fabianupn/FabianRuizEmbebidos/DATASHEEP/diseño en diagramas de bloques del embebido.pptx

IMPLEMENTAR EL PROCESO DE COMUNICACIÓN INALÁMBRICA PARA EL DISPOSITIVO DE PRUEBAS DE DESMINADO HUMANITARIO MEDICI

## Slide 2

IMPLEMENTAR EL PROCESO DE COMUNICACIÓN INALÁMBRICA PARA EL DISPOSITIVO DE PRUEBAS DE DESMINADO HUMANITARIO MEDICI

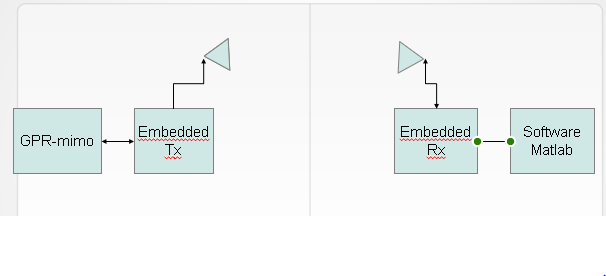
[picture p1: figure]
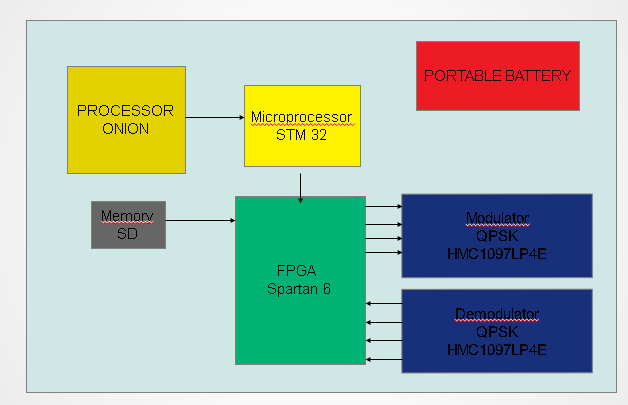
[picture p2: figure]

## Slide 3

Diseño del embebido

PORTABLE BATTERY

PROCESSOR
ONION

Memory
SD

Microprocessor
STM 32

FPGA
Spartan 6

Modulator
QPSK
HMC1097LP4E

Demodulator
QPSK
HMC1097LP4E

## Slide 4
