fabianupn/FabianRuizEmbebidos/Kicad/Partes_digikey_precio.ods

Referencia | Valor | Digikey | Qty | valor_uni_dolar |  |  |  |  | digikey
> C4, C12, C16, C19-C22, C25-C34, C36, C38-C40, C45, C46, C52, C72 | 0.1uF | 1276-1000-1-ND | 55 | 0,1 |  |  | > C4, C12, C16, C19-C22, C25-C34, C36, C38-C40, C45, C46, C52, C72 | 0.1uF | 1276-1000-1-ND | 55
> C1-C3, C6, C8, C9, C11 | 22uF | 1276-6504-1-ND | 7 | 0,34 |  |  | > C1-C3, C6, C8, C9, C11 | 22uF | 1276-6504-1-ND | 7
> C14, C18, C35, C44 | 1uF | 1276-1182-1-ND | 5 | 0,1 |  |  | > C14, C18, C35, C44 | 1uF | 1276-1182-1-ND | 5
> C13, C15, C76, C77, C81, C84, C102, C104, C106, C108, C112, C116 | 2.2uF | 1276-1085-1-ND | 14 | 0,11 | 0 |  | > C13, C15, C76, C77, C81, C84, C102, C104, C106, C108, C112, C116 | 2.2uF | 1276-1085-1-ND | 14
> C17, C47-C49, C53, C54, C57-C61, C63-C66, C82 | 4.7uF | 1276-1045-1-ND | 18 | 0,1 |  |  | > C17, C47-C49, C53, C54, C57-C61, C63-C66, C82 | 4.7uF | 1276-1045-1-ND | 18
> C23, C24 | 10pF | 1276-1027-1-ND | 3 | 0,1 |  |  | > C23, C24 | 10pF | 1276-1027-1-ND | 3
C37 | 10nF | 1276-1009-1-ND | 2 | 0,1 |  |  | C37 | 10nF | 1276-1009-1-ND | 2
> C41, C74 | 10uF | 1276-1192-1-ND | 3 | 0,29 |  |  | > C41, C74 | 10uF | 1276-1192-1-ND | 3
> C42, C43 | 6pF | 1276-2133-1-ND | 3 | 0,1 |  |  | > C42, C43 | 6pF | 1276-2133-1-ND | 3
> C50, C51, C55, C56, C62, C67-C71 | 0.47uF | 1276-2082-1-ND | 10 | 0,1 |  |  | > C50, C51, C55, C56, C62, C67-C71 | 0.47uF | 1276-2082-1-ND | 10
> C75, C78 | 1.8pF | 1276-2218-1-ND | 2 | 0,1 |  |  | > C75, C78 | 1.8pF | 1276-2218-1-ND | 2
C86 | 33pF | 1276-1070-1-ND | 2 | 0,1 |  |  | C86 | 33pF | 1276-1070-1-ND | 2
> C88, C93, C94 | 330nF | 1276-2048-1-ND | 4 | 0,13 |  |  | > C88, C93, C94 | 330nF | 1276-2048-1-ND | 4
C89 | 47pF | 1276-1037-1-ND | 2 | 0,1 |  |  | C89 | 47pF | 1276-1037-1-ND | 2
> C109, C110 | 0 | 311-0.0JRCT-ND | 3 | 0,1 |  |  | > C109, C110 | 0 | 311-0.0JRCT-ND | 3
C118 | 100pF | 1276-1909-1-ND | 2 | 0,1 |  |  | C118 | 100pF | 1276-1909-1-ND | 2
 | 2.2nF | 1276-1987-1-ND | 2 | 0,1 |  |  | 0 | 2.2nF | 1276-1987-1-ND | 2
C121 | 68pF | 1276-6538-1-ND | 2 | 0,1 |  |  | C121 | 68pF | 1276-6538-1-ND | 2
> D1, D8, D9 | LED_GREEN | 846-1176-1-ND | 3 | 0,42
> D2-D6, D12 | LED_BLUE | 160-1837-1-ND | 6 | 0,47
D7 | LED_RED | 160-1436-1-ND | 1 | 0,27
D10 | D_Zener-5.1V-1W | MMSZ5231BT1GOSCT-ND | 1 | 0,23
D11 | SP0502BAHT | F2714CT-ND | 1 | 0,73
FB1 | FILTER | BLM21PG221SN1D | 1 | 0,1
FB2 | SRF2012-900YA | SRF2012-900YACT-ND | 1 | 0,36
J1 | Conn_02x09_Odd_Even | 609-6336-ND | 1
J2 | Conn_02x08_Odd_Even | 609-6336-ND | 1
J3 | Conn_02x10_Top_Bottom | 609-3221-ND | 1
J4 | USB_B_Micro | 609-4618-1-ND | 1
J5 | USB_A | UE27AC54100-ND | 1
J6 | Conn_02x06_Odd_Even | 609-3219-ND | 1 |  |  | 846-1176-1-ND Verde
J7 | Conn_01x03_Male | 732-5316-ND | 1
> L1, L2 | bead, 600R, 350 mA | 587-1897-1-ND | 2
L3 | L | 732-1593-1-ND | 1
> P1, P2 | GSG-RF-CONN | CON-SMA-EDGE-S-ND | 2
Q1 | MOSFET_P | DMP2305UDICT-ND | 1
> R1, R49, R50, R54, R62 | 10k | 311-10KGRCT-ND | 8 | 0,1
> R2, R31, R32, R51, R52, R56, R57, R60, R61, R63 | 470 | 311-470GRCT-ND | 2 | 0,1
> R4, R5, R7, R59 | 1.8k | 311-1.8KGRTR-ND | 4 | 0,1
R6 | 1.2k | 311-1.20KHRCT-ND | 1 | 0,1
R8 | 750 | 311-750HRCT-ND | 7 | 0,1
> R9-R12 | 0 | RMCF0603ZT0R00CT-ND | 4 | 0,1
> R13-R16, R53 | 4.7k | 311-4.70KHRCT-ND | 1 | 0,1
> R3, R17-R20, R55 | 1k | 311-1.00KHRCT-ND | 9 | 0,1
> R21-R23 | 39 | 311-39.0HRCT-ND | 3 | 0,1
> R24-R30, R33-R48 | 200 | 311-200GRCT-ND | 2 | 0,1
R58 | 100 | 311-100HRCT-ND | 5 | 0,1
> R64, R65 | 1.5k | 311-1.5KGRCT-ND | 2 | 0,1
> S1, S2 | FSM1LPTR | 450-1756-1-ND | 2
> S3-S5 | TL1014BF160QG | EG5042CT-ND | 3
> T1, T2 | BALUN | 445-172632-1-ND | 2
U1 | MAX2830 | MAX2830ETM+TCT-ND | 1
U2 | SI5351C | 336-5160-1-ND | 1
U3 | MAX5864 | MAX5864ETM+-ND | 1
U4 | XC6SLX9-2TQG144C | 122-1745-ND | 1
U5 | STM32F722ZET | 497-18558-ND | 1
> U6, U7 | ZLDO1117G33TA | ZLDO1117G33DICT-ND | 2
U8 | ZLDO1117G12TA | ZLDO1117G12DICT-ND | 1
X1 | GSG-XTAL4PIN-25MHz | 535-13468-1-ND | 1
X2 | ASE-xxxMHz | 535-11114-1-ND | 1
X3 | CRYSTAL | 644-1171-1-ND | 1
X4 | GSG-XTAL4PIN-16MHz | 535-10289-1-ND | 1
Extra Capacitors 1 | 3pF | 1276-1597-1-ND | 2
Extra Capacitors 2 | 22pF | 1276-6456-1-ND | 2
Memoria FPGA | CY7C199 | 428-2013-ND | 1 | 3,5
IMU Giroscopio | LSM9DS1 | 497-14946-1-ND | 1 | 6,33
