fabianupn/FabianRuizEmbebidos/Kicad/Partes_digikey_precio_final.ods

Referencia | Valor | Digikey | Qty | valor_uni_dolar | valor_dolar
BT1 | Battery_Cell | BK-870-ND | 1 | 0,54 | 0,54
> C4, C12, C16, C19-C22, C25-C34, C36, C38-C40, C45, C46, C52, C72 | 0.1uF | 1276-1000-1-ND | 48 | 0,1 | 4,8
> C1-C3, C6, C8, C9, C11 | 22uF | 1276-6504-1-ND | 8 | 0,34 | 2,72
> C14, C18, C35, C44 | 1uF | 1276-1182-1-ND | 5 | 0,1 | 0,5
> C13, C15, C76, C77, C81, C84, C102, C104, C106, C108, C112, C116 | 2.2uF | 1276-1085-1-ND | 13 | 0,11 | 1,43
> C17, C47-C49, C53, C54, C57-C61, C63-C66, C82 | 4.7uF | 1276-1045-1-ND | 18 | 0,1 | 1,8
> C23, C24 | 10pF | 1276-1027-1-ND | 3 | 0,1 | 0,3
C37 | 10nF | 1276-1009-1-ND | 2 | 0,1 | 0,2
> C41, C74 | 10uF | 1276-1192-1-ND | 3 | 0,29 | 0,87
> C42, C43 | 6pF | 1276-2133-1-ND | 3 | 0,1 | 0,3
> C50, C51, C55, C56, C62, C67-C71 | 0.47uF | 1276-2082-1-ND | 11 | 0,1 | 1,1
> C75, C78 | 1.8pF | 1276-2218-1-ND | 3 | 0,1 | 0,3
C86 | 33pF | 1276-1070-1-ND | 2 | 0,1 | 0,2
> C88, C93, C94 | 330nF | 1276-2048-1-ND | 4 | 0,13 | 0,52
C89 | 47pF | 1276-1037-1-ND | 2 | 0,1 | 0,2
> C109, C110 | 0 hm | 311-0.0JRCT-ND | 4 | 0,1 | 0,4
C118 | 100pF | 1276-1909-1-ND | 2 | 0,1 | 0,2
C119 | 2.2nF | 1276-1987-1-ND | 2 | 0,1 | 0,2
C121 | 68pF | 1276-6538-1-ND | 2 | 0,1 | 0,2
D1 | D_Zener | MMSZ5231BT1GOSCT-ND | 2 | 0,23 | 0,46
D2 | SP0502BAHT | F2714CT-ND | 1 | 0,73 | 0,73
LED_GREEN | LED | 846-1176-1-ND | 3 | 0,42 | 1,26
LED_BLUE | LED | 160-1837-1-ND | 6 | 0,47 | 2,82
LED_RED | LED | 160-1436-1-ND | 1 | 0,27 | 0,27
FB1 | FILTER | 490-1054-1-ND | 3 | 0,1 | 0,3
J1 | USB_A | UE27AC54100-ND | 1 | 0,6 | 0,6
J2 | Barrel_Jack_Switch | CP-002A-ND | 1 | 0,6 | 0,6
J3 | Conn_02x06_Odd_Even | 609-6336-ND | 1 | 0,89 | 0,89
> J4, J6 | Conn_02x10_Odd_Even | 609-6336-ND | 2 | 0,89 | 1,78
J5 | Conn_02x06 | 609-3221-ND | 1 | 0,72 | 0,72
> J7, J8 | Conn_Coaxial | CON-SMA-EDGE-S-ND | 2 | 1,74 | 3,48
L1 | L | 732-1593-1-ND | 2 | 0,17 | 0,34
L2 | SRF2012-900YA | SRF2012-900YACT-ND | 1 | 0,36 | 0,36
L3 | bead, 600R, 350 mA | 587-1897-1-ND | 2 | 0,1 | 0,2
Q1 | MOSFET_P | DMP2305UDICT-ND | 1 | 0,51 | 0,51
> R1, R12-R15 | 100. | 311-100HRCT-ND | 6 | 0,1 | 0,6
> R2, R6, R7, R17-R19, R49 | 750. | 311-750HRCT-ND | 8 | 0,1 | 0,8
> R3, R4 | 470. | 311-470GRCT-ND | 3 | 0,1 | 0,3
> R5, R8, R16, R23-R26, R28 | 10k | 311-10KGRCT-ND | 9 | 0,1 | 0,9
> R9, R10 | 1.5k | 311-1.5KGRCT-ND | 3 | 0,1 | 0,3
> R20, R21 | 200. | 311-200GRCT-ND | 3 | 0,1 | 0,3
R22 | 4.7k | 311-4.70KHRCT-ND | 2 | 0,1 | 0,2
> R27, R29-R31 | 1.8k | 311-1.8KGRCT-ND | 5 | 0,1 | 0,5
> R32-R34 | 39. | 311-39.0HRCT-ND | 4 | 0,1 | 0,4
> R35-R43 | 1k | 311-1.00KHRCT-ND | 10 | 0,1 | 1
R46 | 1.2k | 311-1.20KHRCT-ND | 2 | 0,1 | 0,2
> R44, R45, R47, R48 | 0 ohm | RMCF0603ZT0R00CT-ND | 5 | 0,1 | 0,5
> T1, T2 | BALUN | 445-172632-1-ND | 2 | 0,35 | 0,7
> U1-U3 | ZLDO1117G33TA | ZLDO1117G33DICT-ND | 3 | 0,5 | 1,5
 | ZLDO1117G12TA | ZLDO1117G12DICT-ND | 2 | 0,5 | 1
> U4, U8, U11-U13 | FSM1LPTR | 450-1756-1-ND | 5 | 0,48 | 2,4
U5 | STM32F722ZET | 497-18558-ND | 1 | 10,74 | 10,74
U6 | LSM9DS1 | 497-14946-1-ND | 1 | 6,33 | 6,33
U9 | CY7C199 | 428-2013-ND | 1 | 3,5 | 3,5
U10 | lx9_XC6SLX9-TQ144 | 122-1745-ND | 1 | 16,52 | 16,52
U14 | SI5351C | 336-5160-1-ND | 1 | 2,42 | 2,42
U15 | MAX5864 | MAX5864ETM+-ND | 1 | 11,21 | 11,21
U16 | MAX2830 | MAX2830ETM+TCT-ND | 1 | 10,65 | 10,65
X1 | Oscillator_ASE-xxxMHz | 535-11114-1-ND | 1 | 3,3 | 3,3
Y1 | ABM8G-16.000MHZ-B4Y-T | 535-10289-1-ND | 1 | 0,73 | 0,73
Y2 | Crystal | 644-1171-1-ND | 1 | 0,68 | 0,68
Y3 | ABM8G-25.000MHZ-B4Y-T | 535-13468-1-ND | 1 | 0,74 | 0,74
 | conector furuta | 670-2760-ND | 2 | 1,4 | 2,8
 | pin conector Furura | 670-2371-1-ND | 10 | 0,135 | 1,35
 | Regleta onion 2mm x 50 pin | 1212-1317-ND | 1 | 3,32 | 3,32
 |  |  |  | total | $117,99
 |  |  |  | Dólar en pesos | $3.300.000
 |  |  |  | Pesos CO | $389.367.000
