fabianupn/FabianRuizEmbebidos/FPGA_blink_Fabian/build/par_usage_statistics.html

Par Statistics

Total Non-vccgnd Signals=35

Total Non-vccgnd Design Pins=43

Total Non-vccgnd Conns=43

Total Non-vccgnd Timing Constrained Conns=42

Phase 1 CPU=4.3 sec

Phase 2 CPU=4.4 sec

Phase 3 CPU=4.4 sec

Phase 4 CPU=4.7 sec

Phase 5 CPU=4.8 sec

Phase 6 CPU=4.8 sec

Phase 7 CPU=4.8 sec

Phase 8 CPU=4.8 sec

Phase 9 CPU=4.8 sec

Phase 10 CPU=4.8 sec

AvgWirelenPerPin Fanout 1=1.0

AvgWirelenPerPin Fanout 2=9.5

AvgWirelenPerPin Fanout 3=0.0

AvgWirelenPerPin Fanout 4=0.0

AvgWirelenPerPin Fanout 10=9.4

AvgWirelenPerPin Fanout 50=0.0

AvgWirelenPerPin Fanout 100=0.0

AvgWirelenPerPin Fanout 500=0.0

AvgWirelenPerPin Fanout 5000=0.0

AvgWirelenPerPin Fanout 20000=0.0

AvgWirelenPerPin Fanout 50000=0.0

AvgWirelenPerPin Fanout 100000=0.0

IRR Gamma=1.0000
