fabianupn/FabianRuizEmbebidos/FPGA_blink_Fabian/build/usage_statistics_webtalk.html

### Device Usage Page (usage_statistics_webtalk.html)

This HTML page displays the device usage statistics that will be sent to Xilinx.

Software Version and Target Device
Product Version: | ISE:14.7 (WebPack) - P.20131013 | Target Family: | Spartan6
OS Platform: | LIN64 | Target Device: | xc6slx9
Project ID (random number) | 10fbea5e907045f1b1f9a360dd57dfcd.abb45f5133fd478d852d747b6dedc89e.1 | Target Package: | tqg144
Registration ID | 210656542_0_0_533 | Target Speed: | -2
Date Generated | 2019-07-25T10:19:05 | Tool Flow | CommandLine

User Environment
OS Name | Ubuntu | OS Release | Ubuntu 18.04.2 LTS
CPU Name | Intel(R) Core(TM) i3-2348M CPU @ 2.30GHz | CPU Speed | 894.454 MHz
OS Name | Ubuntu | OS Release | Ubuntu 18.04.2 LTS
CPU Name | Intel(R) Core(TM) i3-2348M CPU @ 2.30GHz | CPU Speed | 1802.996 MHz

Device Usage Statistics
Macro Statistics | Miscellaneous Statistics | Net Statistics | Site Usage

MiscellaneousStatistics

AGG_BONDED_IO=3

AGG_IO=3

AGG_LOCED_IO=3

AGG_SLICE=8

NUM_BONDED_IOB=3

NUM_BSFULL=24

NUM_BSLUTONLY=1

NUM_BSREGONLY=1

NUM_BSUSED=26

NUM_BUFG=1

NUM_IOB_FF=1

NUM_LOCED_IOB=3

NUM_LOGIC_O5ANDO6=1

NUM_LOGIC_O5ONLY=23

NUM_LUT_RT_DRIVES_CARRY4=1

NUM_LUT_RT_EXO6=1

NUM_LUT_RT_O6=23

NUM_OLOGIC2=1

NUM_SLICEL=7

NUM_SLICEX=1

NUM_SLICE_CARRY4=7

NUM_SLICE_CONTROLSET=1

NUM_SLICE_CYINIT=50

NUM_SLICE_FF=25

NUM_SLICE_UNUSEDCTRL=1

NUM_UNUSABLE_FF_BELS=7

NetStatistics

NumNets_Active=39

NumNets_Vcc=1

NumNodesOfType_Active_BOUNCEIN=6

NumNodesOfType_Active_BUFGOUT=1

NumNodesOfType_Active_BUFHINP2OUT=2

NumNodesOfType_Active_CLKPIN=8

NumNodesOfType_Active_CLKPINFEED=2

NumNodesOfType_Active_DOUBLE=2

NumNodesOfType_Active_GENERIC=2

NumNodesOfType_Active_GLOBAL=11

NumNodesOfType_Active_INPUT=7

NumNodesOfType_Active_IOBIN2OUT=1

NumNodesOfType_Active_IOBOUTPUT=1

NumNodesOfType_Active_LUTINPUT=25

NumNodesOfType_Active_OUTBOUND=26

NumNodesOfType_Active_OUTPUT=34

NumNodesOfType_Active_PADINPUT=1

NumNodesOfType_Active_PADOUTPUT=1

NumNodesOfType_Active_PINBOUNCE=7

NumNodesOfType_Active_PINFEED=36

NumNodesOfType_Active_PINFEED2=1

NumNodesOfType_Active_QUAD=4

NumNodesOfType_Active_REGINPUT=1

NumNodesOfType_Active_SINGLE=4

SiteStatistics

BUFG-BUFGMUX=1

IOB-IOBS=3

SiteSummary

BUFG=1

BUFG_BUFG=1

CARRY4=7

HARD0=1

IOB=3

IOB_IMUX=2

IOB_INBUF=2

IOB_OUTBUF=1

LUT5=24

LUT6=25

OLOGIC2=1

OLOGIC2_OUTFF=1

PAD=3

PULL_OR_KEEP1=1

REG_SR=25

SLICEL=7

SLICEX=1

Configuration Data
IOB_OUTBUF DRIVEATTRBOX=[12:1] SLEW=[SLOW:1] SUSPEND=[3STATE:1] | OLOGIC2 CLK0=[CLK0_INV:0] [CLK0:1] OLOGIC2_OUTFF CK0=[CK0_INV:0] [CK0:1] OUTFFTYPE=[FF:1] SRINIT_OQ=[0:1] | PULL_OR_KEEP1 PULLTYPE=[PULLUP:1] REG_SR CK=[CK:25] [CK_INV:0] LATCH_OR_FF=[FF:25] SRINIT=[SRINIT0:25] SYNC_ATTR=[ASYNC:25] | SLICEL CLK=[CLK:6] [CLK_INV:0] SLICEX CLK=[CLK:1] [CLK_INV:0]

Pin Data
BUFG I0=1 O=1 BUFG_BUFG I0=1 O=1 CARRY4 CIN=6 CO3=6 CYINIT=1 DI0=6 DI1=6 DI2=6 DI3=6 O0=7 O1=6 O2=6 O3=6 S0=7 S1=6 S2=6 S3=6 | HARD0 0=1 IOB I=2 O=1 PAD=3 IOB_IMUX I=2 OUT=2 IOB_INBUF OUT=2 PAD=2 IOB_OUTBUF IN=1 OUT=1 LUT5 O5=24 LUT6 A4=24 A6=25 O6=25 OLOGIC2 CLK0=1 D1=1 OQ=1 | OLOGIC2_OUTFF CK0=1 D1=1 Q=1 PAD PAD=3 PULL_OR_KEEP1 PAD=1 REG_SR CK=25 D=25 Q=25 SLICEL A4=6 A6=7 AMUX=1 AQ=6 B4=6 B6=6 BQ=6 C4=6 C6=6 CIN=6 CLK=6 COUT=6 CQ=6 D4=6 D6=6 DQ=6 | SLICEX AQ=1 AX=1 CLK=1

Software Quality
Run Statistics
Program Name | Runs Started | Runs Finished | Errors | Fatal Errors | Internal Errors | Exceptions | Core Dumps
bitgen | 212 | 212 | 0 | 0 | 0 | 0 | 0
map | 225 | 214 | 0 | 0 | 0 | 0 | 0
netgen | 43 | 43 | 0 | 0 | 0 | 0 | 0
ngdbuild | 225 | 224 | 0 | 0 | 0 | 0 | 0
par | 214 | 212 | 0 | 0 | 0 | 0 | 0
trce | 128 | 128 | 0 | 0 | 0 | 0 | 0
xst | 309 | 304 | 0 | 0 | 0 | 0 | 0

Unisim Statistics
NGDBUILD_PRE_UNISIM_SUMMARY
NGDBUILD_NUM_BUFGP=1 | NGDBUILD_NUM_FD=26 | NGDBUILD_NUM_GND=1 | NGDBUILD_NUM_INV=1
NGDBUILD_NUM_LUT1=24 | NGDBUILD_NUM_MUXCY=24 | NGDBUILD_NUM_OBUF=1 | NGDBUILD_NUM_VCC=1

NGDBUILD_NUM_XORCY=25
NGDBUILD_POST_UNISIM_SUMMARY
NGDBUILD_NUM_BUFG=1 | NGDBUILD_NUM_FD=26 | NGDBUILD_NUM_GND=1 | NGDBUILD_NUM_IBUF=1
NGDBUILD_NUM_IBUFG=1 | NGDBUILD_NUM_INV=1 | NGDBUILD_NUM_LUT1=24 | NGDBUILD_NUM_MUXCY=24
NGDBUILD_NUM_OBUF=1 | NGDBUILD_NUM_PULLUP=1 | NGDBUILD_NUM_VCC=1 | NGDBUILD_NUM_XORCY=25

XST Command Line Options
XST_OPTION_SUMMARY
-top=<design_top> | -p=xc6slx9-2tqg144 | -opt_mode=Area | -opt_level=1
-ifn=<fname>.prj | -ifmt=mixed | -ofn=<design_top> | -ofmt=NGC

-rtlview=yes
