fabianupn/FabianRuizEmbebidos/onion/xc3sprog_programa_manual/xc3sprog-master/cables/ft2232_cable.pdf

### CONN1

### DLP2232M U2

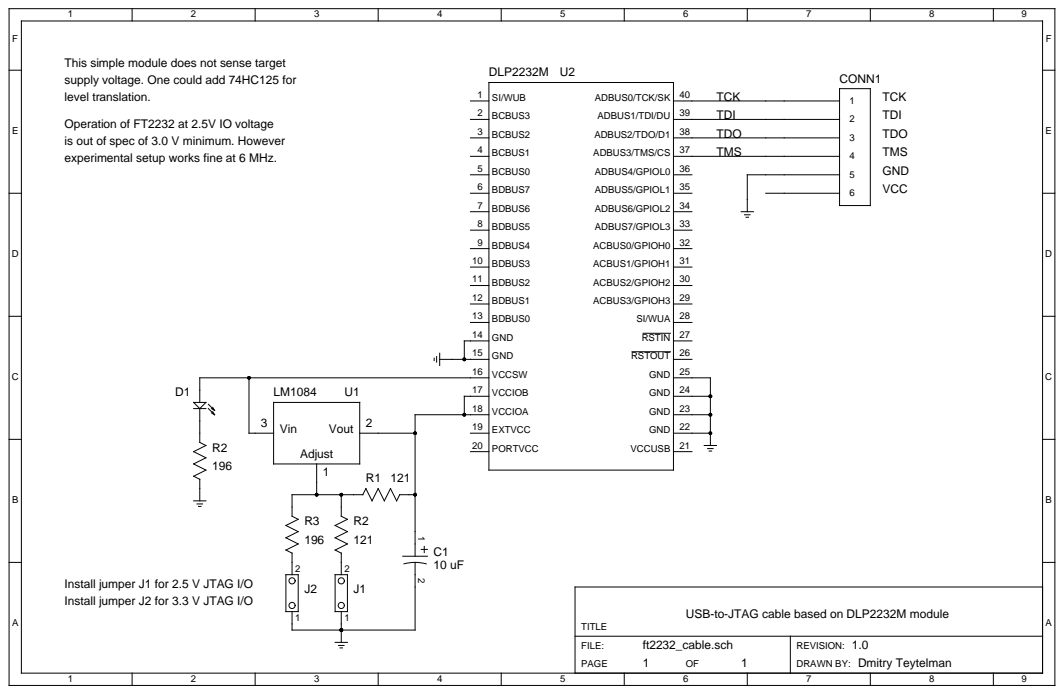
[picture p5: page 1]

This simple module does not sense target
supply voltage. One could add 74HC125 for
level translation.

Operation of FT2232 at 2.5V IO voltage
is out of spec of 3.0 V minimum. However
experimental setup works fine at 6 MHz.

Install jumper J1 for 2.5 V JTAG I/O
Install jumper J2 for 3.3 V JTAG I/O

USB-to-JTAG cable based on DLP2232M module
