fabianupn/FabianRuizEmbebidos/Kicad/power.kicad_pcb

## KiCad design Kicad/power.kicad_pcb (2019-07-23)

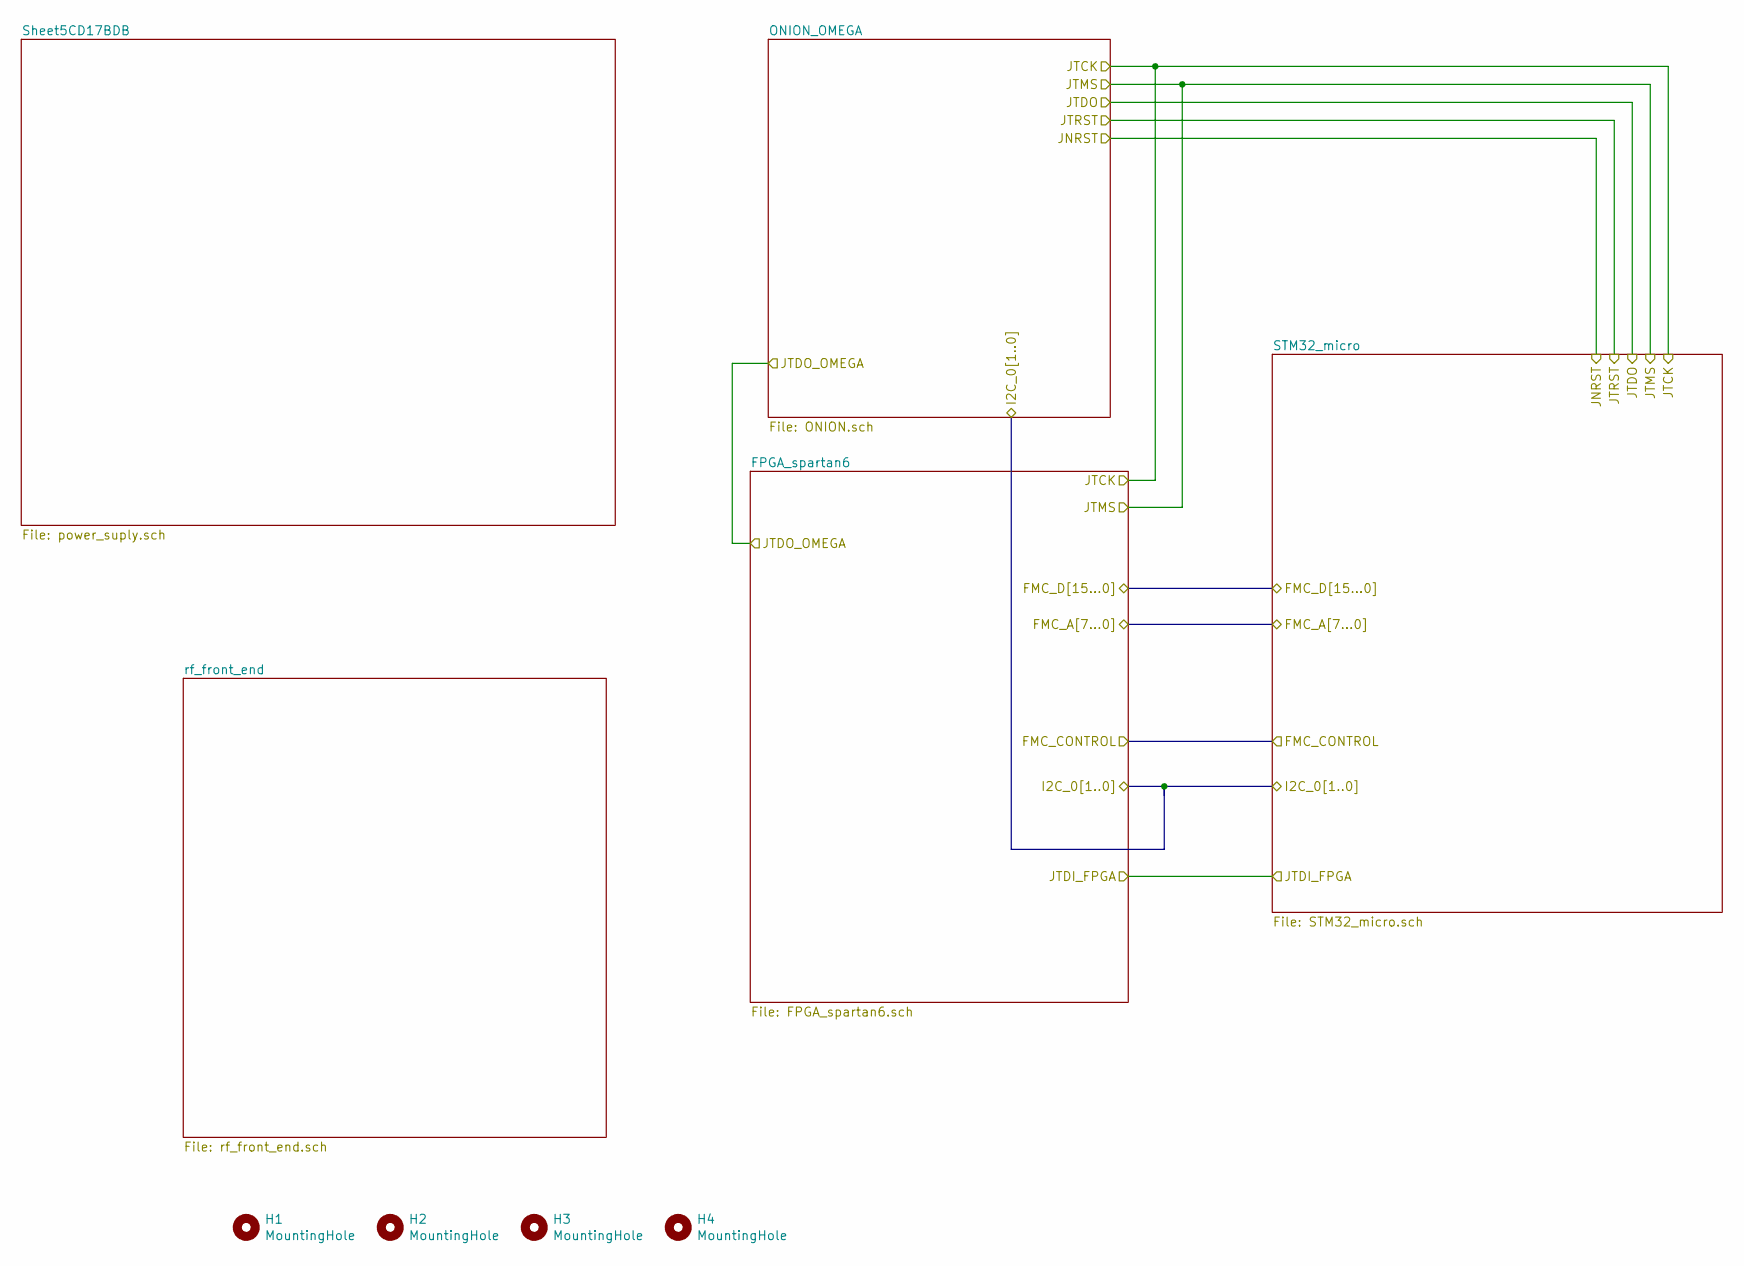
[picture p6: schematic power.sch]

Parts:
H1, H2, H3, H4: MountingHole; MountingHole_2.7mm_M2.5_ISO14580_Pad

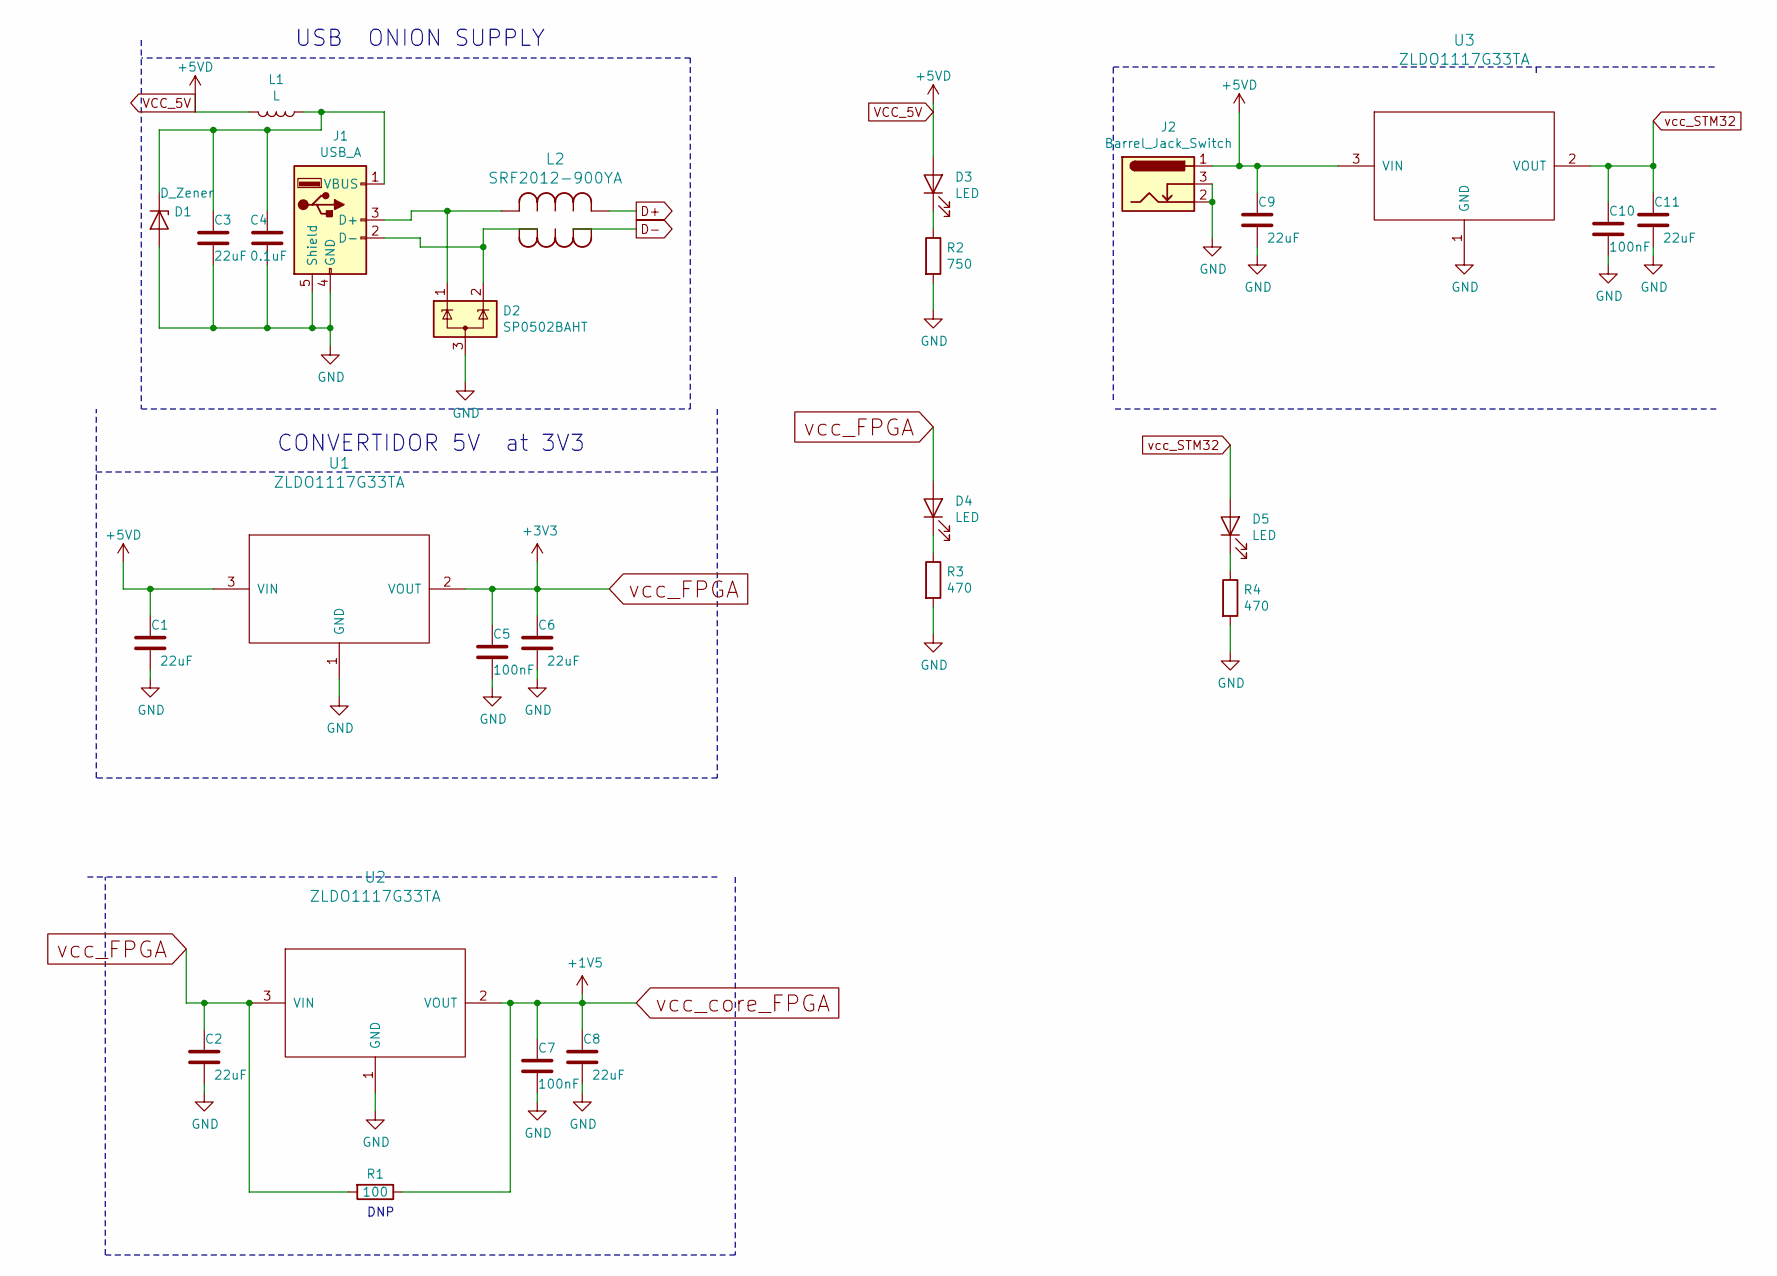
[picture p7: schematic power_suply.sch]

Parts:
C1, C2, C3, C6, C8, C9, C11: 22uF; C_0603_1608Metric_Pad1.05x0.95mm_HandSolder
C4: 0.1uF; C_0603_1608Metric_Pad1.05x0.95mm_HandSolder
C5, C7, C10: 100nF; C_0603_1608Metric_Pad1.05x0.95mm_HandSolder
D1: D_Zener; D_SOD-123; digikey MMSZ5231BT1GOSCT-ND
D2: SP0502BAHT; SOT-23
D3: LED; LED_0603_1608Metric_Pad1.05x0.95mm_HandSolder; digikey 160-1436-1-ND rojo
D4: LED; LED_0603_1608Metric_Pad1.05x0.95mm_HandSolder; digikey 846-1176-1-ND Verde
D5: LED; LED_0603_1608Metric_Pad1.05x0.95mm_HandSolder; digikey 160-1837-1-ND azul
J1: USB_A; USB_A_CNCTech_1001-011-01101_Horizontal
J2: Barrel_Jack_Switch; CUI_PJ-002A; digikey CP-002A-ND
L1: L; L_0603_1608Metric_Pad1.05x0.95mm_HandSolder; digikey 732-1593-1-ND
L2: SRF2012-900YA
R1: 100; R_0603_1608Metric_Pad1.05x0.95mm_HandSolder
R2: 750; R_0603_1608Metric_Pad1.05x0.95mm_HandSolder
R3, R4: 470; R_0603_1608Metric_Pad1.05x0.95mm_HandSolder
U1, U2, U3: ZLDO1117G33TA; SOT-223-3_TabPin2

Connections:
D+: L2.2; also elsewhere on the board
D-: L2.3; also elsewhere on the board
GND: C1.2, C2.2, C3.2, C4.2, C5.2, C6.2, C7.2, C8.2, C9.2, C10.2, C11.2, D1.2 (A), D2.3 (A), J1.4 (GND), J1.5 (Shield), J2.2, J2.3, R2.2, R3.2, R4.2, U1.1 (GND), U2.1 (GND), U3.1 (GND); also elsewhere on the board
unnamed: C3.1, C4.1, D1.1 (K), J1.1 (VBUS), L1.1
unnamed: D2.1 (K), J1.3 (D+), L2.1
unnamed: D2.2 (K), J1.2 (D-), L2.4
unnamed: D3.1 (K), R2.1
unnamed: D4.1 (K), R3.1
unnamed: D5.1 (K), R4.1
VCC_5V: C1.1, C9.1, D3.2 (A), J2.1, L1.2, U1.3 (VIN), U3.3 (VIN); also elsewhere on the board
vcc_FPGA: C2.1, C5.1, C6.1, D4.2 (A), R1.2, U1.2 (VOUT), U2.3 (VIN); also elsewhere on the board
vcc_STM32: C10.1, C11.1, D5.2 (A), U3.2 (VOUT); also elsewhere on the board
vcc_core_FPGA: C7.1, C8.1, R1.1, U2.2 (VOUT); also elsewhere on the board

Notes on the sheet:
USB ONION SUPPLY
CONVERTIDOR 5V at 3V3
DNP

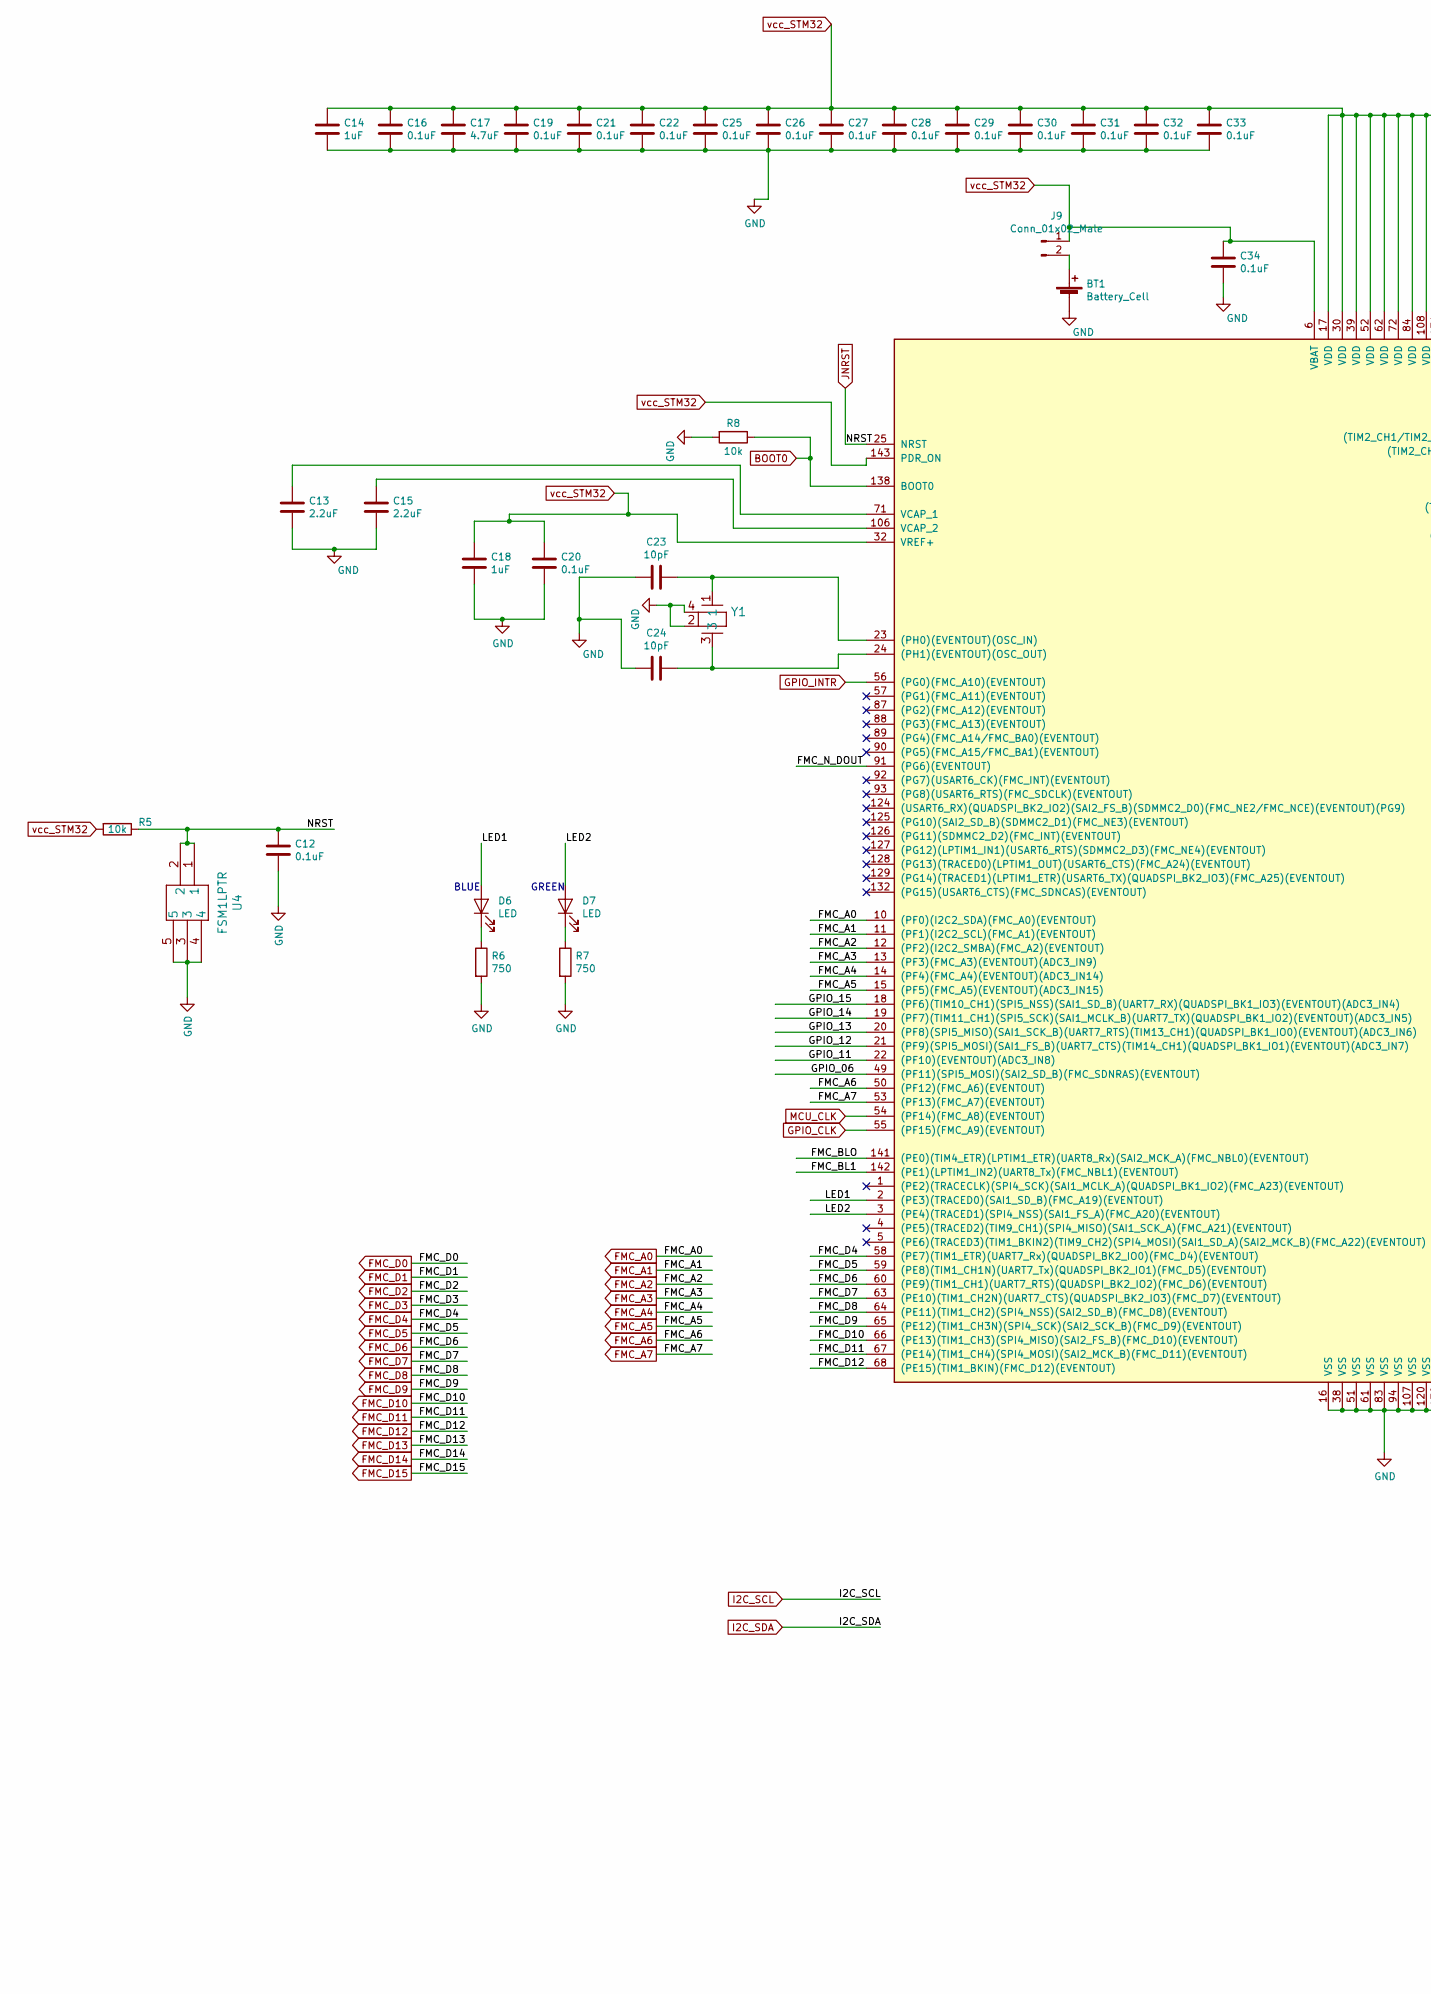
[picture p8: schematic STM32_micro.sch, part in row 1, column 1]

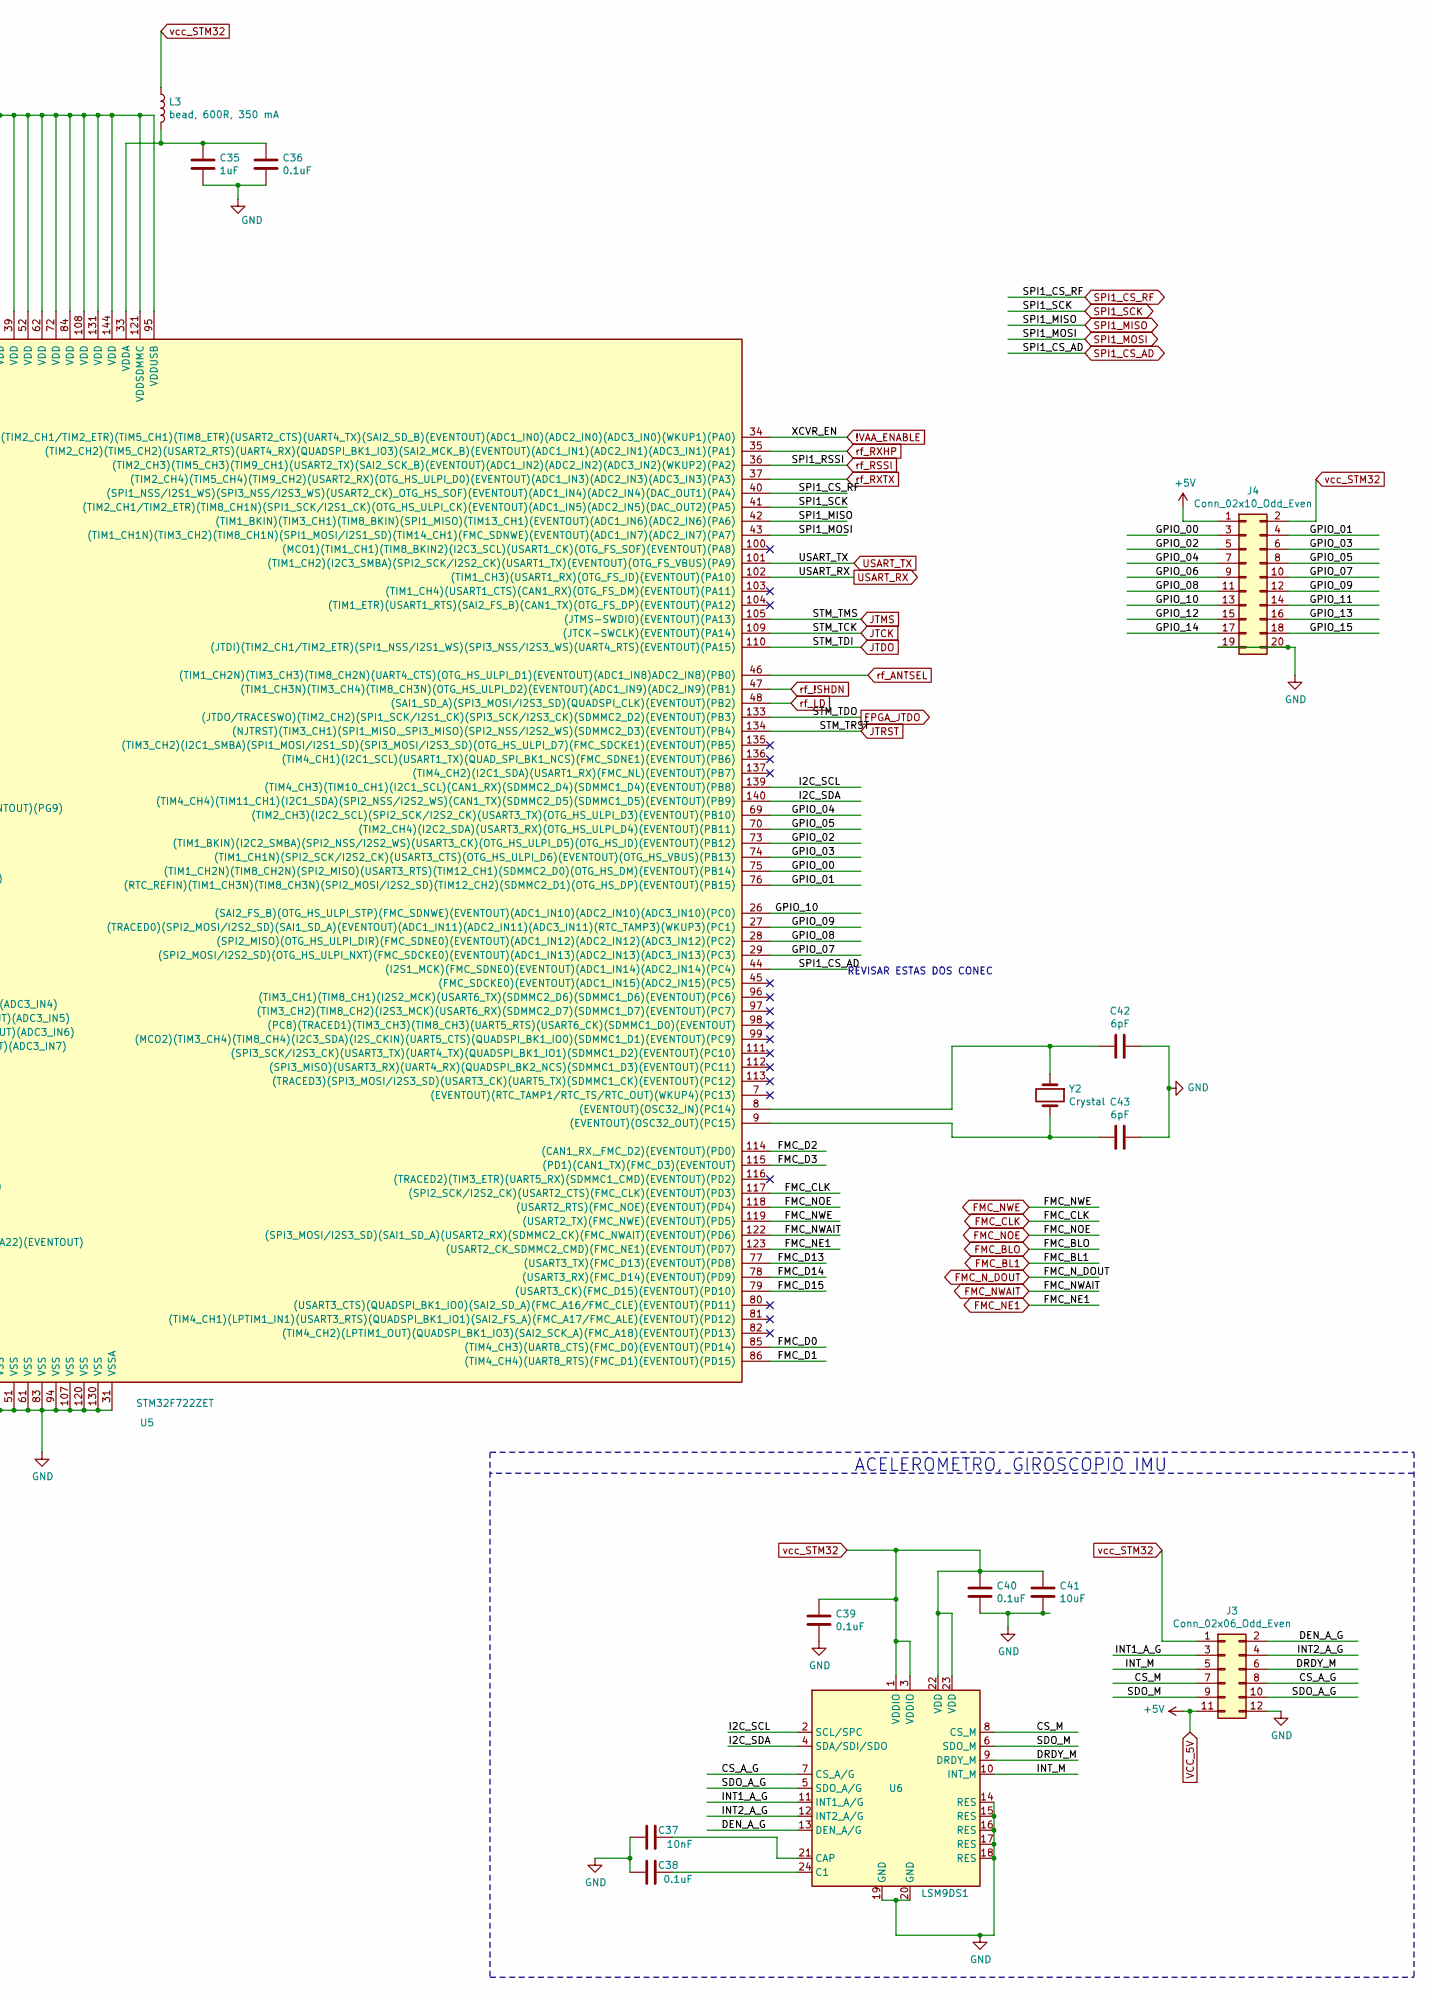
[picture p9: schematic STM32_micro.sch, part in row 1, column 2]

Parts:
BT1: Battery_Cell; MPD_BK-870
C12, C16, C19, C20, C21, C22, C25, C26, C27, C28, C29, C30, C31, C32, C33, C34, C36, C38, C39, C40: 0.1uF; C_0603_1608Metric_Pad1.05x0.95mm_HandSolder
C13, C15: 2.2uF; C_0603_1608Metric_Pad1.05x0.95mm_HandSolder
C14, C18, C35: 1uF; C_0603_1608Metric_Pad1.05x0.95mm_HandSolder
C17: 4.7uF; C_0603_1608Metric_Pad1.05x0.95mm_HandSolder
C23, C24: 10pF; C_0603_1608Metric_Pad1.05x0.95mm_HandSolder
C37: 10nF; C_0603_1608Metric_Pad1.05x0.95mm_HandSolder
C41: 10uF; C_0603_1608Metric_Pad1.05x0.95mm_HandSolder
C42, C43: 6pF; C_0603_1608Metric_Pad1.05x0.95mm_HandSolder
D6: LED; LED_0603_1608Metric_Pad1.05x0.95mm_HandSolder; digikey 160-2032-1-ND BLUE
D7: LED; LED_0603_1608Metric_Pad1.05x0.95mm_HandSolder; digikey 846-1176-1-ND Verde
J3: Conn_02x06_Odd_Even; PinHeader_2x06_P2.54mm_Vertical
J4: Conn_02x10_Odd_Even; PinHeader_2x10_P2.54mm_Vertical; digikey S6106-ND
J9: Conn_01x02_Male; PinHeader_1x02_P2.54mm_Vertical
L3: bead, 600R, 350 mA; L_0603_1608Metric_Pad1.05x0.95mm_HandSolder
R5, R8: 10k; R_0603_1608Metric_Pad1.05x0.95mm_HandSolder
R6, R7: 750; R_0603_1608Metric_Pad1.05x0.95mm_HandSolder
U4: FSM1LPTR; digikey 450-1756-1-ND
U5: STM32F722ZET; LQFP-144_20x20mm_P0.5mm; digikey 497-18558-ND
U6: LSM9DS1; LGA-24L_3x3.5mm_P0.43mm; digikey 497-14946-1-ND
Y1: ABM8G-16.000MHZ-B4Y-T; GSG-XTAL3.2x2.5mm; digikey 535-10289-1-ND
Y2: Crystal; NX3215SA

Connections:
!VAA_ENABLE: U5.34 ((TIM2_CH1/TIM2_ETR)(TIM5_CH1)(TIM8_ETR)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); also elsewhere on the board
/STM32_micro/CS_A_G: J3.8, U6.7 (CS_A/G)
/STM32_micro/CS_M: J3.7, U6.8 (CS_M)
/STM32_micro/DEN_A_G: J3.2, U6.13 (DEN_A/G)
/STM32_micro/DRDY_M: J3.6, U6.9 (DRDY_M)
/STM32_micro/GPIO_00: J4.3, U5.75 ((TIM1_CH2N)(TIM8_CH2N)(SPI2_MISO)(USART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)
/STM32_micro/GPIO_01: J4.4, U5.76 ((RTC_REFIN)(TIM1_CH3N)(TIM8_CH3N)(SPI2_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)
/STM32_micro/GPIO_02: J4.5, U5.73 ((TIM1_BKIN)(I2C2_SMBA)(SPI2_NSS/I2S2_WS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)
/STM32_micro/GPIO_03: J4.6, U5.74 ((TIM1_CH1N)(SPI2_SCK/I2S2_CK)(USART3_CT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)
/STM32_micro/GPIO_04: J4.7, U5.69 ((TIM2_CH3)(I2C2_SCL)(SPI2_SCK/I2S2_CK)(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)
/STM32_micro/GPIO_05: J4.8, U5.70 ((TIM2_CH4)(I2C2_SDA)(USART3_RX)(OTG_HS_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)
/STM32_micro/GPIO_06: J4.9, U5.49 ((PF11)(SPI5_MOSI)(SAI2_SD_B)(FMC_SDNRAS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)
/STM32_micro/GPIO_07: J4.10, U5.29 ((SPI2_MOSI/I2S2_SD)(OTG_HS_ULPI_NXT)(FM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)
/STM32_micro/GPIO_08: J4.11, U5.28 ((SPI2_MISO)(OTG_HS_ULPI_DIR)(FMC_SDNE0)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)
/STM32_micro/GPIO_09: J4.12, U5.27 ((TRACED0)(SPI2_MOSI/I2S2_SD)(SAI1_SD_A)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)
/STM32_micro/GPIO_10: J4.13, U5.26 ((SAI2_FS_B)(OTG_HS_ULPI_STP)(FMC_SDNWE)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)
/STM32_micro/GPIO_11: J4.14, U5.22 ((PF10)(EVENTOUT)(ADC3_IN8))
/STM32_micro/GPIO_12: J4.15, U5.21 ((PF9)(SPI5_MOSI)(SAI1_FS_B)(UART7_CTS)(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)
/STM32_micro/GPIO_13: J4.16, U5.20 ((PF8)(SPI5_MISO)(SAI1_SCK_B)(UART7_RTS)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)
/STM32_micro/GPIO_14: J4.17, U5.19 ((PF7)(TIM11_CH1)(SPI5_SCK)(SAI1_MCLK_B)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)
/STM32_micro/GPIO_15: J4.18, U5.18 ((PF6)(TIM10_CH1)(SPI5_NSS)(SAI1_SD_B)(U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)
/STM32_micro/INT1_A_G: J3.3, U6.11 (INT1_A/G)
/STM32_micro/INT2_A_G: J3.4, U6.12 (INT2_A/G)
/STM32_micro/INT_M: J3.5, U6.10 (INT_M)
/STM32_micro/LED1: D6.2 (A), U5.2 ((PE3)(TRACED0)(SAI1_SD_B)(FMC_A19)(EVEN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)
/STM32_micro/LED2: D7.2 (A), U5.3 ((PE4)(TRACED1)(SPI4_NSS)(SAI1_FS_A)(FMC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)
/STM32_micro/SDO_A_G: J3.10, U6.5 (SDO_A/G)
/STM32_micro/SDO_M: J3.9, U6.6 (SDO_M)
BOOT0: R8.1, U5.138 (BOOT0); also elsewhere on the board
FMC_A0: U5.10 ((PF0)(I2C2_SDA)(FMC_A0)(EVENTOUT)); also elsewhere on the board
FMC_A1: U5.11 ((PF1)(I2C2_SCL)(FMC_A1)(EVENTOUT)); also elsewhere on the board
FMC_A2: U5.12 ((PF2)(I2C2_SMBA)(FMC_A2)(EVENTOUT)); also elsewhere on the board
FMC_A3: U5.13 ((PF3)(FMC_A3)(EVENTOUT)(ADC3_IN9)); also elsewhere on the board
FMC_A4: U5.14 ((PF4)(FMC_A4)(EVENTOUT)(ADC3_IN14)); also elsewhere on the board
FMC_A5: U5.15 ((PF5)(FMC_A5)(EVENTOUT)(ADC3_IN15)); also elsewhere on the board
FMC_A6: U5.50 ((PF12)(FMC_A6)(EVENTOUT)); also elsewhere on the board
FMC_A7: U5.53 ((PF13)(FMC_A7)(EVENTOUT)); also elsewhere on the board
FMC_BL1: U5.142 ((PE1)(LPTIM1_IN2)(UART8_Tx)(FMC_NBL1)(E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); also elsewhere on the board
FMC_BLO: U5.141 ((PE0)(TIM4_ETR)(LPTIM1_ETR)(UART8_Rx)(S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); also elsewhere on the board
FMC_CLK: U5.117 ((SPI2_SCK/I2S2_CK)(USART2_CTS)(FMC_CLK)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); also elsewhere on the board
FMC_D0: U5.85 ((TIM4_CH3)(UART8_CTS)(FMC_D0)(EVENTOUT)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); also elsewhere on the board
FMC_D1: U5.86 ((TIM4_CH4)(UART8_RTS)(FMC_D1)(EVENTOUT)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); also elsewhere on the board
FMC_D2: U5.114 ((CAN1_RX,_FMC_D2)(EVENTOUT)(PD0)); also elsewhere on the board
FMC_D3: U5.115 ((PD1)(CAN1_TX)(FMC_D3)(EVENTOUT)); also elsewhere on the board
FMC_D4: U5.58 ((PE7)(TIM1_ETR)(UART7_Rx)(QUADSPI_BK2_I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); also elsewhere on the board
FMC_D5: U5.59 ((PE8)(TIM1_CH1N)(UART7_Tx)(QUADSPI_BK2_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); also elsewhere on the board
FMC_D6: U5.60 ((PE9)(TIM1_CH1)(UART7_RTS)(QUADSPI_BK2_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); also elsewhere on the board
FMC_D7: U5.63 ((PE10)(TIM1_CH2N)(UART7_CTS)(QUADSPI_BK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); also elsewhere on the board
FMC_D8: U5.64 ((PE11)(TIM1_CH2)(SPI4_NSS)(SAI2_SD_B)(F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); also elsewhere on the board
FMC_D9: U5.65 ((PE12)(TIM1_CH3N)(SPI4_SCK)(SAI2_SCK_B)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); also elsewhere on the board
FMC_D10: U5.66 ((PE13)(TIM1_CH3)(SPI4_MISO)(SAI2_FS_B)(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); also elsewhere on the board
FMC_D11: U5.67 ((PE14)(TIM1_CH4)(SPI4_MOSI)(SAI2_MCK_B)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); also elsewhere on the board
FMC_D12: U5.68 ((PE15)(TIM1_BKIN)(FMC_D12)(EVENTOUT)); also elsewhere on the board
FMC_D13: U5.77 ((USART3_TX)(FMC_D13)(EVENTOUT)(PD8)); also elsewhere on the board
FMC_D14: U5.78 ((USART3_RX)(FMC_D14)(EVENTOUT)(PD9)); also elsewhere on the board
FMC_D15: U5.79 ((USART3_CK)(FMC_D15)(EVENTOUT)(PD10)); also elsewhere on the board
FMC_NE1: U5.123 ((USART2_CK_SDMMC2_CMD)(FMC_NE1)(EVENTOU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); also elsewhere on the board
FMC_NOE: U5.118 ((USART2_RTS)(FMC_NOE)(EVENTOUT)(PD4)); also elsewhere on the board
FMC_NWAIT: U5.122 ((SPI3_MOSI/I2S3_SD)(SAI1_SD_A)(USART2_R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); also elsewhere on the board
FMC_NWE: U5.119 ((USART2_TX)(FMC_NWE)(EVENTOUT)(PD5)); also elsewhere on the board
FMC_N_DOUT: U5.91 ((PG6)(EVENTOUT)); also elsewhere on the board
FPGA_JTDO: U5.133 ((JTDO/TRACESWO)(TIM2_CH2)(SPI1_SCK/I2S1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); also elsewhere on the board
GND: BT1.2 (-), C12.2, C13.2, C14.2, C15.2, C16.2, C17.2, C18.2, C19.2, C20.2, C21.2, C22.2, C23.2, C24.1, C25.2, C26.2, C27.2, C28.2, C29.2, C30.2, C31.2, C32.2, C33.2, C34.2, C35.2, C36.2, C37.1, C38.1, C39.2, C40.2, C41.2, C42.1, C43.1, J3.12, J4.19, J4.20, R6.2, R7.2, R8.2, U4.3, U4.4, U4.5, U5.16 (VSS), U5.31 (VSSA), U5.38 (VSS), U5.51 (VSS), U5.61 (VSS), U5.83 (VSS), U5.94 (VSS), U5.107 (VSS), U5.120 (VSS), U5.130 (VSS), U6.14 (RES), U6.15 (RES), U6.16 (RES), U6.17 (RES), U6.18 (RES), U6.19 (GND), U6.20 (GND), Y1.2, Y1.4; also elsewhere on the board
GPIO_CLK: U5.55 ((PF15)(FMC_A9)(EVENTOUT)); also elsewhere on the board
GPIO_INTR: U5.56 ((PG0)(FMC_A10)(EVENTOUT)); also elsewhere on the board
I2C_SCL: U5.139 ((TIM4_CH3)(TIM10_CH1)(I2C1_SCL)(CAN1_RX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), U6.2 (SCL/SPC); also elsewhere on the board
I2C_SDA: U5.140 ((TIM4_CH4)(TIM11_CH1)(I2C1_SDA)(SPI2_NS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), U6.4 (SDA/SDI/SDO); also elsewhere on the board
JNRST: C12.1, R5.1, U4.1, U4.2, U5.25 (NRST); also elsewhere on the board
JTCK: U5.109 ((JTCK-SWCLK)(EVENTOUT)(PA14)); also elsewhere on the board
JTDO: U5.110 ((JTDI)(TIM2_CH1/TIM2_ETR)(SPI1_NSS/I2S1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); also elsewhere on the board
JTMS: U5.105 ((JTMS-SWDIO)(EVENTOUT)(PA13)); also elsewhere on the board
JTRST: U5.134 ((NJTRST)(TIM3_CH1)(SPI1_MISO,_SPI3_MISO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); also elsewhere on the board
MCU_CLK: U5.54 ((PF14)(FMC_A8)(EVENTOUT)); also elsewhere on the board
unnamed: BT1.1 (+), J9.2
unnamed: C13.1, U5.71 (VCAP_1)
unnamed: C15.1, U5.106 (VCAP_2)
unnamed: C23.1, U5.23 ((PH0)(EVENTOUT)(OSC_IN)), Y1.1
unnamed: C24.2, U5.24 ((PH1)(EVENTOUT)(OSC_OUT)), Y1.3
unnamed: C35.1, C36.1, L3.2, U5.33 (VDDA)
unnamed: C37.2, U6.21 (CAP)
unnamed: C38.2, U6.24 (C1)
unnamed: C42.2, U5.8 ((EVENTOUT)(OSC32_IN)(PC14)), Y2.1
unnamed: C43.2, U5.9 ((EVENTOUT)(OSC32_OUT)(PC15)), Y2.2
unnamed: D6.1 (K), R6.1
unnamed: D7.1 (K), R7.1
SPI1_CS_AD: U5.44 ((I2S1_MCK)(FMC_SDNE0)(EVENTOUT)(ADC1_IN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); also elsewhere on the board
SPI1_CS_RF: U5.40 ((SPI1_NSS/I2S1_WS)(SPI3_NSS/I2S3_WS)(US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); also elsewhere on the board
SPI1_MISO: U5.42 ((TIM1_BKIN)(TIM3_CH1)(TIM8_BKIN)(SPI1_M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); also elsewhere on the board
SPI1_MOSI: U5.43 ((TIM1_CH1N)(TIM3_CH2)(TIM8_CH1N)(SPI1_M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); also elsewhere on the board
SPI1_RSSI: U5.36 ((TIM2_CH3)(TIM5_CH3)(TIM9_CH1)(USART2_T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); also elsewhere on the board
SPI1_SCK: U5.41 ((TIM2_CH1/TIM2_ETR)(TIM8_CH1N)(SPI1_SCK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); also elsewhere on the board
USART_RX: U5.102 ((TIM1_CH3)(USART1_RX)(OTG_FS_ID)(EVENTO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); also elsewhere on the board
USART_TX: U5.101 ((TIM1_CH2)(I2C3_SMBA)(SPI2_SCK/I2S2_CK)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); also elsewhere on the board
VCC_5V: J3.11, J4.1; also elsewhere on the board
rf_!SHDN: U5.47 ((TIM1_CH3N)(TIM3_CH4)(TIM8_CH3N)(OTG_HS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); also elsewhere on the board
rf_ANTSEL: U5.46 ((TIM1_CH2N)(TIM3_CH3)(TIM8_CH2N)(UART4_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); also elsewhere on the board
rf_LD: U5.48 ((SAI1_SD_A)(SPI3_MOSI/I2S3_SD)(QUADSPI_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); also elsewhere on the board
rf_RXHP: U5.35 ((TIM2_CH2)(TIM5_CH2)(USART2_RTS)(UART4_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); also elsewhere on the board
rf_RXTX: U5.37 ((TIM2_CH4)(TIM5_CH4)(TIM9_CH2)(USART2_R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); also elsewhere on the board
vcc_STM32: C14.1, C16.1, C17.1, C18.1, C19.1, C20.1, C21.1, C22.1, C25.1, C26.1, C27.1, C28.1, C29.1, C30.1, C31.1, C32.1, C33.1, C34.1, C39.1, C40.1, C41.1, J3.1, J4.2, J9.1, L3.1, R5.2, U5.6 (VBAT), U5.17 (VDD), U5.30 (VDD), U5.32 (VREF+), U5.39 (VDD), U5.52 (VDD), U5.62 (VDD), U5.72 (VDD), U5.84 (VDD), U5.95 (VDDUSB), U5.108 (VDD), U5.121 (VDDSDMMC), U5.131 (VDD), U5.143 (PDR_ON), U5.144 (VDD), U6.1 (VDDIO), U6.3 (VDDIO), U6.22 (VDD), U6.23 (VDD); also elsewhere on the board

Notes on the sheet:
ACELEROMETRO, GIROSCOPIO IMU
REVISAR ESTAS DOS CONEC
BLUE
GREEN

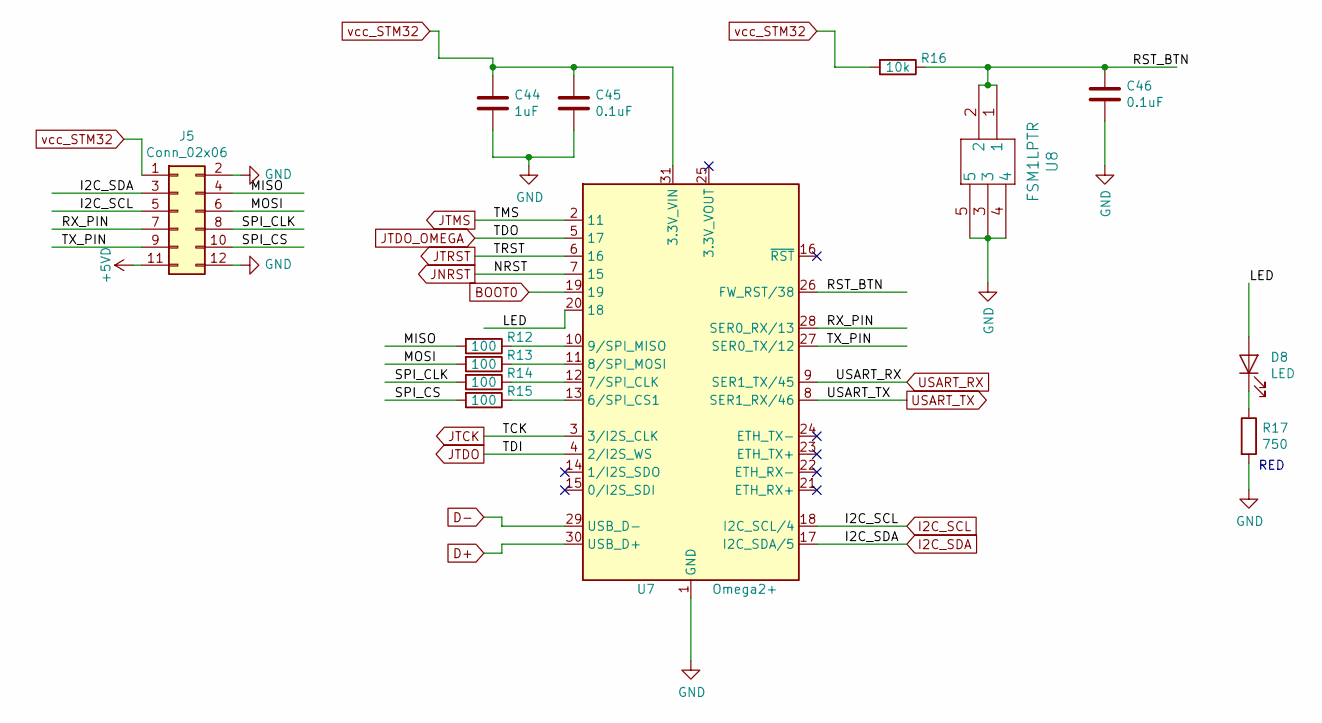
[picture p10: schematic ONION.sch]

Parts:
C44: 1uF; C_0603_1608Metric_Pad1.05x0.95mm_HandSolder
C45, C46: 0.1uF; C_0603_1608Metric_Pad1.05x0.95mm_HandSolder
D8: LED; LED_0603_1608Metric_Pad1.05x0.95mm_HandSolder; digikey 160-1436-1-ND rojo
J5: Conn_02x06; PinHeader_2x06_P2.54mm_Vertical
R12, R13, R14, R15: 100; R_0603_1608Metric_Pad1.05x0.95mm_HandSolder
R16: 10k; R_0603_1608Metric_Pad1.05x0.95mm_HandSolder
R17: 750; R_0603_1608Metric_Pad1.05x0.95mm_HandSolder
U7: Omega2+; Onion_Omega2+
U8: FSM1LPTR; digikey 450-1756-1-ND

Connections:
/ONION_OMEGA/LED: D8.2 (A), U7.20 (18)
/ONION_OMEGA/MISO: J5.4, R12.2
/ONION_OMEGA/MOSI: J5.6, R13.2
/ONION_OMEGA/RST_BTN: C46.1, R16.1, U7.26 (FW_RST/38), U8.1, U8.2
/ONION_OMEGA/RX_PIN: J5.7, U7.28 (SER0_RX/13)
/ONION_OMEGA/SPI_CLK: J5.8, R14.2
/ONION_OMEGA/SPI_CS: J5.10, R15.2
/ONION_OMEGA/TX_PIN: J5.9, U7.27 (SER0_TX/12)
BOOT0: U7.19; also elsewhere on the board
D+: U7.30 (USB_D+); also elsewhere on the board
D-: U7.29 (USB_D-); also elsewhere on the board
GND: C44.2, C45.2, C46.2, J5.2, J5.12, R17.2, U7.1 (GND), U7.32 (GND), U8.3, U8.4, U8.5; also elsewhere on the board
I2C_SCL: J5.5, U7.18 (I2C_SCL/4); also elsewhere on the board
I2C_SDA: J5.3, U7.17 (I2C_SDA/5); also elsewhere on the board
JNRST: U7.7 (15); also elsewhere on the board
JTCK: U7.3 (3/I2S_CLK); also elsewhere on the board
JTDO: U7.4 (2/I2S_WS); also elsewhere on the board
JTDO_OMEGA: U7.5 (17); also elsewhere on the board
JTMS: U7.2 (11); also elsewhere on the board
JTRST: U7.6 (16); also elsewhere on the board
unnamed: D8.1 (K), R17.1
unnamed: R12.1, U7.10 (9/SPI_MISO)
unnamed: R13.1, U7.11 (8/SPI_MOSI)
unnamed: R14.1, U7.12 (7/SPI_CLK)
unnamed: R15.1, U7.13 (6/SPI_CS1)
USART_RX: U7.9 (SER1_TX/45); also elsewhere on the board
USART_TX: U7.8 (SER1_RX/46); also elsewhere on the board
VCC_5V: J5.11; also elsewhere on the board
vcc_STM32: C44.1, C45.1, J5.1, R16.2, U7.31 (3.3V_VIN); also elsewhere on the board

Notes on the sheet:
RED
