fabianupn/FabianRuizEmbebidos/Kicad/power.kicad_pcb

## KiCad design Kicad/power.kicad_pcb (continued)

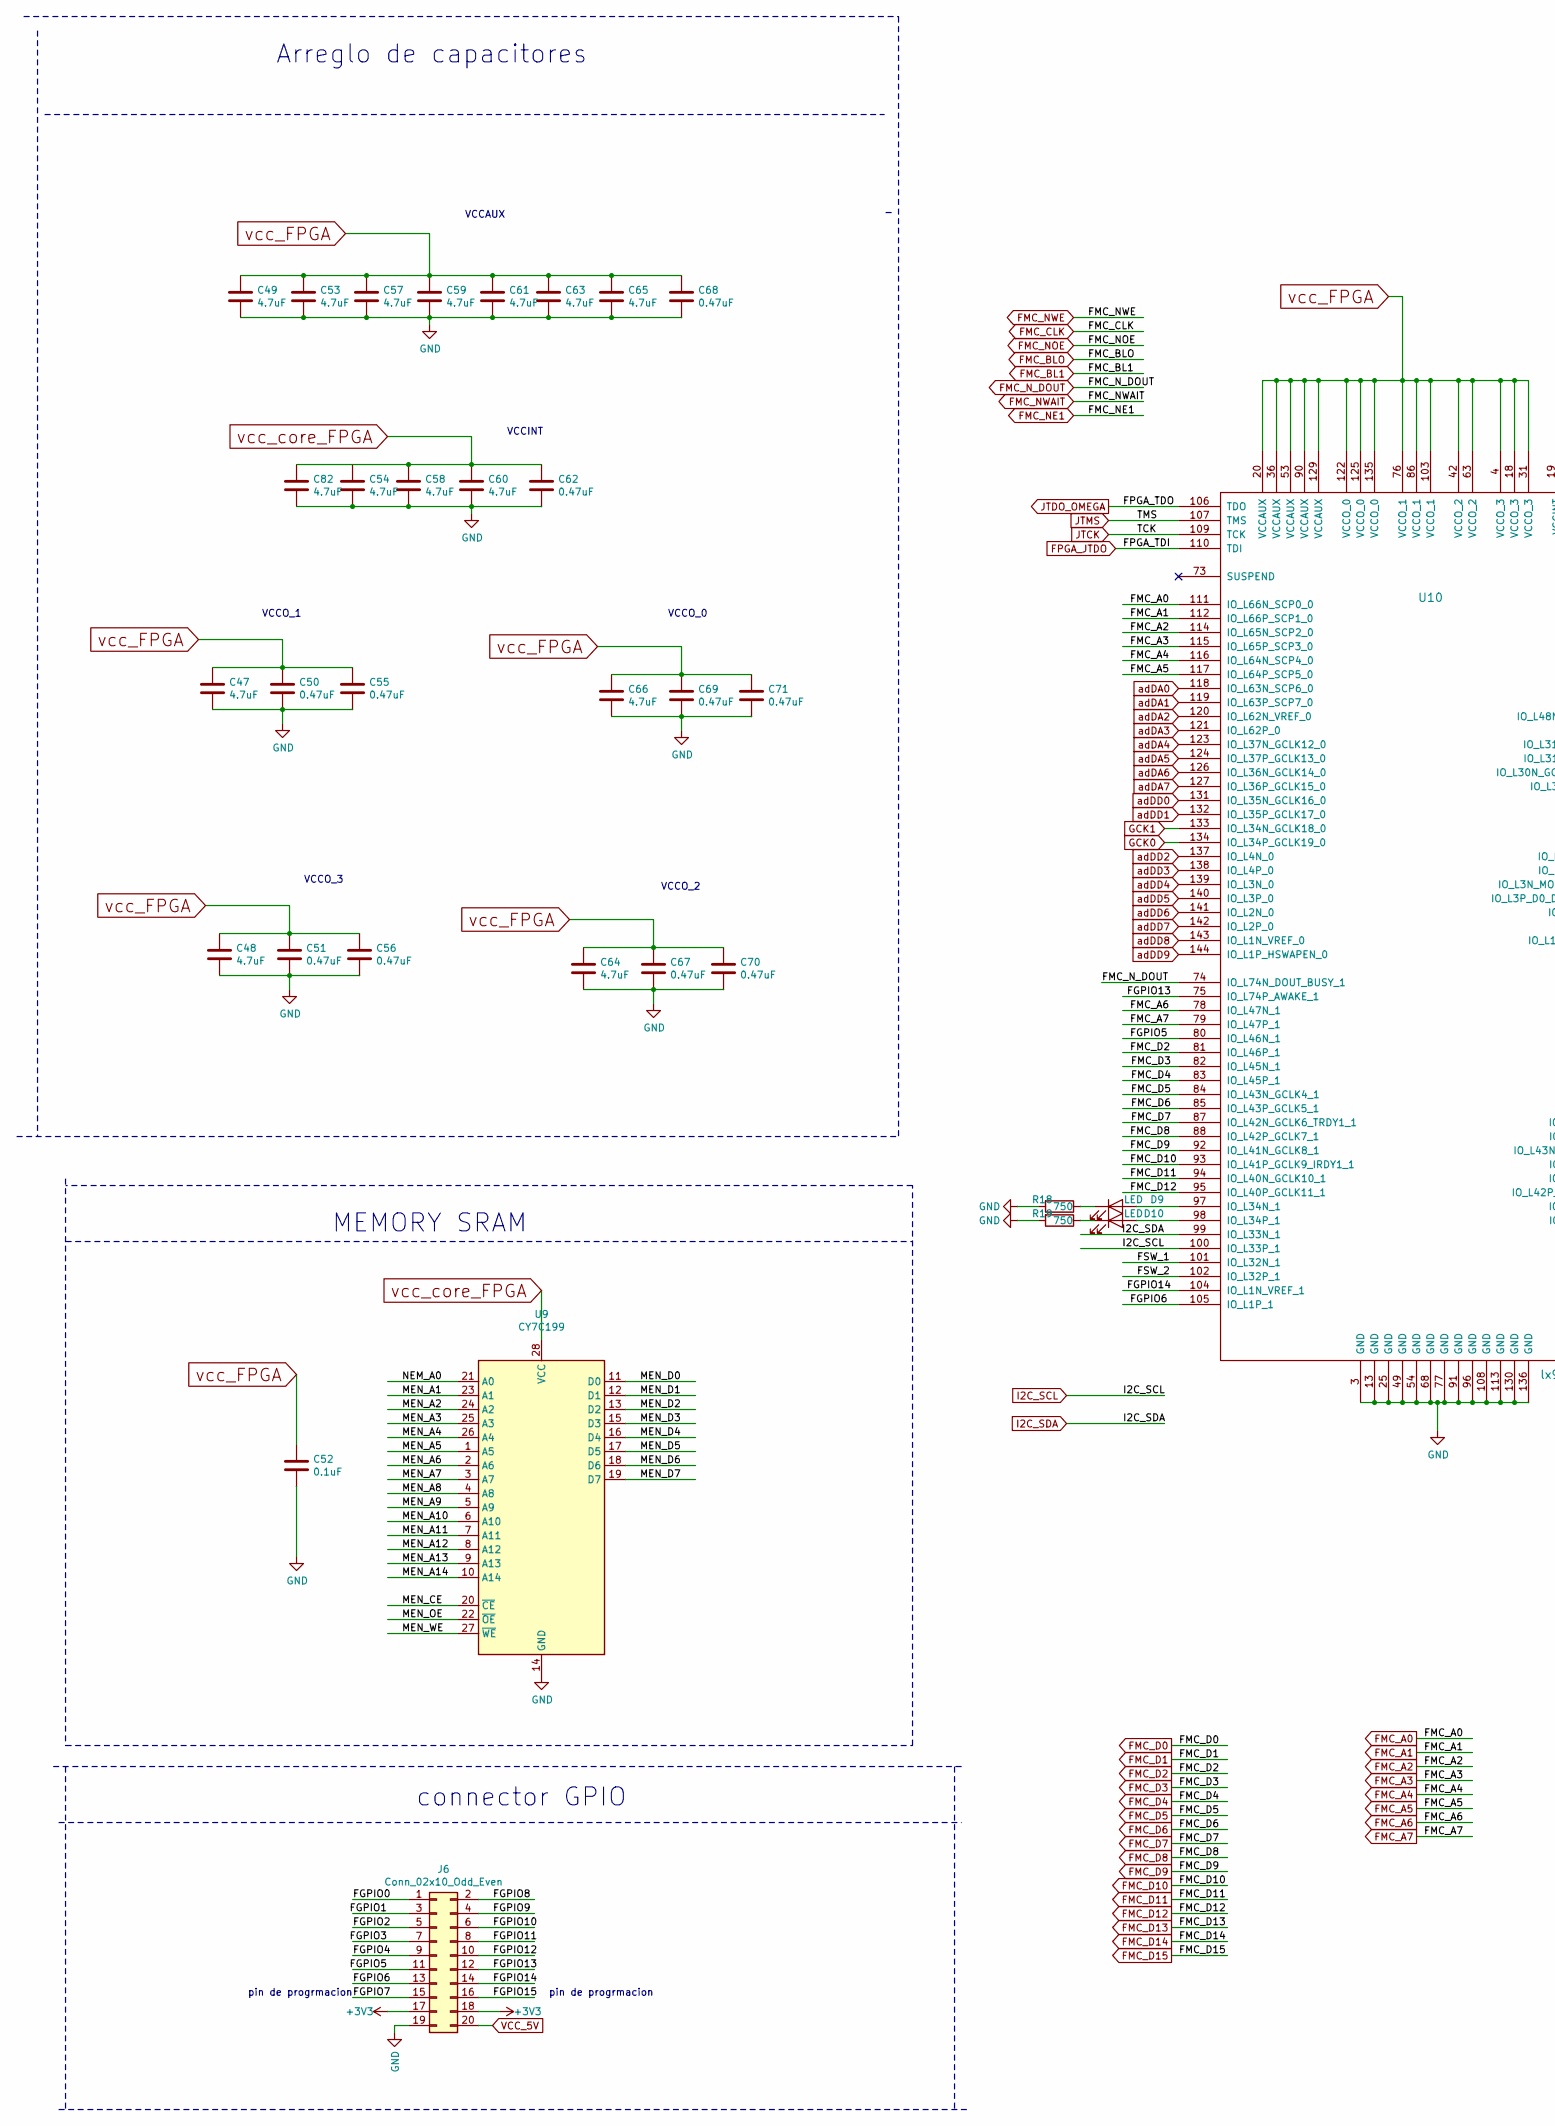
[picture p11: schematic FPGA_spartan6.sch, part in row 1, column 1]

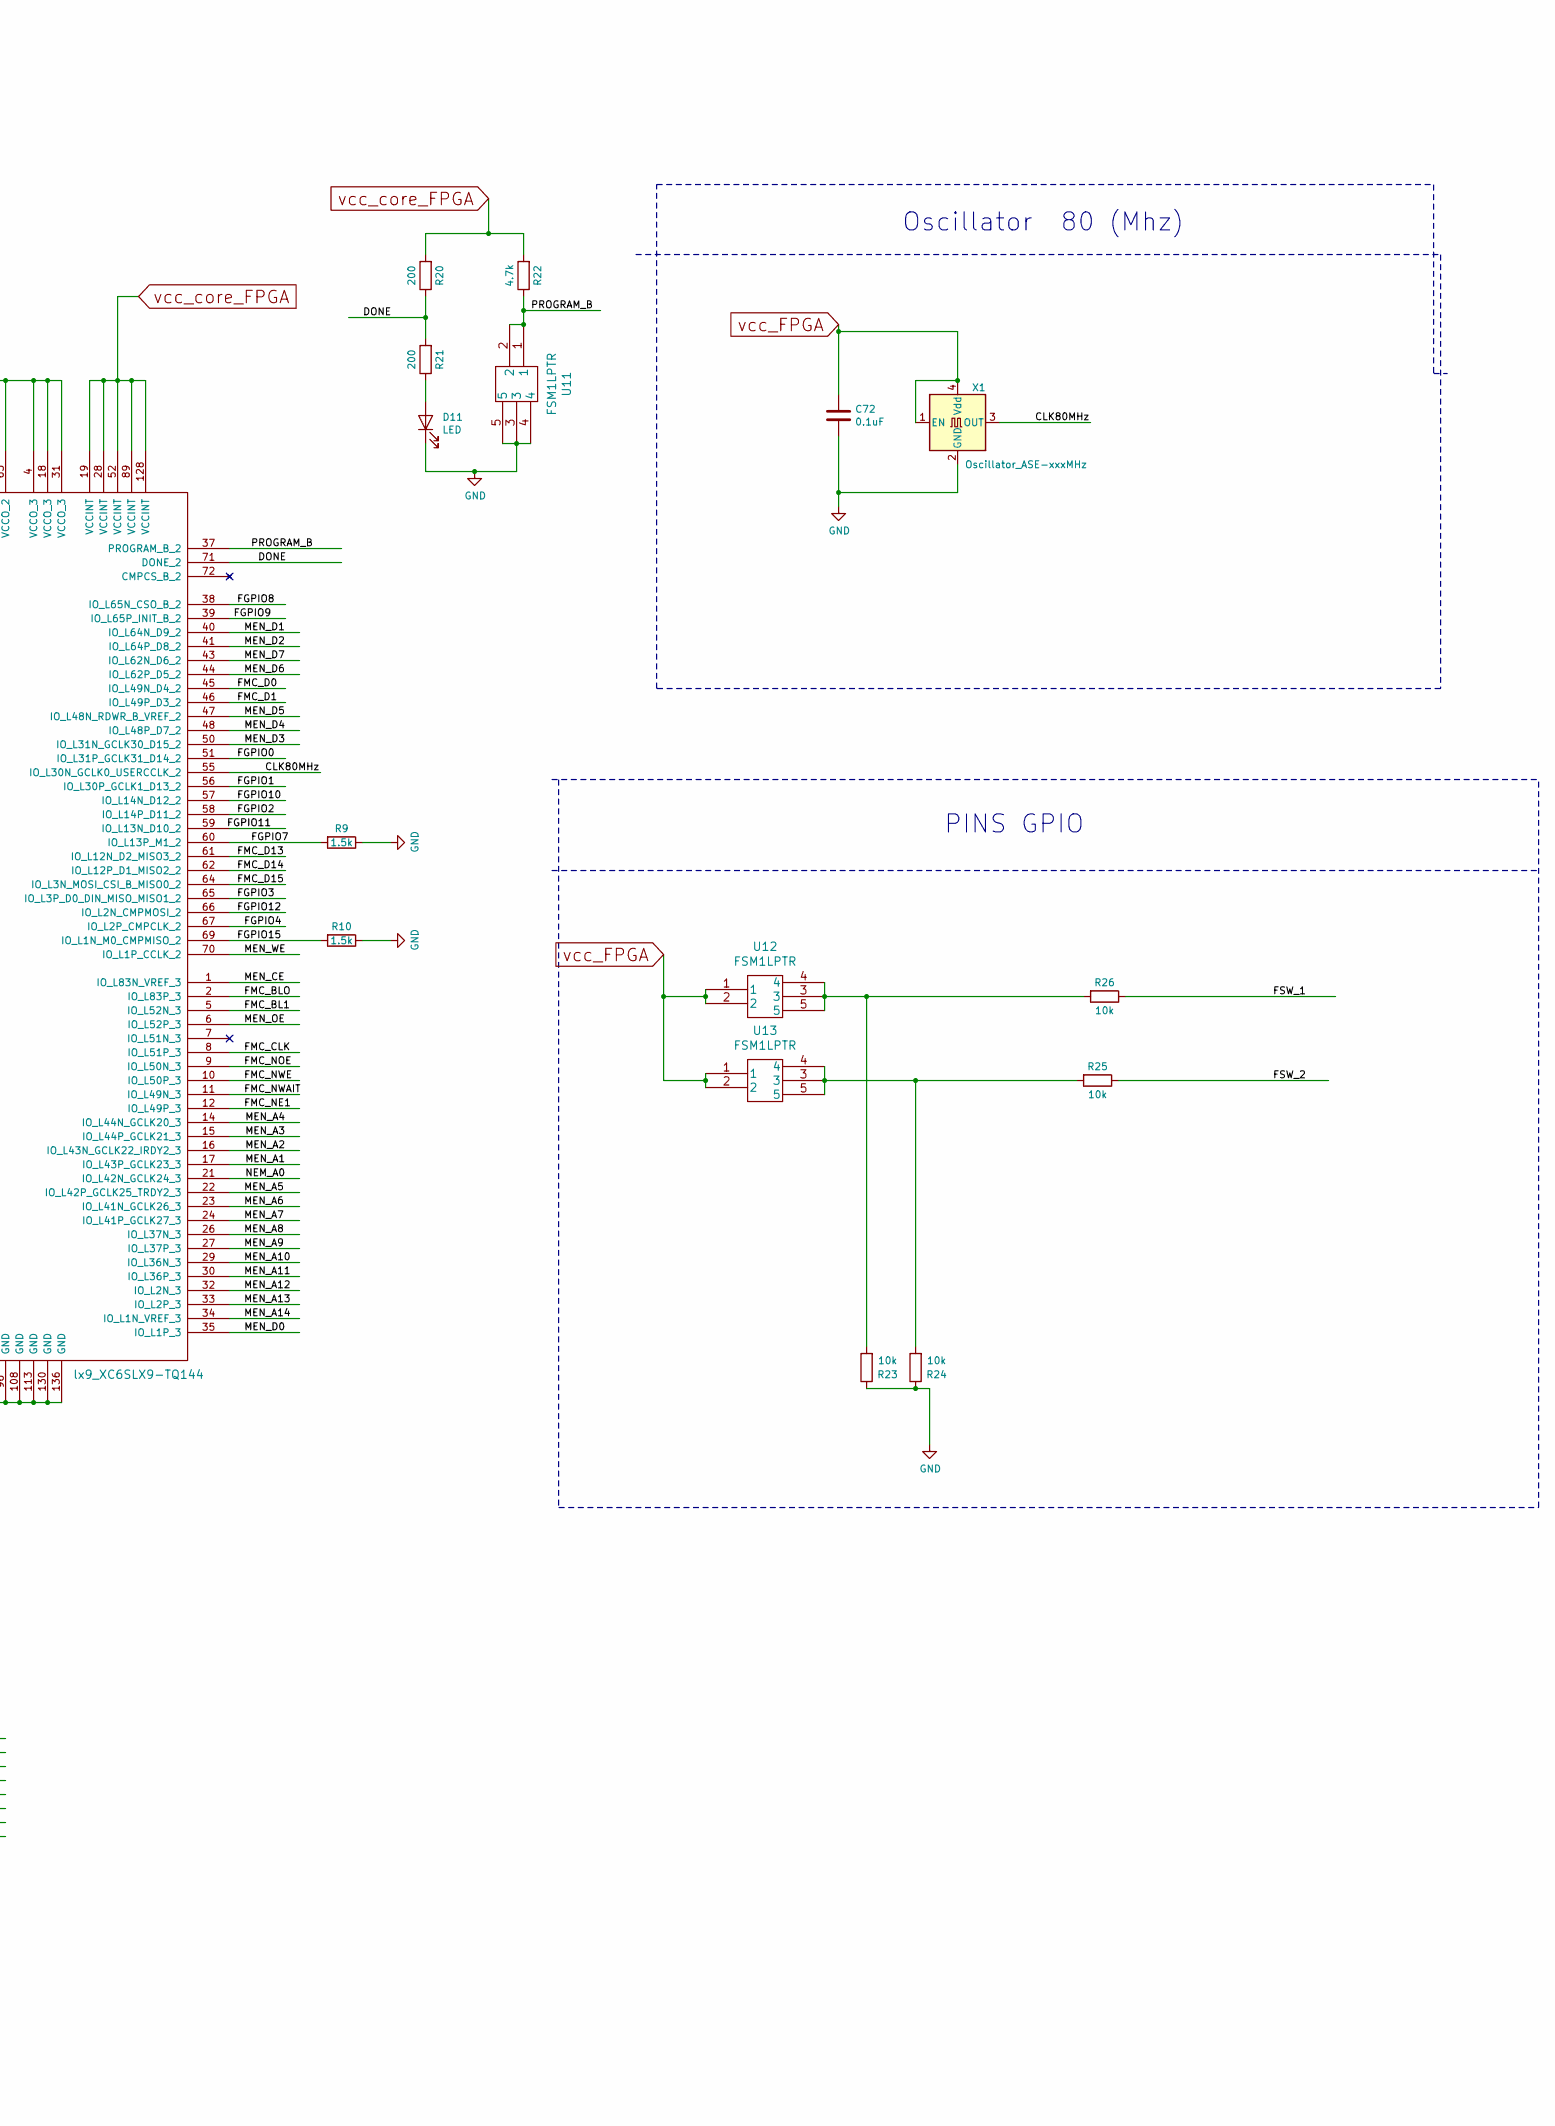
[picture p12: schematic FPGA_spartan6.sch, part in row 1, column 2]

Parts:
C47, C48, C49, C53, C54, C57, C58, C59, C60, C61, C63, C64, C65, C66, C82: 4.7uF; C_0603_1608Metric_Pad1.05x0.95mm_HandSolder
C50, C51, C55, C56, C62, C67, C68, C69, C70, C71: 0.47uF; C_0603_1608Metric_Pad1.05x0.95mm_HandSolder
C52, C72: 0.1uF; C_0603_1608Metric_Pad1.05x0.95mm_HandSolder
D9, D10: LED; LED_0603_1608Metric_Pad1.05x0.95mm_HandSolder; digikey 160-1436-1-ND rojo
D11: LED; LED_0603_1608Metric_Pad1.05x0.95mm_HandSolder; digikey 160-1445-1-ND Naranja
J6: Conn_02x10_Odd_Even; PinHeader_2x10_P2.54mm_Vertical; digikey S6106-ND
R9, R10: 1.5k; R_0603_1608Metric_Pad1.05x0.95mm_HandSolder
R18, R19: 750; R_0603_1608Metric_Pad1.05x0.95mm_HandSolder
R20, R21: 200; R_0603_1608Metric_Pad1.05x0.95mm_HandSolder
R22: 4.7k; R_0603_1608Metric_Pad1.05x0.95mm_HandSolder
R23, R24, R25, R26: 10k; R_0603_1608Metric_Pad1.05x0.95mm_HandSolder
U9: CY7C199; TSOP-I-28_11.8x8mm_P0.55mm; digikey 428-2013-ND
U10: lx9_XC6SLX9-TQ144; LQFP-144_20x20mm_P0.5mm; digiker 122-1745-ND
U11, U12, U13: FSM1LPTR; digikey 450-1756-1-ND
X1: Oscillator_ASE-xxxMHz; Oscillator_SMD_Abracon_ASE-4Pin_3.2x2.5mm_HandSoldering; digikey 535-11114-1-ND

Connections:
/FPGA_spartan6/CLK80MHz: U10.55 (IO_L30N_GCLK0_USERCCLK_2), X1.3 (OUT)
/FPGA_spartan6/DONE: R20.1, R21.2, U10.71 (DONE_2)
/FPGA_spartan6/FGPIO0: J6.1, U10.51 (IO_L31P_GCLK31_D14_2)
/FPGA_spartan6/FGPIO1: J6.3, U10.56 (IO_L30P_GCLK1_D13_2)
/FPGA_spartan6/FGPIO2: J6.5, U10.58 (IO_L14P_D11_2)
/FPGA_spartan6/FGPIO3: J6.7, U10.65 (IO_L3P_D0_DIN_MISO_MISO1_2)
/FPGA_spartan6/FGPIO4: J6.9, U10.67 (IO_L2P_CMPCLK_2)
/FPGA_spartan6/FGPIO5: J6.11, U10.80 (IO_L46N_1)
/FPGA_spartan6/FGPIO6: J6.13, U10.105 (IO_L1P_1)
/FPGA_spartan6/FGPIO7: J6.15, R9.2, U10.60 (IO_L13P_M1_2)
/FPGA_spartan6/FGPIO8: J6.2, U10.38 (IO_L65N_CSO_B_2)
/FPGA_spartan6/FGPIO9: J6.4, U10.39 (IO_L65P_INIT_B_2)
/FPGA_spartan6/FGPIO10: J6.6, U10.57 (IO_L14N_D12_2)
/FPGA_spartan6/FGPIO11: J6.8, U10.59 (IO_L13N_D10_2)
/FPGA_spartan6/FGPIO12: J6.10, U10.66 (IO_L2N_CMPMOSI_2)
/FPGA_spartan6/FGPIO13: J6.12, U10.75 (IO_L74P_AWAKE_1)
/FPGA_spartan6/FGPIO14: J6.14, U10.104 (IO_L1N_VREF_1)
/FPGA_spartan6/FGPIO15: J6.16, R10.2, U10.69 (IO_L1N_M0_CMPMISO_2)
/FPGA_spartan6/FSW_1: R26.1, U10.101 (IO_L32N_1)
/FPGA_spartan6/FSW_2: R25.1, U10.102 (IO_L32P_1)
/FPGA_spartan6/MEN_A1: U9.23 (A1), U10.17 (IO_L43P_GCLK23_3)
/FPGA_spartan6/MEN_A2: U9.24 (A2), U10.16 (IO_L43N_GCLK22_IRDY2_3)
/FPGA_spartan6/MEN_A3: U9.25 (A3), U10.15 (IO_L44P_GCLK21_3)
/FPGA_spartan6/MEN_A4: U9.26 (A4), U10.14 (IO_L44N_GCLK20_3)
/FPGA_spartan6/MEN_A5: U9.1 (A5), U10.22 (IO_L42P_GCLK25_TRDY2_3)
/FPGA_spartan6/MEN_A6: U9.2 (A6), U10.23 (IO_L41N_GCLK26_3)
/FPGA_spartan6/MEN_A7: U9.3 (A7), U10.24 (IO_L41P_GCLK27_3)
/FPGA_spartan6/MEN_A8: U9.4 (A8), U10.26 (IO_L37N_3)
/FPGA_spartan6/MEN_A9: U9.5 (A9), U10.27 (IO_L37P_3)
/FPGA_spartan6/MEN_A10: U9.6 (A10), U10.29 (IO_L36N_3)
/FPGA_spartan6/MEN_A11: U9.7 (A11), U10.30 (IO_L36P_3)
/FPGA_spartan6/MEN_A12: U9.8 (A12), U10.32 (IO_L2N_3)
/FPGA_spartan6/MEN_A13: U9.9 (A13), U10.33 (IO_L2P_3)
/FPGA_spartan6/MEN_A14: U9.10 (A14), U10.34 (IO_L1N_VREF_3)
/FPGA_spartan6/MEN_CE: U9.20 (~CE~), U10.1 (IO_L83N_VREF_3)
/FPGA_spartan6/MEN_D0: U9.11 (D0), U10.35 (IO_L1P_3)
/FPGA_spartan6/MEN_D1: U9.12 (D1), U10.40 (IO_L64N_D9_2)
/FPGA_spartan6/MEN_D2: U9.13 (D2), U10.41 (IO_L64P_D8_2)
/FPGA_spartan6/MEN_D3: U9.15 (D3), U10.50 (IO_L31N_GCLK30_D15_2)
/FPGA_spartan6/MEN_D4: U9.16 (D4), U10.48 (IO_L48P_D7_2)
/FPGA_spartan6/MEN_D5: U9.17 (D5), U10.47 (IO_L48N_RDWR_B_VREF_2)
/FPGA_spartan6/MEN_D6: U9.18 (D6), U10.44 (IO_L62P_D5_2)
/FPGA_spartan6/MEN_D7: U9.19 (D7), U10.43 (IO_L62N_D6_2)
/FPGA_spartan6/MEN_OE: U9.22 (~OE~), U10.6 (IO_L52P_3)
/FPGA_spartan6/MEN_WE: U9.27 (~WE~), U10.70 (IO_L1P_CCLK_2)
/FPGA_spartan6/NEM_A0: U9.21 (A0), U10.21 (IO_L42N_GCLK24_3)
/FPGA_spartan6/PROGRAM_B: R22.1, U10.37 (PROGRAM_B_2), U11.1, U11.2
FMC_A0: U10.111 (IO_L66N_SCP0_0); also elsewhere on the board
FMC_A1: U10.112 (IO_L66P_SCP1_0); also elsewhere on the board
FMC_A2: U10.114 (IO_L65N_SCP2_0); also elsewhere on the board
FMC_A3: U10.115 (IO_L65P_SCP3_0); also elsewhere on the board
FMC_A4: U10.116 (IO_L64N_SCP4_0); also elsewhere on the board
FMC_A5: U10.117 (IO_L64P_SCP5_0); also elsewhere on the board
FMC_A6: U10.78 (IO_L47N_1); also elsewhere on the board
FMC_A7: U10.79 (IO_L47P_1); also elsewhere on the board
FMC_BL1: U10.5 (IO_L52N_3); also elsewhere on the board
FMC_BLO: U10.2 (IO_L83P_3); also elsewhere on the board
FMC_CLK: U10.8 (IO_L51P_3); also elsewhere on the board
FMC_D0: U10.45 (IO_L49N_D4_2); also elsewhere on the board
FMC_D1: U10.46 (IO_L49P_D3_2); also elsewhere on the board
FMC_D2: U10.81 (IO_L46P_1); also elsewhere on the board
FMC_D3: U10.82 (IO_L45N_1); also elsewhere on the board
FMC_D4: U10.83 (IO_L45P_1); also elsewhere on the board
FMC_D5: U10.84 (IO_L43N_GCLK4_1); also elsewhere on the board
FMC_D6: U10.85 (IO_L43P_GCLK5_1); also elsewhere on the board
FMC_D7: U10.87 (IO_L42N_GCLK6_TRDY1_1); also elsewhere on the board
FMC_D8: U10.88 (IO_L42P_GCLK7_1); also elsewhere on the board
FMC_D9: U10.92 (IO_L41N_GCLK8_1); also elsewhere on the board
FMC_D10: U10.93 (IO_L41P_GCLK9_IRDY1_1); also elsewhere on the board
FMC_D11: U10.94 (IO_L40N_GCLK10_1); also elsewhere on the board
FMC_D12: U10.95 (IO_L40P_GCLK11_1); also elsewhere on the board
FMC_D13: U10.61 (IO_L12N_D2_MISO3_2); also elsewhere on the board
FMC_D14: U10.62 (IO_L12P_D1_MISO2_2); also elsewhere on the board
FMC_D15: U10.64 (IO_L3N_MOSI_CSI_B_MISO0_2); also elsewhere on the board
FMC_NE1: U10.12 (IO_L49P_3); also elsewhere on the board
FMC_NOE: U10.9 (IO_L50N_3); also elsewhere on the board
FMC_NWAIT: U10.11 (IO_L49N_3); also elsewhere on the board
FMC_NWE: U10.10 (IO_L50P_3); also elsewhere on the board
FMC_N_DOUT: U10.74 (IO_L74N_DOUT_BUSY_1); also elsewhere on the board
FPGA_JTDO: U10.110 (TDI); also elsewhere on the board
GCK0: U10.134 (IO_L34P_GCLK19_0); also elsewhere on the board
GCK1: U10.133 (IO_L34N_GCLK18_0); also elsewhere on the board
GND: C47.2, C48.2, C49.2, C50.2, C51.2, C52.2, C53.2, C54.2, C55.2, C56.2, C57.2, C58.2, C59.2, C60.2, C61.2, C62.2, C63.2, C64.2, C65.2, C66.2, C67.2, C68.2, C69.2, C70.2, C71.2, C72.2, C82.2, D11.1 (K), J6.19, R9.1, R10.1, R18.2, R19.2, R23.1, R24.1, U9.14 (GND), U10.3 (GND), U10.13 (GND), U10.25 (GND), U10.49 (GND), U10.54 (GND), U10.68 (GND), U10.77 (GND), U10.91 (GND), U10.96 (GND), U10.108 (GND), U10.113 (GND), U10.130 (GND), U10.136 (GND), U11.3, U11.4, U11.5, X1.2 (GND); also elsewhere on the board
I2C_SCL: U10.100 (IO_L33P_1); also elsewhere on the board
I2C_SDA: U10.99 (IO_L33N_1); also elsewhere on the board
JTCK: U10.109 (TCK); also elsewhere on the board
JTDO_OMEGA: U10.106 (TDO); also elsewhere on the board
JTMS: U10.107 (TMS); also elsewhere on the board
unnamed: D9.1 (K), R18.1
unnamed: D9.2 (A), U10.97 (IO_L34N_1)
unnamed: D10.1 (K), R19.1
unnamed: D10.2 (A), U10.98 (IO_L34P_1)
unnamed: D11.2 (A), R21.1
unnamed: R23.2, R26.2, U12.3, U12.4, U12.5
unnamed: R24.2, R25.2, U13.3, U13.4, U13.5
VCC_5V: J6.20; also elsewhere on the board
adDA0: U10.118 (IO_L63N_SCP6_0); also elsewhere on the board
adDA1: U10.119 (IO_L63P_SCP7_0); also elsewhere on the board
adDA2: U10.120 (IO_L62N_VREF_0); also elsewhere on the board
adDA3: U10.121 (IO_L62P_0); also elsewhere on the board
adDA4: U10.123 (IO_L37N_GCLK12_0); also elsewhere on the board
adDA5: U10.124 (IO_L37P_GCLK13_0); also elsewhere on the board
adDA6: U10.126 (IO_L36N_GCLK14_0); also elsewhere on the board
adDA7: U10.127 (IO_L36P_GCLK15_0); also elsewhere on the board
adDD0: U10.131 (IO_L35N_GCLK16_0); also elsewhere on the board
adDD1: U10.132 (IO_L35P_GCLK17_0); also elsewhere on the board
adDD2: U10.137 (IO_L4N_0); also elsewhere on the board
adDD3: U10.138 (IO_L4P_0); also elsewhere on the board
adDD4: U10.139 (IO_L3N_0); also elsewhere on the board
adDD5: U10.140 (IO_L3P_0); also elsewhere on the board
adDD6: U10.141 (IO_L2N_0); also elsewhere on the board
adDD7: U10.142 (IO_L2P_0); also elsewhere on the board
adDD8: U10.143 (IO_L1N_VREF_0); also elsewhere on the board
adDD9: U10.144 (IO_L1P_HSWAPEN_0); also elsewhere on the board
vcc_FPGA: C47.1, C48.1, C49.1, C50.1, C51.1, C52.1, C53.1, C55.1, C56.1, C57.1, C59.1, C61.1, C63.1, C64.1, C65.1, C66.1, C67.1, C68.1, C69.1, C70.1, C71.1, C72.1, J6.17, J6.18, U10.4 (VCCO_3), U10.18 (VCCO_3), U10.20 (VCCAUX), U10.31 (VCCO_3), U10.36 (VCCAUX), U10.42 (VCCO_2), U10.53 (VCCAUX), U10.63 (VCCO_2), U10.76 (VCCO_1), U10.86 (VCCO_1), U10.90 (VCCAUX), U10.103 (VCCO_1), U10.122 (VCCO_0), U10.125 (VCCO_0), U10.129 (VCCAUX), U10.135 (VCCO_0), U12.1, U12.2, U13.1, U13.2, X1.1 (EN), X1.4 (Vdd); also elsewhere on the board
vcc_core_FPGA: C54.1, C58.1, C60.1, C62.1, C82.1, R20.2, R22.2, U9.28 (VCC), U10.19 (VCCINT), U10.28 (VCCINT), U10.52 (VCCINT), U10.89 (VCCINT), U10.128 (VCCINT); also elsewhere on the board

Notes on the sheet:
Arreglo de capacitores
Oscillator 80 (Mhz)
MEMORY SRAM
PINS GPIO
connector GPIO
VCCAUX
VCCINT
VCCO_0
VCCO_1
VCCO_3
VCCO_2
pin de progrmacion

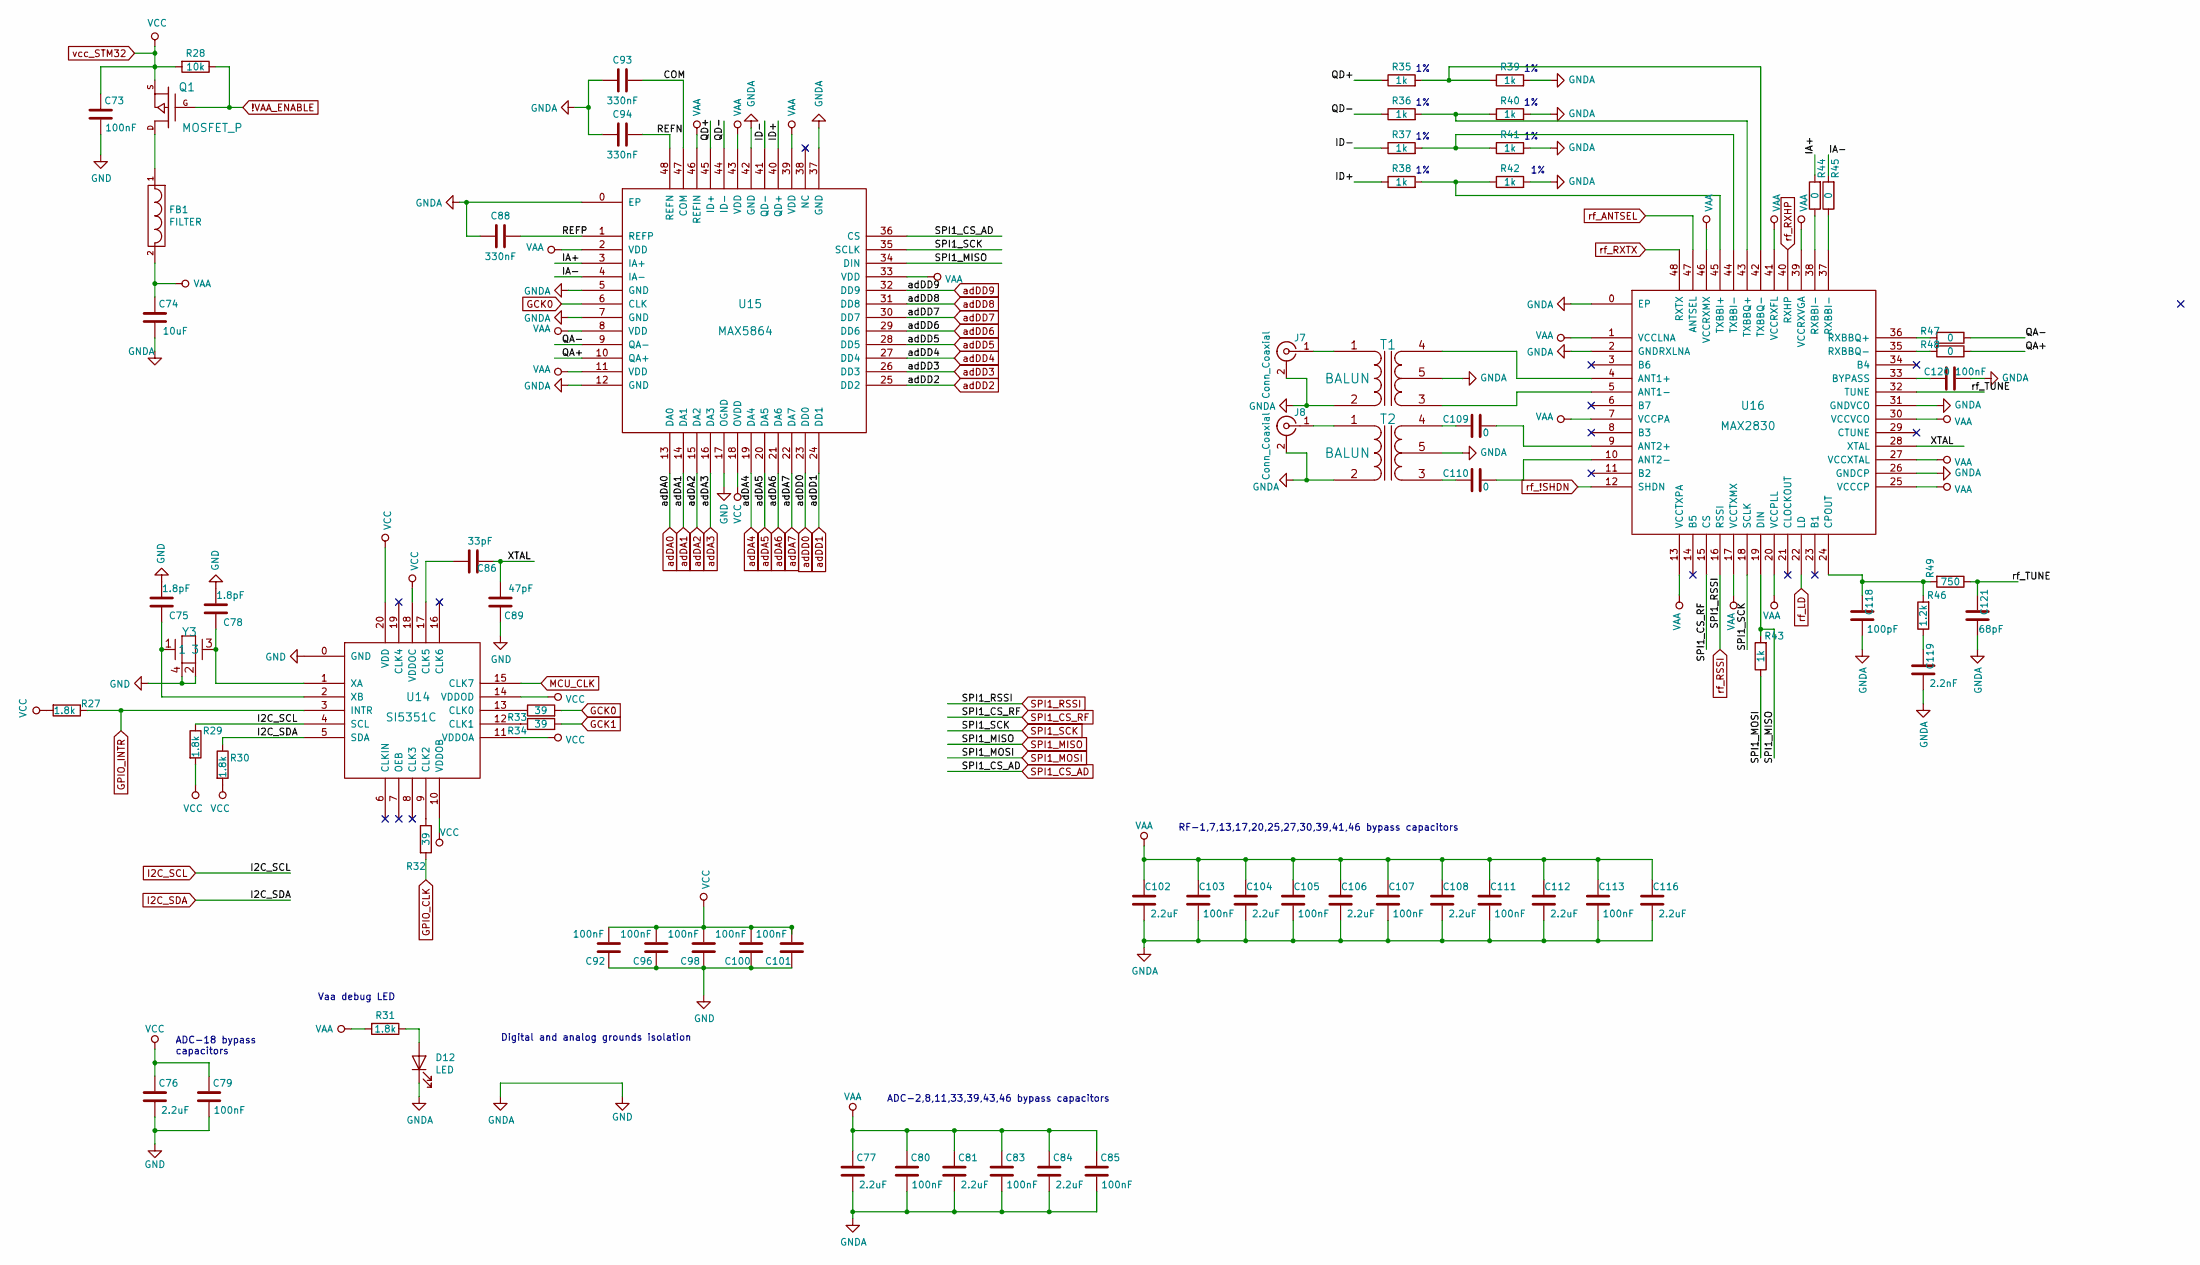
[picture p13: schematic rf_front_end.sch]

Parts:
C73, C79, C80, C83, C85, C92, C96, C98, C100, C101, C103, C105, C107, C111, C113, C120: 100nF; C_0603_1608Metric_Pad1.05x0.95mm_HandSolder
C74: 10uF; C_0603_1608Metric_Pad1.05x0.95mm_HandSolder
C75, C78: 1.8pF; C_0603_1608Metric_Pad1.05x0.95mm_HandSolder; digikey 1276-2218-1-ND
C76, C77, C81, C84, C102, C104, C106, C108, C112, C116: 2.2uF; C_0603_1608Metric_Pad1.05x0.95mm_HandSolder
C86: 33pF; C_0603_1608Metric_Pad1.05x0.95mm_HandSolder; digikey 1276-1070-1-ND
C88, C93, C94: 330nF; C_0603_1608Metric_Pad1.05x0.95mm_HandSolder
C89: 47pF; C_0603_1608Metric_Pad1.05x0.95mm_HandSolder
C109, C110: 0; C_0603_1608Metric_Pad1.05x0.95mm_HandSolder; digikey RMCF0603ZT0R00CT-ND
C118: 100pF; C_0603_1608Metric_Pad1.05x0.95mm_HandSolder
C119: 2.2nF; C_0603_1608Metric_Pad1.05x0.95mm_HandSolder
C121: 68pF; C_0603_1608Metric_Pad1.05x0.95mm_HandSolder
D12: LED; LED_0603_1608Metric_Pad1.05x0.95mm_HandSolder
FB1: FILTER; L_0805_2012Metric_Pad1.15x1.40mm_HandSolder; digikey BLM21PG221SN1D
J7, J8: Conn_Coaxial; TAOGLAS_EMPCB.SMAFSTJ.B.HT
Q1: MOSFET_P; SOT103P240X110-3N; digikey DMP2305UDICT-ND
R27, R29, R30, R31: 1.8k; R_0603_1608Metric_Pad1.05x0.95mm_HandSolder
R28: 10k; R_0603_1608Metric_Pad1.05x0.95mm_HandSolder
R32, R34: 39; R_0603_1608Metric_Pad1.05x0.95mm_HandSolder; DIGIKEY 311-39.0HRCT-ND
R33: 39; R_0603_1608Metric_Pad1.05x0.95mm_HandSolder; DIGIKEY RMSF0402JT39R0CT-ND
R35, R36, R37, R38, R39, R40, R41, R42, R43: 1k; R_0603_1608Metric_Pad1.05x0.95mm_HandSolder
R44, R45, R48: 0; R_0603_1608Metric_Pad1.05x0.95mm_HandSolder
R46: 1.2k; R_0603_1608Metric_Pad1.05x0.95mm_HandSolder
R47: 0; R_0603_1608Metric_Pad1.05x0.95mm_HandSolder; digikey RMCF0402ZT0R00CT-ND
R49: 750; R_0603_1608Metric_Pad1.05x0.95mm_HandSolder
T1, T2: BALUN; HHM1711E1; digikey 445-172632-1-ND
U14: SI5351C; QFN50P300X300X60-21N; digikey 336-5160-1-ND
U15: MAX5864; MAX5864ETM&plus_
U16: MAX2830; MAX2830ETM&plus_
Y3: ABM8G-25.000MHZ-B4Y-T; GSG-XTAL3.2x2.5mm; digikey ABM8-25.000MHZ-10-D1G-T

Connections:
!VAA_ENABLE: Q1.G, R28.1; also elsewhere on the board
/rf_front_end/COM: C93.1, U15.47 (COM)
/rf_front_end/IA+: R44.2, U15.3 (IA+)
/rf_front_end/IA-: R45.2, U15.4 (IA-)
/rf_front_end/ID+: R38.1, U15.40 (QD+)
/rf_front_end/ID-: R37.1, U15.41 (QD-)
/rf_front_end/QA+: R48.1, U15.10 (QA+)
/rf_front_end/QA-: R47.1, U15.9 (QA-)
/rf_front_end/QD+: R35.1, U15.45 (ID+)
/rf_front_end/QD-: R36.1, U15.44 (ID-)
/rf_front_end/REFN: C94.1, U15.48 (REFN)
/rf_front_end/REFP: C88.1, U15.1 (REFP)
/rf_front_end/XTAL: C86.2, C89.2, U16.28 (XTAL)
/rf_front_end/rf_TUNE: C121.1, R49.1, U16.32 (TUNE)
GCK0: R33.2, U15.6 (CLK); also elsewhere on the board
GCK1: R34.2; also elsewhere on the board
GND: C73.2, C74.2, C75.1, C76.2, C77.2, C78.1, C79.2, C80.2, C81.2, C83.2, C84.2, C85.2, C88.2, C89.1, C92.1, C93.2, C94.2, C96.1, C98.1, C100.1, C101.1, C102.2, C103.2, C104.2, C105.2, C106.2, C107.2, C108.2, C111.2, C112.2, C113.2, C116.2, C118.2, C119.2, C120.2, C121.2, D12.1 (K), J7.2 (Ext), J8.2 (Ext), R39.2, R40.2, R41.2, R42.2, T1.2 (S2), T1.5 (PM), T2.2 (S2), T2.5 (PM), U14.0 (GND), U15.0 (EP), U15.5 (GND), U15.7 (GND), U15.12 (GND), U15.17 (OGND), U15.37 (GND), U15.42 (GND), U16.0 (EP), U16.2 (GNDRXLNA), U16.26 (GNDCP), U16.31 (GNDVCO), Y3.2, Y3.4; also elsewhere on the board
GPIO_CLK: R32.2; also elsewhere on the board
GPIO_INTR: R27.1, U14.3 (INTR); also elsewhere on the board
I2C_SCL: R29.1, U14.4 (SCL); also elsewhere on the board
I2C_SDA: R30.1, U14.5 (SDA); also elsewhere on the board
MCU_CLK: U14.15 (CLK7); also elsewhere on the board
unnamed: C75.2, U14.2 (XB), Y3.1
unnamed: C78.2, U14.1 (XA), Y3.3
unnamed: C86.1, U14.17 (CLK5)
unnamed: C109.1, T2.4 (PR2)
unnamed: C109.2, U16.9 (ANT2+)
unnamed: C110.1, T2.3 (PR1)
unnamed: C110.2, U16.10 (ANT2-)
unnamed: C118.1, R46.2, R49.2, U16.24 (CPOUT)
unnamed: C119.1, R46.1
unnamed: C120.1, U16.33 (BYPASS)
unnamed: D12.2 (A), R31.1
unnamed: FB1.1, Q1.D
unnamed: J7.1 (In), T1.1 (S1)
unnamed: J8.1 (In), T2.1 (S1)
unnamed: R32.1, U14.9 (CLK2)
unnamed: R33.1, U14.13 (CLK0)
unnamed: R34.1, U14.12 (CLK1)
unnamed: R35.2, R39.1, U16.42 (TXBBQ-)
unnamed: R36.2, R40.1, U16.43 (TXBBQ+)
unnamed: R37.2, R41.1, U16.44 (TXBBI-)
unnamed: R38.2, R42.1, U16.45 (TXBBI+)
unnamed: R44.1, U16.38 (RXBBI-)
unnamed: R45.1, U16.37 (RXBBI-)
unnamed: R47.2, U16.36 (RXBBQ+)
unnamed: R48.2, U16.35 (RXBBQ-)
unnamed: T1.3 (PR1), U16.5 (ANT1-)
unnamed: T1.4 (PR2), U16.4 (ANT1+)
SPI1_CS_AD: U15.36 (CS); also elsewhere on the board
SPI1_CS_RF: U16.15 (CS); also elsewhere on the board
SPI1_MISO: R43.2, U15.34 (DIN), U16.19 (DIN); also elsewhere on the board
SPI1_MOSI: R43.1; also elsewhere on the board
SPI1_RSSI: U16.16 (RSSI); also elsewhere on the board
SPI1_SCK: U15.35 (SCLK), U16.18 (SCLK); also elsewhere on the board
VAA: C74.1, C77.1, C80.1, C81.1, C83.1, C84.1, C85.1, C102.1, C103.1, C104.1, C105.1, C106.1, C107.1, C108.1, C111.1, C112.1, C113.1, C116.1, FB1.2, R31.2, U15.2 (VDD), U15.8 (VDD), U15.11 (VDD), U15.33 (VDD), U15.39 (VDD), U15.43 (VDD), U15.46 (REFIN), U16.1 (VCCLNA), U16.7 (VCCPA), U16.13 (VCCTXPA), U16.17 (VCCTXMX), U16.20 (VCCPLL), U16.25 (VCCCP), U16.27 (VCCXTAL), U16.30 (VCCVCO), U16.39 (VCCRXVGA), U16.41 (VCCRXFL), U16.46 (VCCRXMX)
adDA0: U15.13 (DA0); also elsewhere on the board
adDA1: U15.14 (DA1); also elsewhere on the board
adDA2: U15.15 (DA2); also elsewhere on the board
adDA3: U15.16 (DA3); also elsewhere on the board
adDA4: U15.19 (DA4); also elsewhere on the board
adDA5: U15.20 (DA5); also elsewhere on the board
adDA6: U15.21 (DA6); also elsewhere on the board
adDA7: U15.22 (DA7); also elsewhere on the board
adDD0: U15.23 (DD0); also elsewhere on the board
adDD1: U15.24 (DD1); also elsewhere on the board
adDD2: U15.25 (DD2); also elsewhere on the board
adDD3: U15.26 (DD3); also elsewhere on the board
adDD4: U15.27 (DD4); also elsewhere on the board
adDD5: U15.28 (DD5); also elsewhere on the board
adDD6: U15.29 (DD6); also elsewhere on the board
adDD7: U15.30 (DD7); also elsewhere on the board
adDD8: U15.31 (DD8); also elsewhere on the board
adDD9: U15.32 (DD9); also elsewhere on the board
rf_!SHDN: U16.12 (SHDN); also elsewhere on the board
rf_ANTSEL: U16.47 (ANTSEL); also elsewhere on the board
rf_LD: U16.22 (LD); also elsewhere on the board
rf_RXHP: U16.40 (RXHP); also elsewhere on the board
rf_RXTX: U16.48 (RXTX); also elsewhere on the board
vcc_STM32: C73.1, C76.1, C79.1, C92.2, C96.2, C98.2, C100.2, C101.2, Q1.S, R27.2, R28.2, R29.2, R30.2, U14.10 (VDDOB), U14.11 (VDDOA), U14.14 (VDDOD), U14.18 (VDDOC), U14.20 (VDD), U15.18 (OVDD); also elsewhere on the board

Notes on the sheet:
ADC-18 bypass capacitors
ADC-2,8,11,33,39,43,46 bypass capacitors
Vaa debug LED
Digital and analog grounds isolation
RF-1,7,13,17,20,25,27,30,39,41,46 bypass capacitors

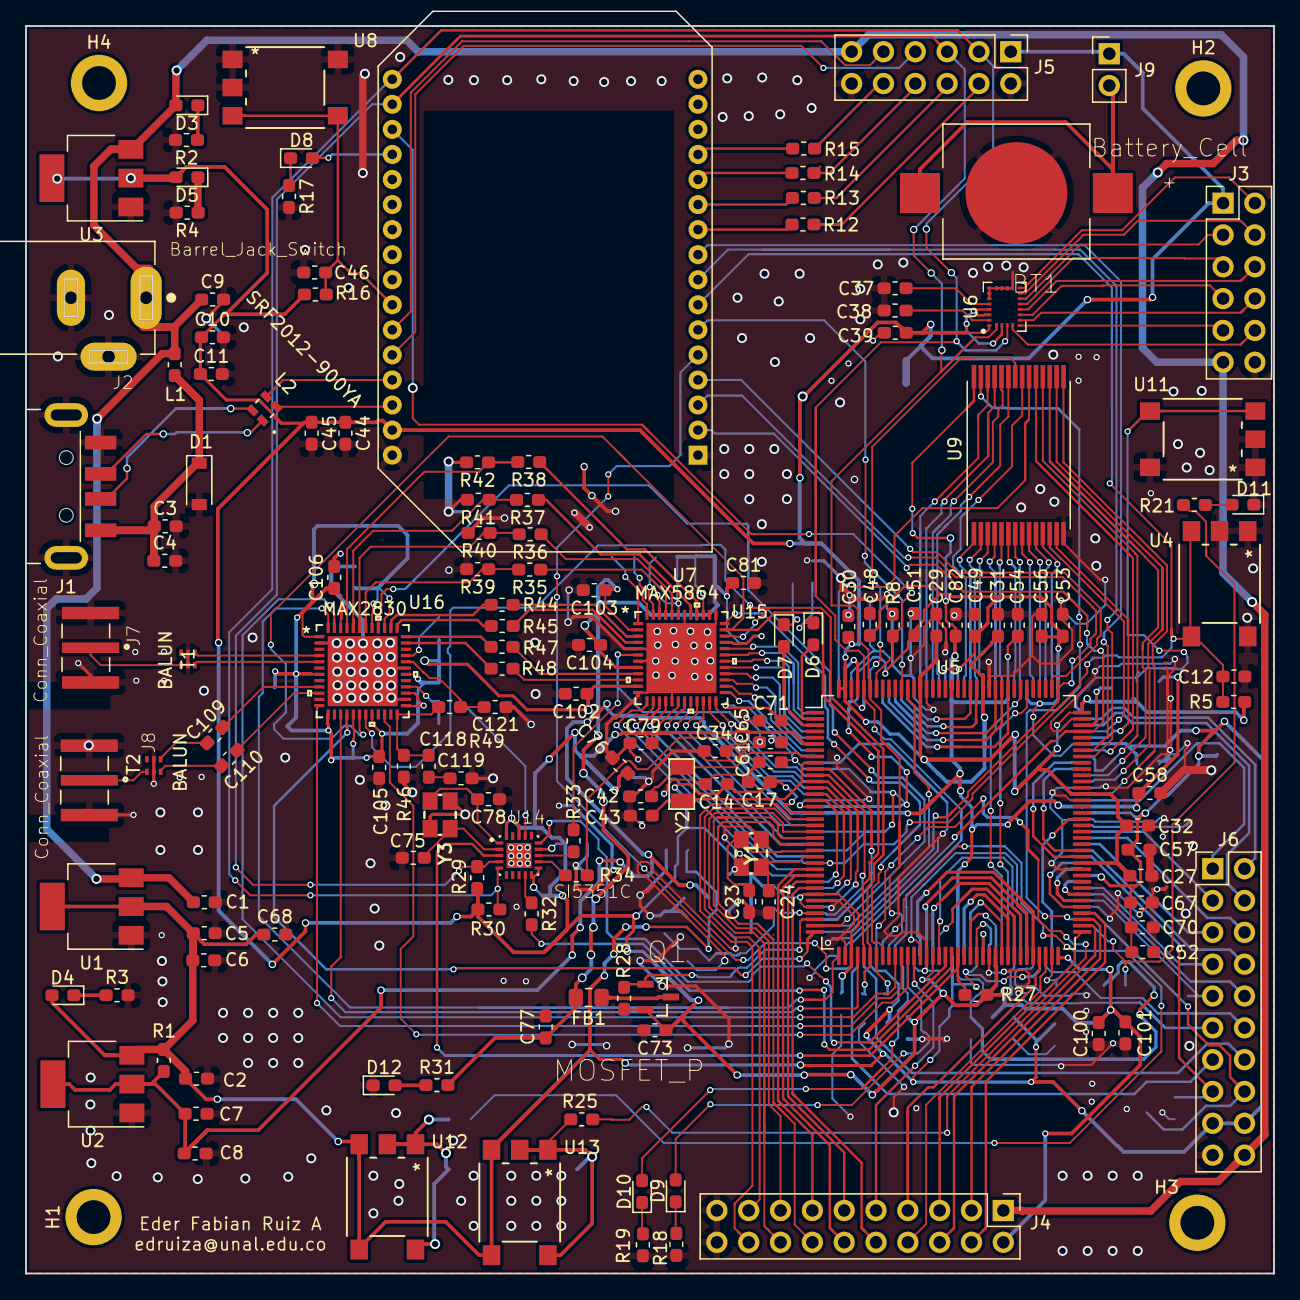
[picture p14: board power.kicad_pcb from above]

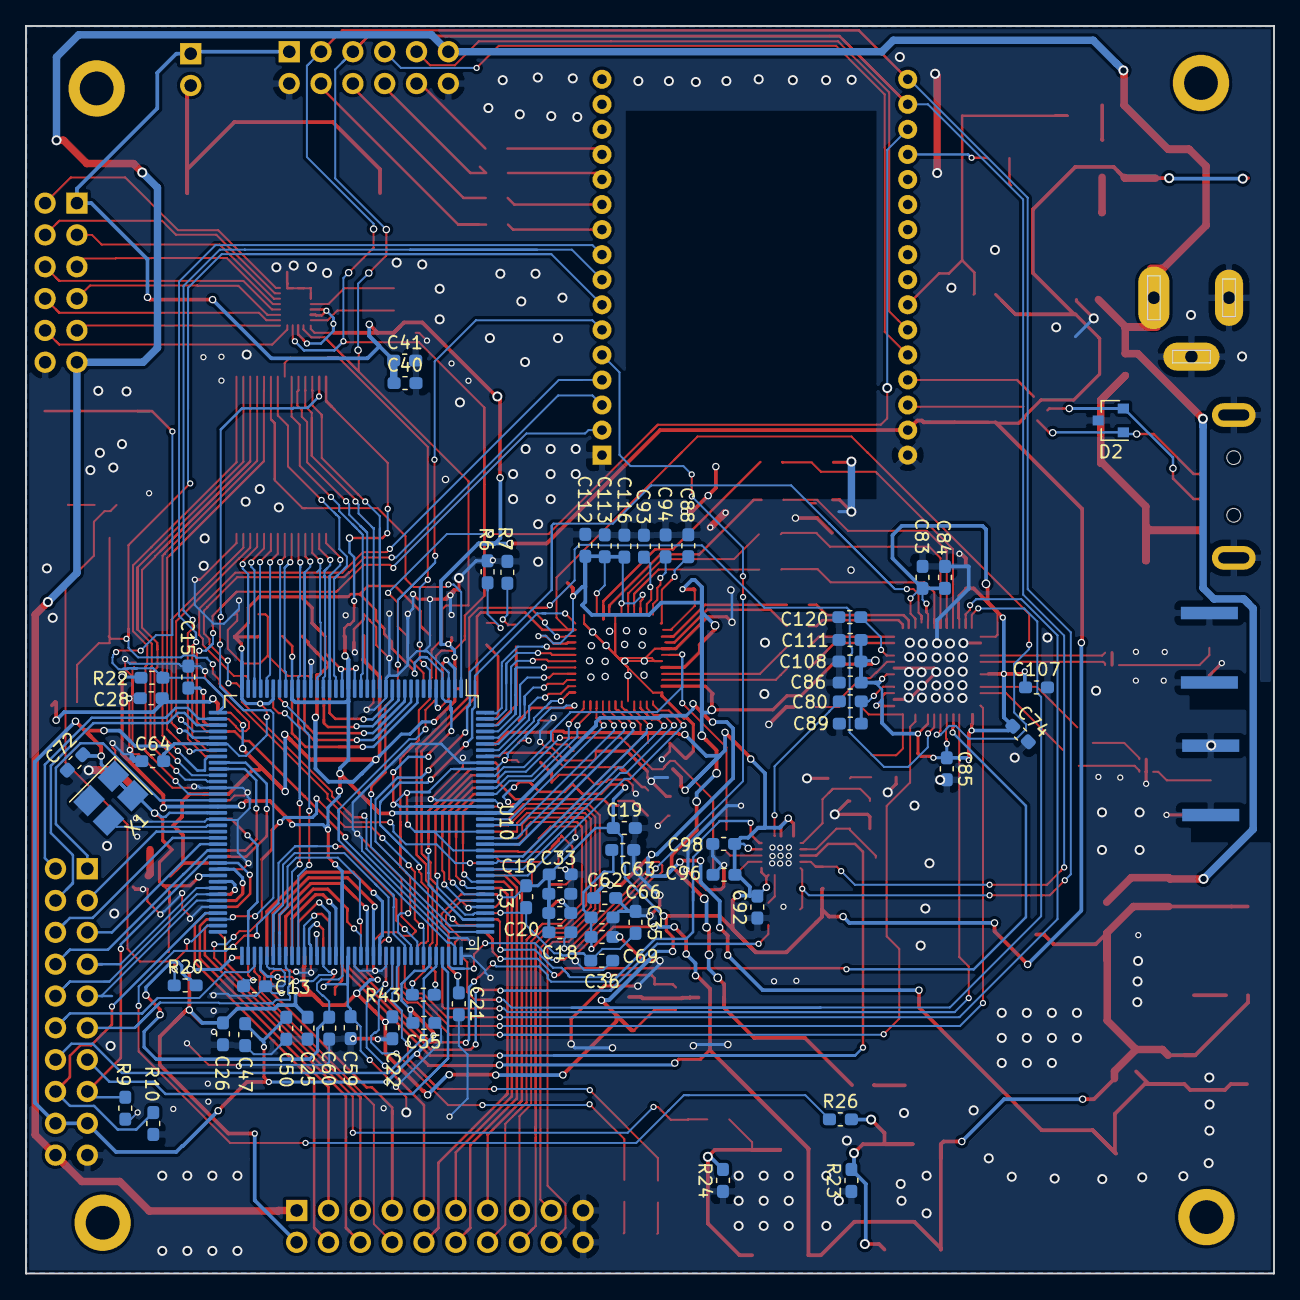
[picture p15: board power.kicad_pcb from below]

Board: 2 copper layers, 99.6 x 99.6 mm, 213 parts (61 on the bottom side), 239 nets.
