fabianupn/FabianRuizEmbebidos/onion/xc3sprog_programa_manual/xc3sprog-master/bscan_spi/sp3adsp-fg676.ucf

net "MISO" LOC = "AF24";
net "MOSI" LOC = "AB15";
net "DRCK1" LOC= "AE24";
net "CSB"  LOC = "AA7";
