fabianupn/FabianRuizEmbebidos/onion/xc3sprog_programa_manual/xc3sprog-master/xc3sprog.cpp

/* Spartan3 JTAG programmer

Copyright (C) 2004 Andrew Rogers
              2005-2011 Uwe Bonnes bon@elektron.ikp.physik.tu-darmstadt.de

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
Changes:
Dmitry Teytelman [dimtey@gmail.com] 14 Jun 2006 [applied 13 Aug 2006]:
    Code cleanup for clean -Wall compile.
    Added support for FT2232 driver.
    Verbose support added.
    Installable device database location.
*/

#include <stdlib.h>
#include <string.h>
#include <unistd.h>
#include <list>
#include <memory>
#include <errno.h>
#include <assert.h>
#include <sys/types.h>
#include <sys/stat.h>
#include <fcntl.h>
#include <signal.h>

#include "io_exception.h"
#include "ioparport.h"
#include "iofx2.h"
#include "ioftdi.h"
#include "ioxpc.h"
#include "sysfs.h"
#include "bitfile.h"
#include "jtag.h"
#include "devicedb.h"
#include "cabledb.h"
#include "progalgxcf.h"
#include "progalgxcfp.h"
#include "javr.h"
#include "progalgxc3s.h"
#include "jedecfile.h"
#include "mapfile_xc2c.h"
#include "progalgxc95x.h"
#include "progalgxc2c.h"
#include "progalgavr.h"
#include "progalgspiflash.h"
#include "progalgnvm.h"
#include "utilities.h"

using namespace std;

#define MAXPOSITIONS    8

#define IDCODE_TO_FAMILY(id)        ((id>>21) & 0x7f)
#define IDCODE_TO_MANUFACTURER(id)  ((id>>1) & 0x3ff)

#define MANUFACTURER_ATMEL          0x01f
#define MANUFACTURER_XILINX         0x049

    int do_exit = 0;
void ctrl_c(int sig)
{
  do_exit = 1;
}

int programXC3S(Jtag &g, int argc, char **args, bool verbose,
                bool reconfig, int family);
int programXCF(Jtag &jtag, DeviceDB &db, int argc, char **args,
               bool verbose, bool erase, bool reconfigure,
               const char *device, int *chainpositions, int nchainpos,
               const vector<string>& xcfopts);
int programXC95X(Jtag &jtag, unsigned long id, int argc, char **args, 
                 bool verbose, bool erase, const char *device);
int programXC2C(Jtag &jtag, unsigned int id, int argc, char ** args, 
                bool verbose, bool erase, const char *mapdir,
                const char *device);
int programSPI(Jtag &jtag, int argc, char ** args, bool verbose, bool erase,
               bool reconfig,  int test_count,
               char *bscanfile,int family, const char *device);

int programXMega(Jtag *jtag, unsigned long id, int argc, char **args, 
		 bool verbose, bool erase, bool reconfigure,
		 const char *device);

/* Excercise the IR Chain for at least 10000 Times
   If we read a different pattern, print the pattern for for optical 
   comparision and read for at least 100000 times more

   If we found no chain, simple rerun the chain detection

   This may result in an endless loop to facilitate debugging with a scope etc 
*/
void test_IRChain(Jtag *jtag, IOBase *io,DeviceDB &db , int test_count)
{
  int num=jtag->getChain();
  int failed = 0;
  int len = 0;
  int i, j, k;
  unsigned char ir_in[256];
  unsigned char ir_out[256];
  unsigned char din[256];
  unsigned char dout[256];
  unsigned char dcmp[256];
  memset(din, 0xaa, 256);
  int run_irtest = 0;

  if(num == 0)
      /* the chain is not functional and we have no idea 
       * what parts to look for
       */
    {
      fprintf(stderr, "Running getChain %d times\n", test_count);
      k=0;
      for(i=0; i<test_count; i++)
	{
	  if (jtag->getChain(true)> 0) 
	    {
	      if(k%1000 == 1)
		{
		  fprintf(stderr,".");
		  fflush(stderr);
		}
	      k++;
	    }
	}
      return;
    }
  if(num >8)
      fprintf(stderr, "Found %d devices\n", num);
  
  /* Read the IDCODE via the IDCODE command */
  (void) signal (SIGINT, ctrl_c);

  for(i=0; i<num; i++)
    {
      jtag->setTapState(Jtag::TEST_LOGIC_RESET);
      jtag->selectDevice(i);
      DeviceID id = jtag->getDeviceID(i);
      int irlen = db.idToIRLength(id);
      if (irlen == 0)
      {
          run_irtest++;
          break;
      }
      uint32_t idcmd = db.idToIDCmd(id);
      for (j = 0; j < irlen; j = j+8)
        ir_in[j>>3] = (idcmd>>j) & 0xff;
      jtag->shiftIR(ir_in, ir_out);
      jtag->cycleTCK(1);
      jtag->shiftDR(NULL, &dout[i*4], 32);
      if (jtag->byteArrayToLong(dout+i*4) != id)
	{
	  fprintf(stderr, "IDCODE mismatch pos %d Read 0x%08lx vs 0x%08lx\n",
		  i, jtag->byteArrayToLong(dout+i*4), (unsigned long)id);
	  run_irtest++;
	}
    }

  if(run_irtest)
    { /* ID Code did fail, to simple shift the IR chain */ 
      fprintf(stderr, "Running IR_TEST %d  times\n", test_count);
      /* exercise the chain */
      for(i=0; i<num; i++)
        len += db.idToIRLength(jtag->getDeviceID(i));
      fprintf(stderr, "IR len = %d\n", len);
      jtag->setTapState(Jtag::TEST_LOGIC_RESET);
      jtag->setTapState(Jtag::SHIFT_IR);
      io->shiftTDITDO(din,dout,len,true);
      jtag->nextTapState(true);
      fprintf(stderr, "0x");
      for(i=0; i <len>>3;  i++)
	fprintf(stderr, "%02x", dout[i]);
      fprintf(stderr, " binary ");
      k=len-1;
      for(i = 0; i<num; i++)
	{
          int irlen = db.idToIRLength(jtag->getDeviceID(i));
	  for(j=0; j<irlen; j++)
	    {
	      fprintf(stderr, "%c", 
		      (((dout[k>>3]>>(k&0x7)) &0x01) == 0x01)?'1':'0');
	      k--;
	    }
	  fprintf(stderr, " ");
	}
      fflush(stderr);
      for(i=0; i<test_count&& !do_exit; i++)
	{
	  jtag->setTapState(Jtag::SELECT_DR_SCAN);
	  jtag->setTapState(Jtag::SHIFT_IR);
	  io->shiftTDITDO(din,dcmp,len,true);
	  jtag->nextTapState(true);
	  if (memcmp(dout, dcmp, (len+1)>>3) !=0)
	    {
	      fprintf(stderr, "mismatch run %d\n", i);
              failed++;
	      for(j=0; j <len>>3;  j++)
		fprintf(stderr, "%02x", dcmp[j]);
	      fprintf(stderr, " ");	      k=len-1;
	      for(i = 0; i<num; i++)
		{
                  int irlen = db.idToIRLength(jtag->getDeviceID(i));
		  for(j=0; j<irlen; j++)
		    {
		      fprintf(stderr, "%c",
			      (((dcmp[k>>3]>>(k&0x7)) &0x01) == 0x01)?'1':'0');
		      k--;
		    }
		  fprintf(stderr, " ");
		}
	    }
	  fflush(stderr);
	  if(i%1000 == 999)
	    {
	      fprintf(stderr, ".");
	      fflush(stderr);
	    }
	}
      fprintf(stderr, "\n");
    }
  else
    {
      fprintf(stderr, "Reading ID_CODE %d  times\n", test_count);
      memset(ir_in, 0, 256);
      /* exercise the chain */
      for(i=num-1; i>=0 && !do_exit; i--)
	{
          int irlen = db.idToIRLength(jtag->getDeviceID(i));
          uint32_t idcmd = db.idToIDCmd(jtag->getDeviceID(i));
	  for(j=0; j<irlen; j++)
	    {
	      char l = (idcmd & (1<<j))?1:0;
	      ir_in[len>>3] |= ((l)?(1<<(len & 0x7)):0);
	      len++;
	      jtag->longToByteArray(jtag->getDeviceID(i), dcmp+((num -1 -i)*4)); 
	    }
	}
      fprintf(stderr, "Sending %d bits IDCODE Commands: 0x", len);
      for(i=0; i <len;  i+=8)
	fprintf(stderr, "%02x", ir_in[i>>3]);
      fprintf(stderr, "\n");
      fprintf(stderr, "Expecting %d IDCODES  :", num);
      for(i=num-1; i >= 0;  i--)
	fprintf(stderr, " 0x%08lx", (unsigned long) jtag->getDeviceID(i));

      jtag->tapTestLogicReset();
      for(i=0; i<test_count&& !do_exit; i++)
	{
	  jtag->setTapState(Jtag::SHIFT_IR);
	  io->shiftTDI(ir_in,len,true);
	  jtag->nextTapState(true);
	  jtag->setTapState(Jtag::SHIFT_DR);
	  io->shiftTDITDO(NULL,dout,num*32,true);
	  jtag->nextTapState(true);
	  jtag->setTapState(Jtag::TEST_LOGIC_RESET);
	  if(memcmp(dout, dcmp, num*4) !=0)
	    {
	      fprintf(stderr, "\nMismatch run %8d:", i+1);
              failed++;
	      for(j=num-1; j>=0; j--)
		  fprintf(stderr," 0x%08lx", jtag->byteArrayToLong(dout+j*4));
	      fflush(stderr);
	    }
	  if(i%1000 == 999)
	    {
	      fprintf(stderr, ".");
	      fflush(stderr);
	    }
	} 
      fprintf(stderr, "\n");
    }
  if (failed)
      fprintf(stderr, "Failed %8d/%8d\n", failed, i);
  signal (SIGINT, SIG_DFL);
}

int init_chain(Jtag &jtag, DeviceDB &db)
{
  int num = jtag.getChain();
  if (num == 0)
    {
      fprintf(stderr,"No JTAG Chain found\n");
      return 0;
    }
  // Synchronise database with chain of devices.
  for (int i=0; i<num; i++){
    unsigned long id = jtag.getDeviceID(i);
    int length = db.idToIRLength(id);
    if (length > 0)
      jtag.setDeviceIRLength(i,length);
    else
      {
        fprintf(stderr,"Cannot find device having IDCODE=%07lx Revision %c\n",
                id & 0x0fffffff,  (int)(id  >>28) + 'A');
        return 0;
      }
  }
  return num;
}

static int last_pos = -1;

unsigned long get_id(Jtag &jtag, DeviceDB &db, int chainpos)
{
  bool verbose = jtag.getVerbose();
  int num = jtag.getChain();
  if (jtag.selectDevice(chainpos)<0)
    {
      fprintf(stderr, "Invalid chain position %d, must be >= 0 and < %d\n",
              chainpos, num);
      return 0;
    }
  unsigned long id = jtag.getDeviceID(chainpos);
  if (verbose && (last_pos != chainpos))
    {
      fprintf(stderr, "JTAG chainpos: %d Device IDCODE = 0x%08lx\tDesc: %s\n",
              chainpos, id, db.idToDescription(id));
      fflush(stderr);
      last_pos = chainpos;
    }
  return id;
}
  
void usage(bool all_options)
{
  fprintf(stderr, "usage:\txc3sprog -c cable [options] <file0spec> <file1spec> ...\n");
  fprintf(stderr, "\tList of known cables is given with -c follow by no or invalid cablename\n");
  fprintf(stderr, "\tfilespec is filename:action:offset:style:length\n");
  fprintf(stderr, "\taction on of 'w|W|v|r|R'\n");
  fprintf(stderr, "\tw: erase whole area, write and verify\n");
  fprintf(stderr, "\tW: Write with auto-sector erase and verify\n");
  fprintf(stderr, "\tv: Verify device against filename\n");
  fprintf(stderr, "\tr: Read from device,write to file, don't overwrite existing file\n");
  fprintf(stderr, "\tR: Read from device and write to file, overwrite existing file\n");
  fprintf(stderr, "\tDefault action is 'w'\n\n");
  fprintf(stderr, "\tDefault offset is 0\n\n");
  fprintf(stderr, "\tstyle: One of BIT|BIN|BPI|MCS|IHEX|HEX\n");
  fprintf(stderr, "\tBIT: Xilinx .bit format\n");
  fprintf(stderr, "\tBIN: Binary format\n");
  fprintf(stderr, "\tBPI: Binary format not bit reversed\n");
  fprintf(stderr, "\tMCS: Intel Hex File, LSB first\n");
  fprintf(stderr, "\tIHEX: INTEL Hex format, MSB first (Use for Xilinx .mcs files!)\n");
  fprintf(stderr, "\tHEX:  Hex dump format\n");
  fprintf(stderr, "\tDefault for FPGA|SPI|XCF is BIT\n");
  fprintf(stderr, "\tDefault for CPLD is JED\n");
  fprintf(stderr, "\tDefault for XMEGA is IHEX\n");
  fprintf(stderr, "\tDefault length is whole device\n");

  if (!all_options) exit(255);

  fprintf(stderr, "\nPossible options:\n");
#define OPT(arg, desc)	\
  fprintf(stderr, "   %-8s  %s\n", (arg), (desc))
  OPT("-p val[,val...]", "Use device at JTAG Chain position <val>.");
  OPT("",   "Default (0) is device connected to JTAG Adapter TDO.");
  OPT("-e", "Erase whole device.");
  OPT("-h", "Print this help.");
  OPT("-I[file]", "Work on connected SPI Flash (ISF Mode),");
  OPT(""  , "after loading 'bscan_spi' bitfile if given.");
  OPT("-j", "Detect JTAG chain, nothing else (default action).");
  OPT("-l", "Program lockbits if defined in fusefile.");
  OPT("-m <dir>", "Directory with XC2C mapfiles.");
  OPT("-R", "Try to reconfigure device(No other action!).");
  OPT("-T val", "Test chain 'val' times (0 = forever) or 10000 times"
      " default.");
  OPT("-J val", "Run at max with given JTAG Frequency, 0(default) means max. Rate of device");
  OPT("", "Only used for FTDI cables for now");
  OPT("-D", "Dump internal devlist and cablelist to files");
  OPT(""      , "In ISF Mode, test the SPI connection.");
  OPT("-X opts", "Set options for XCFxxP programming");
  OPT("-v", "Verbose output.");

  fprintf(stderr, "\nProgrammer specific options:\n");
  /* Parallel cable */
  OPT("-d", "(pp only     ) Parallel port device.");
  /* USB devices */
  OPT("-s num" , "(usb devices only) Serial number string.");
  OPT("-L     ", "(ftdi only       ) Don't use LibUSB.");

  fprintf(stderr, "\nDevice specific options:\n");
  OPT("-E file", "(AVR only) EEPROM file.");
  OPT("-F file", "(AVR only) File with fuse bits.");
#undef OPT

  exit(255);
}

/* Parse a filename in the form
 *           aaaa.bb:action:0x10000|section:0x10000:rawhex:0x1000
 * for name, action, offset|area, style, length 
 * 
 * return the Open File
 *
 * possible action
 * w: erase whole area, write and verify
 * W: Write with auto-sector erase and verify
 * v: Verify device against filename
 * r: Read from device and write to file, don't overwrite exixting file
 * R: Read from device and write to file, overwrite exixting file
 *
 * possible sections:
 * f: Flash
 * a:
 * 
 */
FILE *getFile_and_Attribute_from_name(
    char *name, char * action, char * section, 
    unsigned int *offset, FILE_STYLE *style, unsigned int *length)
{
    FILE *ret;
    char filename[256];
    char *p = name, *q;
    int len;
    char localaction = 'w';
    char localsection = 'a';
    unsigned int localoffset = 0;
    FILE_STYLE localstyle=STYLE_BIT;
    unsigned int locallength = 0;
    
    if(!p)
        return NULL;
    else
    {
        q = strchr(p,':');
#if defined(__WIN32__)
        if (p[1]  == ':') {
            /* Assume we have a DOS path.
             * Look for next colon or end-of-string.
             */
            q = strchr(p + 2, ':');
        }
#endif
        if (q)
            len = q-p;
        else
            len = strlen(p);
        if (len>0)
        {
            int num = (len>255)?255:len;
            strncpy(filename, p, num);
            filename[num] = 0;
        }
        else
            return NULL;
        p = q;
        if(p)
            p ++;
    }
    /* Action*/
    if(p)
    {
        q = strchr(p,':');
        
        if (q)
            len = q-p;
        else
            len = strlen(p);
        if (len == 1)
            localaction = *p;
        else
            localaction = 'w';
        if (action)
        {
            if(localaction == 'W')
                *action =  localaction;
            else
                *action =  tolower(localaction);
        }
        p = q;
        if(p)
            p ++;
    }
    /*Offset/Area*/
    if(p)
    {
        q = strchr(p,':');
        if (q)
            len = q-p;
        else
            len = strlen(p);
        if (!isdigit(*p))
        {
            localsection = *p;
            if (section)
                *section = localsection;
            p++;
        }
        localoffset = strtol(p, NULL, 0);
        if (offset)
            *offset = localoffset;
        p = q;
        if(p)
            p ++;
    }
    /*Style*/
    if(p )
    {
        int res = 0;
        q = strchr(p,':');
        
        if (q)
            len = q-p;
        else
            len = strlen(p);
        if (len)
            res = BitFile::styleFromString(p, &localstyle);
        if(res)
        {
            fprintf(stderr, "\nUnknown format \"%*s\"\n", len, p);
            return 0;
        }
        if (len && style)
            *style = localstyle;
        p = q;
        if(p)
            p ++;
    }
    /*Length*/
    
    if(p)
    {
        locallength = strtol(p, NULL, 0);
        p = strchr(p,':');
        if (length)
            *length = locallength;
        if(p)
            p ++;
    }
    
    if  (tolower(localaction) == 'r')
    {
        if (!(strcasecmp(filename,"stdout")))
            ret= stdout;
        else
        {
            int res; 
            struct stat  stats;
            res = stat(filename, &stats);
            if ((res == 0) && (localaction == 'r') && stats.st_size !=0)
            {
                fprintf(stderr, "File %s already exists. Aborting\n", filename);
                return NULL;
            }
            ret=fopen(filename,"wb");
            if(!ret)
                fprintf(stderr, "Unable to open File %s. Aborting\n", filename);
        }
    }
    else
    {
#if 0
        if (!(strcasecmp(filename,"stdin")))
            ret = stdin;
        else
#endif
        {
            ret = fopen(filename,"rb");
            if(!ret)
                fprintf(stderr, "Can't open datafile %s: %s\n", filename, 
                        strerror(errno));
        }
    }
    return ret;
}

void dump_lists(CableDB *cabledb, DeviceDB *db)
{
    int fd;
    FILE *fp_out;
    char outname[17] = "cablelist.txt";

   fd = open(outname, O_WRONLY|O_CREAT|O_EXCL, 0644);
    if (fd <0 )
    {
        sprintf(outname,"cablelist.txt.1");
        fd = open(outname, O_WRONLY|O_CREAT, 0644);
    }
    if (fd <0 )
    {
        fprintf(stderr, "Error creating file\n");
    }
    else
    {
        fprintf(stderr, "Dumping internal cablelist to %s\n", outname);
        fp_out = fdopen(fd, "w");
        if (fp_out)
        {
            fprintf(fp_out, "%-20s%-8s%-10sOptString\n", "#Alias", "Type", "Frequency");
            cabledb->dumpCables(fp_out);
            fclose(fp_out);
        }
    }

    sprintf(outname,"devlist.txt");
   fd = open(outname, O_WRONLY|O_CREAT|O_EXCL, 0644);
    if (fd <0 )
    {
        sprintf(outname,"devlist.txt.1");
        fd = open(outname, O_WRONLY|O_CREAT, 0644);
    }
    if (fd <0 )
    {
        fprintf(stderr, "Error creating file\n");
    }
    else
    {
        fprintf(stderr, "Dumping internal devicelist to %s\n", outname);
        fp_out = fdopen(fd, "w");
        if (fp_out)
        {
            fprintf(fp_out, "# IDCODE IR_len ID_Cmd Text\n");
            db->dumpDevices(fp_out);
            fclose(fp_out);
        }
    }
    exit(0);
}

int main(int argc, char **args)
{
  bool        verbose   = false;
  bool        dump      = false;
  bool        verify    = false;
  bool        lock      = false;
  bool     detectchain  = false;
  bool     chaintest    = false;
  bool     spiflash     = false;
  bool     reconfigure  = false;
  bool     erase        = false;
  bool     use_ftd2xx   = false;
  unsigned int jtag_freq= 0;
  unsigned long id;
  struct cable_t cable;
  char const *dev       = 0;
  char const *eepromfile= 0;
  char const *fusefile  = 0;
  char const *mapdir    = 0;
  FILE_STYLE in_style  = STYLE_BIT;
  FILE_STYLE out_style = STYLE_BIT;
  int      chainpos     = 0;
  int      nchainpos    = 1;
  int      chainpositions[MAXPOSITIONS] = {0};
  vector<string> xcfopts;
  int test_count = 0;
  char const *serial  = 0;
  char *bscanfile = 0;
  char *cablename = 0;
  char osname[OSNAME_LEN];
  DeviceDB db(NULL);
  CableDB cabledb(NULL);
  std::auto_ptr<IOBase>  io;
  int res;

  get_os_name(osname, sizeof(osname));
  // Produce release info from SVN tags
  fprintf(stderr, "XC3SPROG (c) 2004-2011 xc3sprog project $Rev: 774 $ OS: %s\n"
	  "Free software: If you contribute nothing, expect nothing!\n"
	  "Feedback on success/failure/enhancement requests:\n"
          "\thttp://sourceforge.net/mail/?group_id=170565 \n"
	  "Check Sourceforge for updates:\n"
          "\thttp://sourceforge.net/projects/xc3sprog/develop\n\n",
	  osname);

  // Start from parsing command line arguments
  while(true) {
      int c = getopt(argc, args, "?hCLc:d:DeE:F:i:I::jJ:Lm:o:p:Rs:S:T::vX:");
    switch(c) 
    {
    case -1:
      goto args_done;

    case 'v':
      verbose = true;
      break;

    case 'C':
      verify = true;
      break;

    case 'I':
      spiflash = true;
      bscanfile = optarg;
      break;

    case 'j':
      detectchain = true;
      break;

    case 'L':
      use_ftd2xx = true;
      break;

    case 'R':
      reconfigure = true;
      break;

    case 'T':
      chaintest = true;
      if(optarg == 0)
	test_count = 10000;
      else
	test_count = atoi(optarg);
      if (test_count == 0)
	test_count = INT_MAX;
      break;

    case 'J':
      jtag_freq = atoi(optarg);
      break;

    case 'l':
      lock = true;
      break;

    case 'c':
      cablename =  optarg;
      break;

    case 'm':
      mapdir = optarg;
      break;

    case 'e':
      erase = true;
      break;

    case 'D':
      dump = true;
      break;

    case 'E':
      eepromfile = optarg;
      break;

    case 'F':
      fusefile = optarg;
      break;

    case 'o':
      if (BitFile::styleFromString(optarg, &out_style) != 0)
	{
	  fprintf(stderr, "\nUnknown format \"%s\"\n", optarg);
	  usage(false);
	}
      break;

    case 'i':
      if (BitFile::styleFromString(optarg, &in_style) != 0)
	{
	  fprintf(stderr, "\nUnknown format \"%s\"\n", optarg);
	  usage(false);
	}
      break;
      
     case 'd':
      dev = optarg;
      break;

    case 'p':
      {
        char *p = optarg, *q;
        for (nchainpos = 0; nchainpos <= MAXPOSITIONS; )
          {
            chainpositions[nchainpos] = strtoul(p, &q, 10);
            if (p == q)
              break;
            p = q;
            nchainpos++;
            if (*p == ',')
              p++;
            else
              break;
          }
        if (*p != '\0')
          {
            fprintf(stderr, "Invalid position specification \"%s\"\n", optarg);
            usage(false);
          }
      }
      chainpos = chainpositions[0];
      break;

    case 's':
      serial = optarg;
      break;

    case 'X':
      {
        vector<string> new_opts = splitString(string(optarg), ',');
        xcfopts.insert(xcfopts.end(), new_opts.begin(), new_opts.end());
        break;
      }

    case '?':
    case 'h':
    default:
        if (optopt == 'c')
        {
            fprintf(stdout, "Known Cables\n");
            cabledb.dumpCables(stderr);
            exit(1);
        }
        fprintf(stderr, "Unknown option -%c\n", c);
        usage(true);
    }
  }
 args_done:
  argc -= optind;
  args += optind;
  if (dump)
      dump_lists(&cabledb, &db);

  if((argc < 0) || (cablename == 0))  usage(true);
  if(argc < 1 && !reconfigure && !erase) detectchain = true;
  if (verbose)
  {
    fprintf(stderr, "Using %s\n", db.getFile().c_str());
    fprintf(stderr, "Using %s\n", cabledb.getFile().c_str());
  }
  res = cabledb.getCable(cablename, &cable);
  if(res)
  {
      fprintf(stderr,"Can't find description for a cable named %s\n",
             cablename);
      fprintf(stdout, "Known Cables\n");
      cabledb.dumpCables(stderr);
      exit(1);
  }
  
  res = getIO( &io, &cable, dev, serial, verbose, use_ftd2xx, jtag_freq);
  if (res) /* some error happend*/
    {
      if (res == 1) exit(1);
      else usage(false);
    }

  if (cable.cabletype == CABLE_SYSFS_GPIO)
  {
    static_cast<IOSysFsGPIO*>(io.get())->setupGPIOs(0,1,2,3);
  }
  
  Jtag jtag = Jtag(io.get());
  jtag.setVerbose(verbose);

  if (init_chain(jtag, db))
    id = get_id (jtag, db, chainpos);
  else
    id = 0;
  if(chaintest && !spiflash)
    test_IRChain(&jtag, io.get(), db, test_count);

  if (detectchain && !spiflash)
    {
      detect_chain(&jtag, &db);
      return 0;
    }

  if (id == 0)
    return 2;

  unsigned int family = IDCODE_TO_FAMILY(id);
  unsigned int manufacturer = IDCODE_TO_MANUFACTURER(id);

  if (nchainpos != 1 &&
      (manufacturer != MANUFACTURER_XILINX || family != FAMILY_XCF)) 
    {
      fprintf(stderr, "Multiple positions only supported in case of XCF\n");
      usage(false);
    }

  if(spiflash)
      return programSPI(jtag, argc, args, verbose, erase,
                        reconfigure, test_count, 
                        bscanfile, family, db.idToDescription(id));
  else if (manufacturer == MANUFACTURER_XILINX)
    {
      /* Probably XC4V and XC5V should work too. No devices to test at IKDA */
      if( (family == FAMILY_XC2S) ||
	  (family == FAMILY_XC2SE) ||
	  (family == FAMILY_XC4VLX) ||
	  (family == FAMILY_XC4VFX) ||
	  (family == FAMILY_XC4VSX) ||
	  (family == FAMILY_XC3S) ||
	  (family == FAMILY_XC3SE) ||
	  (family == FAMILY_XC3SA) ||
	  (family == FAMILY_XC3SAN) ||
	  (family == FAMILY_XC3SD) ||
	  (family == FAMILY_XC6S) ||
	  (family == FAMILY_XC2V) ||
          (family == FAMILY_XC5VLX) ||
          (family == FAMILY_XC5VLXT) ||
          (family == FAMILY_XC5VSXT) ||
          (family == FAMILY_XC5VFXT) ||
          (family == FAMILY_XC5VTXT) ||
          (family == FAMILY_XC7)
	  )
          return  programXC3S(jtag, argc, args, verbose,
                              reconfigure, family);
  
      else if (family == FAMILY_XCF)
      {
          return programXCF(jtag, db, argc, args, verbose,
                            erase, reconfigure,
                            db.idToDescription(id),
                            chainpositions, nchainpos, xcfopts);
      }
      else if( family == 0x4b) /* XC95XL XC95XV*/
	{
	  return programXC95X(jtag, id, argc,args, verbose, erase,
			      db.idToDescription(id));
	}
      else if ((family & 0x7e) == 0x36) /* XC2C */
	{
            return programXC2C(jtag, id, argc, args, verbose, erase,
                               mapdir, db.idToDescription(id));
	}
      else 
	{
	  fprintf(stderr,
		  "Sorry, can't program Xilinx device '%s' from family 0x%02x "
		  "A more recent release may be able to.\n", 
		  db.idToDescription(id), family);
	  return 1;
	}
    }
  else if  ( manufacturer == MANUFACTURER_ATMEL)
    {
	switch(db.idToIDCmd(id))
	{
	case 3:
	    return programXMega(&jtag, id, argc, args, verbose, erase, reconfigure,
				db.idToDescription(id));
	default:
	    return jAVR (jtag, id, args[0],verify, lock, eepromfile, fusefile);
	}
    }
  else
    fprintf(stderr,
	    "Sorry, can't program device '%s' from manufacturer 0x%02x "
	    "A more recent release may be able to.\n", 
	    db.idToDescription(id), manufacturer);
  return 1;
}

ProgAlg * makeProgAlg(Jtag &jtag, unsigned long id,
                      const vector<string>& xcfopts, bool checkopts)
{
  if ((id & 0x000f0000) == 0x00050000)
    {
      // XCFxxP
      ProgAlgXCFP *alg = new ProgAlgXCFP(jtag, id);
      for (size_t i = 0; i < xcfopts.size(); i++)
        {
          const char *opt = xcfopts[i].c_str();
          if (strcasecmp(opt, "parallel") == 0)
            alg->setParallelMode(true);
          else if (strcasecmp(opt, "serial") == 0)
            alg->setParallelMode(false);
          else if (strcasecmp(opt, "master") == 0)
            alg->setMasterMode(true);
          else if (strcasecmp(opt, "slave") == 0)
            alg->setMasterMode(false);
          else if (strcasecmp(opt, "fastclk") == 0)
            alg->setFastClock(true);
          else if (strcasecmp(opt, "slowclk") == 0)
            alg->setFastClock(false);
          else if (strcasecmp(opt, "extclk") == 0)
            alg->setExternalClock(true);
          else if (strcasecmp(opt, "intclk") == 0)
            alg->setExternalClock(false);
          else if (checkopts)
            fprintf(stderr, "Ignoring unknown option '%s' for XCFxxP device\n", xcfopts[i].c_str());
        }
      return alg;
    }
  else
    {
      // XCFxxS
      if (checkopts)
        {
          for (size_t i = 0; i < xcfopts.size(); i++)
            fprintf(stderr, "Ignoring unknown option '%s' for XCFxxS device\n", xcfopts[i].c_str());
        }
      return new ProgAlgXCF(jtag, (id & 0x000ff000) >> 12);
    }
}

int programXC3S(Jtag &jtag, int argc, char** args,
                bool verbose, bool reconfig, int family)
{

  ProgAlgXC3S alg(jtag, family);
  int i;

  if(reconfig)
      alg.reconfig();
  else
  {
      for(i=0; i< argc; i++)
      {
          int res;
          unsigned int bitfile_offset = 0;
          unsigned int bitfile_length = 0;
          char action = 'w';
          FILE_STYLE bitfile_style = STYLE_BIT;
          FILE *fp;
          BitFile bitfile;
          
          fp = getFile_and_Attribute_from_name
              (args[i], &action, NULL, &bitfile_offset,
               &bitfile_style, &bitfile_length);
          if (tolower(action) != 'w')
          {
              if (verbose)
              {
                  fprintf(stderr,"Action %c not supported for XC3S\n", action);
              }
              continue;
          }
          if( bitfile_offset != 0)
          {
              if (verbose)
              {
                  fprintf(stderr,"Offset %d not supported for XC3S\n",
                      bitfile_offset);
              }
              continue;
          }
          if( bitfile_length != 0)
          {
              if (verbose)
              {
                  fprintf(stderr,"Length %d not supported for XC3S\n",
                      bitfile_length);
              }
              continue;
          }
          res = bitfile.readFile(fp, bitfile_style);
          if (res != 0)
          {
              if (verbose)
              {
                  fprintf(stderr,"Reading Bitfile %s failed\n",
                      args[i]);
              }
              continue;
          }
 
          if(verbose) 
          {
              fprintf(stderr, "Created from NCD file: %s\n",
                      bitfile.getNCDFilename());
              fprintf(stderr, "Target device: %s\n",
                      bitfile.getPartName());
              fprintf(stderr, "Created: %s %s\n",
                      bitfile.getDate(), bitfile.getTime());
              fprintf(stderr, "Bitstream length: %u bits\n",
                      bitfile.getLength());
          }
          alg.array_program(bitfile);
      }
  }
  return 0;
}

int programXCF(Jtag &jtag, DeviceDB &db, int argc, char **args,
               bool verbose, bool erase, bool reconfigure,
               const char *device, int *chainpositions, int nchainpos,
               const vector<string>& xcfopts)
{
  // identify all specified devices
  unsigned int total_size = 0;

  for (int k = 0; k < nchainpos; k++)
    {
      unsigned long id = get_id(jtag, db, chainpositions[k]);
      if (IDCODE_TO_MANUFACTURER(id) != MANUFACTURER_XILINX ||
          IDCODE_TO_FAMILY(id) != FAMILY_XCF)
        {
          fprintf(stderr, "Multiple positions only supported in case of XCF\n");
          usage(false);
        }
      std::auto_ptr<ProgAlg> alg(makeProgAlg(jtag, id, xcfopts, true));
      total_size += alg->getSize();
    }

  if (erase)
  {
      for (int k = 0; k < nchainpos; k++)
      {
          unsigned long id = get_id(jtag, db, chainpositions[k]);
          std::auto_ptr<ProgAlg> alg(makeProgAlg(jtag, id, xcfopts, false));
          alg->erase();
      }
  }

  for (int i = 0; i < argc; i++)
  {
      unsigned int promfile_offset = 0; /* Where to start in the XCF space */
      unsigned int promfile_rlength = 0;/* How many bytes to process */
      unsigned int prom_pos = 0;        /* Current byte position in XCF space */
      char action = 'w';
      BitFile promfile;
      FILE_STYLE  promfile_style = STYLE_BIT;
      
      FILE *promfile_fp = 
          getFile_and_Attribute_from_name
          (args[i], &action, NULL, &promfile_offset,
           &promfile_style, &promfile_rlength);
      if (!promfile_fp)
          continue;

      promfile.setOffset(promfile_offset);
      promfile.setRLength(promfile_rlength);

      if (action == 'v' || tolower(action) == 'w')
      {
          promfile.readFile(promfile_fp, promfile_style);

          // If no explicit length requested, default to complete file.
          if (promfile_rlength == 0)
            promfile_rlength = promfile.getLength() / 8;
      }
      else if(action == 'r')
      {
          // If no length requested, default to complete PROM space.
          if (promfile_rlength == 0)
            promfile_rlength = total_size / 8 - promfile_offset;
          promfile.setLength(promfile_rlength * 8);
      }

      if (promfile_rlength > promfile.getLength() / 8)
      {
          fprintf(stderr, "Requested length (%u bytes) exceeds bitfile size (%u bytes)\n", promfile_rlength, promfile.getLength() / 8);
          continue;
      }

      if (promfile_offset > total_size / 8 ||
          promfile_rlength > total_size / 8 - promfile_offset)
      {
          fprintf(stderr, "Requested operation (offset %u, length %u bytes) exceeds PROM space (%u bits)\n", promfile_offset, promfile_rlength, total_size);
          continue;
      }

      for (int k = 0; k < nchainpos; k++)
      {
          unsigned long id = get_id(jtag, db, chainpositions[k]);
          std::auto_ptr<ProgAlg> alg(makeProgAlg(jtag, id, xcfopts, false));
          BitFile tmp_bitfile;
          BitFile &cur_bitfile = (nchainpos == 1) ? promfile : tmp_bitfile;
          unsigned int current_promlen = alg->getSize() / 8;
          unsigned int current_offset = 0;
          unsigned int current_rlength = 0;

          if (prom_pos + current_promlen <= promfile_offset)
          {
              // current PROM falls before requested range
              prom_pos += current_promlen;
              continue;
          }
          else if (prom_pos < promfile_offset)
          {
              // requested range starts inside current PROM
              current_offset = promfile_offset - prom_pos;
          }

          if (prom_pos >= promfile_offset + promfile_rlength)
          {
              // current PROM falls behind the requested range
              break;
          }
          else if (prom_pos + current_promlen > promfile_offset + promfile_rlength)
          {
              // requested range ends inside current PROM
              current_rlength = promfile_offset + promfile_rlength - prom_pos - current_offset;
          }

          cur_bitfile.setOffset(current_offset);
          if (current_rlength * 8 != cur_bitfile.getLength())
            cur_bitfile.setRLength(current_rlength);
          else
            cur_bitfile.setRLength(0);

          if (action == 'r')
          {
              alg->read(cur_bitfile);
              if (nchainpos != 1)
              {
                  // copy temp data to selected part of output file
                  assert(cur_bitfile.getLength() % 8 == 0);
                  assert(prom_pos - promfile_offset + tmp_bitfile.getLength() / 8 <= promfile.getLength() / 8);
                  memcpy(promfile.getData() + prom_pos - promfile_offset, tmp_bitfile.getData(), tmp_bitfile.getLength() / 8);
              }
          }
          else
          {
              if (nchainpos != 1)
              {
                  // copy selected part of input file to temp object
                  unsigned int n = current_rlength ? current_rlength : (current_promlen - current_offset);
                  assert(prom_pos - promfile_offset + n <= promfile.getLength() / 8);
                  tmp_bitfile.setLength(n * 8);
                  memcpy(tmp_bitfile.getData(), promfile.getData() + prom_pos - promfile_offset, n);
              }
              if (tolower(action) == 'w')
              {
                  int res;
                  if (action == 'w')
                  {
                      res = alg->erase();
                      if (res)
                          return res;
                  }
                  res = alg->program(cur_bitfile);
                  if (res)
                  {
                      alg->disable();
                      return res;
                  }
              }
              alg->verify(cur_bitfile);
              alg->disable();
          }

          prom_pos += current_promlen;
      }

      // write output file
      if (action == 'r')
          promfile.saveAs(promfile_style, device, promfile_fp);
  }

  // send reconfiguration cmd to first device
  if (reconfigure)
  {
      unsigned long id = get_id(jtag, db, chainpositions[0]);
      std::auto_ptr<ProgAlg> alg(makeProgAlg(jtag, id, xcfopts, false));
      alg->reconfig();
  }
  return 0;
}


int programSPI(Jtag &jtag, int argc, char ** args, bool verbose, bool erase,
               bool reconfig,  int test_count,
               char *bscanfile, int family, const char *device)
{
    int i;
    ProgAlgSPIFlash alg(jtag);
    
    if (bscanfile)
    {
        programXC3S(jtag, 1, &bscanfile, verbose, 0, family);
    }

    if (alg.spi_flashinfo() != 1 && !reconfig)
    {
        fprintf(stderr,"ISF Bitfile probably not loaded\n");
        return 2;
    }

    if (test_count)
    {
        alg.test(test_count);
        goto test_reconf;
    }

    if(erase)
    {
        alg.erase();
    }

    for(i=0; i< argc; i++)
    {
        unsigned int spifile_offset = 0;
        unsigned int spifile_rlength = 0;
        int ret = 0;
        char action = 'w';
        BitFile spifile;
        FILE_STYLE  spifile_style = STYLE_BIT;
 
        FILE *spifile_fp = 
            getFile_and_Attribute_from_name
            (args[i], &action, NULL, &spifile_offset,
                 &spifile_style, &spifile_rlength);
        if(!spifile_fp)
            continue;
        spifile.setOffset(spifile_offset);
        spifile.setRLength(spifile_rlength);
        if (action == 'r')
        {
            alg.read(spifile);
            spifile.saveAs(spifile_style, device, spifile_fp);
        }
        else if (action == 'v')
        {
            spifile.readFile(spifile_fp, spifile_style);
            ret = alg.verify(spifile);
        }
        else
        {
            spifile.readFile(spifile_fp, spifile_style);
            fclose(spifile_fp);
            spifile_fp = NULL;
            if(verbose)
            {
                fprintf(stderr, "Created from NCD file: %s\n",
                        spifile.getNCDFilename());
                fprintf(stderr, "Target device: %s\n",
                        spifile.getPartName());
                fprintf(stderr, "Created: %s %s\n",
                        spifile.getDate(),spifile.getTime());
                fprintf(stderr, "Bitstream length: %u bits\n",
                        spifile.getLength());
            }
            ret = alg.program(spifile);
            if (ret == 0 )
                ret = alg.verify(spifile);
        }
        if (spifile_fp)
            fclose(spifile_fp);
        if (ret != 0)
            return ret;
    }
test_reconf:
    if(reconfig)
    {
        ProgAlgXC3S fpga(jtag, family);
        fpga.reconfig();
    }
    return 0;
}

int programXC95X(Jtag &jtag, unsigned long id, int argc, char **args, 
                 bool verbose, bool erase, const char *device)
{
    int i, size = (id & 0x000ff000)>>13;
    ProgAlgXC95X alg(jtag, size);
    
    if (erase)
    {
        alg.erase();
    }
    
    for (i = 0; i< argc; i++)
    {
        int ret = 0;
        unsigned int jedecfile_offset = 0;
        unsigned int jedecfile_rlength = 0;
        char action = 'w';
        JedecFile  jedecfile;
        FILE_STYLE  jedecfile_style= STYLE_JEDEC;
             
        if (i>1)
        {
            fprintf(stderr, "Multiple arguments not supported: %s\n", args[i]);
            continue;
        }
        
        FILE *jedecfile_fp = 
            getFile_and_Attribute_from_name
            (args[i], &action, NULL, &jedecfile_offset,
             &jedecfile_style, &jedecfile_rlength);
        
        if (jedecfile_offset != 0)
        {
            fprintf(stderr, "Offset %d not supported, Using 0\n", 
                    jedecfile_offset);
            jedecfile_offset = 0;
        }
        if (jedecfile_rlength != 0)
        {
            fprintf(stderr, "Readlength %d not supported, Using 0\n", 
                    jedecfile_rlength);
            jedecfile_rlength = 0;
        }
        if(jedecfile_style != STYLE_JEDEC)
        {
            fprintf(stderr, "Style %s not supported, skipping\n",
                    BitFile::styleToString(jedecfile_style));
        }
        if (action == 'r')
        {
            alg.array_read(jedecfile);
            jedecfile.saveAsJed(device, jedecfile_fp);
        }
        else if (action == 'v' || tolower(action) == 'w') 
        {
            jedecfile.readFile(jedecfile_fp);
            if (action == 'w')
            {
                if (!erase)
                {
                    ret = alg.erase();
                }
	    }
	    if(tolower(action) == 'w')
                alg.array_program(jedecfile);
            ret = alg.array_verify(jedecfile);
        }
        if(ret)
            return ret;
    }
    return 0;
}

int programXC2C( Jtag &jtag, unsigned int id, int argc, char ** args, 
                 bool verbose, bool erase, const char *mapdir,
                 const char *device)
{
    int i, ret;
    int size_ind = (id & 0x001f0000)>>16;
    bool map_available = false;
    MapFile_XC2C map;
 
    if (map.loadmapfile(mapdir, device))
    {
        // map.GetFilename() isn't defined if loadmapfile fails().
        // (It will also output its own error message.)
        fprintf(stderr, "No mapfile available -- only bitfile (not JEDEC) "
                "operations will be supported.\n");
    }
    else
        map_available = true;
    
    if (erase)
    {
        ProgAlgXC2C alg(jtag, size_ind);
        alg.erase();
        ret = alg.blank_check();
        if (ret != 0)
        {
            fprintf(stderr,"Erase failed\n");
            return ret;
        }
    }
    
    for (i = 0; i< argc; i++)
    {
        int ret = 0;
        unsigned int file_offset = 0;
        unsigned int file_rlength = 0;
        char action = 'w';
        BitFile  file;
        JedecFile  fuses;
        FILE_STYLE file_style= (map_available)?STYLE_JEDEC:STYLE_BIT;
             
        FILE *fp = 
            getFile_and_Attribute_from_name
            (args[i], &action, NULL, &file_offset,
             &file_style, &file_rlength);
        
        if (i>1)
        {
            fprintf(stderr, "Multiple arguments not supported: %s\n", args[i]);
            continue;
        }
        
        if (file_offset != 0)
        {
            fprintf(stderr, "Offset %d not supported, Using 0\n", file_offset);
            file_offset = 0;
        }
        if (file_rlength != 0)
        {
            fprintf(stderr, "Readlength %d not supported, Using 0\n", 
                    file_rlength);
            file_rlength = 0;
        }
        if(action == 'r') /* Readback requested*/
        {
            ProgAlgXC2C alg(jtag, size_ind);

            alg.array_read(file);
            if (map_available && file_style == STYLE_JEDEC)
            {
                map.bitfile2jedecfile(&file, &fuses);
                fuses.saveAsJed( device, fp);
            }
            else
                file.saveAs(file_style, device, fp);
            ret = 0;
        }
        else if (action == 'v' || tolower(action) == 'w')
        {
            /* Load file */
            if (map_available && file_style == STYLE_JEDEC)
            {
                ret = fuses.readFile(fp);
                if (ret)
                    fprintf(stderr, "Probably no JEDEC File, aborting\n");
                else
                    /*FIXME ret = */
                    map.jedecfile2bitfile(&fuses, &file);
            }
            else 
            {
                fprintf(stderr,"Reading style %s\n",
                        file.styleToString(file_style));
                file.readFile(fp, file_style);
                if (file.getLength() == 0)
                {
                    fprintf(stderr, "Probably no Bitfile, aborting\n");
                    return 2;
                }
            }
            if(strncmp(device,
                       (map_available)?fuses.getDevice():file.getPartName(),
                       sizeof("XC2CXX")) !=0)
            {
                fprintf(stderr, "Incompatible File for Device %s\n"
                        "Actual device in Chain is %s\n", 
                            (map_available)?fuses.getDevice():
                        file.getPartName(), 
                        device);
                ret = 3;
            }
            
            if (ret == 0)
            {
                ProgAlgXC2C alg(jtag, size_ind);

                if(tolower(action) == 'w')
                {
                    if (!erase && (action == 'w'))
                    {
                        alg.erase();
                        ret = alg.blank_check();
                    }
                    if (ret == 0)
                    {
                        alg.array_program(file);
                    }
                }
                ret = alg.array_verify(file);
                alg.done_program();
            }
        }
 
        if(fp)
            fclose(fp);
        if (ret)
            return ret;
    }
    return 0;
}

int programXMega(Jtag *jtag, unsigned long id, int argc, char **args, 
		 bool verbose, bool erase, bool reconfigure,
		 const char *device)
{
    int i,ret = 0;
    enum PDI_STATUS_CODE res;
    uint32_t appl_size, boot_size, eeprom_size, eeprom_page = 0x20;
    uint32_t flash_page = 0x200;
    uint8_t bypass = 0;
    
    PDIoverJTAG protocol (jtag, 0x7);
    ProgAlgNVM alg(&protocol);

    switch((id >>12)& 0xffff)
    {
    case 0x9642:
    case 0x964c:
    case 0x964e:
	appl_size   = 0x10000;
	boot_size   = 0x01000;
	eeprom_size = 0x00800;
        flash_page  = 0x100;
	break;
    case 0x974a:
    case 0x974c:
	appl_size   = 0x20000;
	boot_size   = 0x02000;
	eeprom_size = 0x00800;
	break;
    case 0x9842:
    case 0x9843:
	appl_size   = 0x40000;
	boot_size   = 0x02000;
	eeprom_size = 0x01000;
	break;
    default:
	fprintf(stderr,"Unknown/Unhandled XMega device 0x%08lx\n", id);
	return 1;
    }

    res = alg.xnvm_init();
    if(res != STATUS_OK)
    {
	fprintf(stderr, "Init Xmega PDI programming failed\n");
	return 1;
    }

    if (verbose)
    {
        uint8_t device_id[5];
        uint8_t fuses[8];
        uint8_t row[200];
        alg.xnvm_read_memory(0x1000090, device_id, 5);
        fprintf(stderr,"DeviceID from MCU_CONTROL 0x%02x%02x%02x Rev %c"
                " JTAGUID %02x\n", 
                device_id[0],device_id[1], device_id[2],'A'+ device_id[3],
                device_id[4]
            );
        alg.xnvm_read_memory(0x08f0020, fuses, 8);
        fprintf(stderr,"Fuses U:%02x W:%02x R:%02x S:%02x V:%02x L:%02x\n",
                fuses[0], fuses[1], fuses[2], fuses[4], fuses[5], fuses[7]);
        alg.xnvm_read_memory(0x08e0200, row, 200);
        fprintf(stderr,"Lot:%02x%02x%02x%02x%02x%02x Wafer:%02x "
                "X:%02x%02x Y:%02x%02x\n",
                row[0xd], row[0xc], row[0xb], row[0xa], row[9], row[8],
                row[0x10], row[0x13], row[0x12], row[0x15], row[0x14]);
       
       
    }
    if(erase)
    {
	res = alg.xnvm_chip_erase();
	if (res != STATUS_OK)
	{
	    fprintf(stderr, "Xmega PDI chip erase failed\n");
            ret = 1;
            goto xmega_release;
	}
    }
    for (i = 0; i< argc; i++)
    {
	char section = 'a';
	unsigned int file_offset = 0;
        unsigned int file_rlength = 0;
        char action = 'w';
        BitFile  file;
        FILE_STYLE file_style= STYLE_IHEX;
	uint32_t base = 0x800000;
	unsigned int length;
             
        FILE *fp = 
            getFile_and_Attribute_from_name
            (args[i], &action, &section, &file_offset,
             &file_style, &file_rlength);
        if((action != 'e') && !fp)
            continue;
 
	switch (section)
	{
	case 'a':
	    length =  appl_size;
	    break;
	case 'b':
	    base += appl_size;
	    length = boot_size;
	    break;
	case 'e':
	    base = 0x8c0000;
	    length = eeprom_size;
	    break;
	case 'p':
	    base = 0x8e0200;
	    length = 0x40;
	    break;
	case 'u':
	    base = 0x8e0400;
	    length = flash_page;
	    break;
	case 'f':
	    base = 0x8f0020;
	    length = 8;
	    break;
	case 'l':
	    base = 0x8f0027;
	    length = 1;
	    break;
	default:
	    fprintf(stderr,"Unknown section %c\n", section);
	    continue;
	}

	if (file_rlength != 0)
	{
	    length = file_rlength;
	}
	if (file_offset != 0)
	    file.setOffset(file_offset);
	else
	    file.setOffset(length);

	    
	if (action == 'r')
	{
	    uint32_t res;

	    file.setLength(length *8);
             /* Inhibit clipping of trailing 0xff's for fuses and lock*/
            if ((section == 'f') || (section == 'l'))
                 file.setRLength(length);

	    res = alg.xnvm_read_memory(base + file_offset, file.getData(), length);
	    if(res != length)
	    {
		fprintf(stderr, "Xmega PDI Reading Section %c failed:"
                        " read 0x%06x vs requested 0x%06x\n", 
			section, res, length);
                res = 1;
                goto xmega_release;
	    }
	    file.saveAs(file_style, device, fp);
 
	}
        else if (action == 'v')
        {
	    uint32_t j, res;
            BitFile  vfile;
            vfile.readFile(fp, file_style);
            length = vfile.getLength()/8;
	    file.setLength(length *8);
	    res = alg.xnvm_read_memory(base, file.getData(), length);
	    if(res != length)
	    {
		fprintf(stderr, "Xmega PDI Verify Section %c failed:"
                        " 0x%06x read vs 0x%06x req\n", 
			section, res, length);
                    ret = 1;
                    goto xmega_release;
		
	    }
            for(j=0; j<length; j++)
            {
                if(file.getData()[j] != vfile.getData()[j])
                {
                    fprintf(stderr, "Verify mismath at section %c pos 0x%06x:"
                            " 0x%02x vs 0x%02x\n", 
                            section, j, file.getData()[j], vfile.getData()[j]);
                    ret = 1;
                    goto xmega_release;
                }  
            }
            fprintf(stderr,"Verify %s success\n", args[i]);
        }

 	else if ((action == 'e') || (tolower(action) == 'w'))
	{
            BitFile  rfile;
            rfile.readFile(fp, file_style);
            unsigned int i, length = rfile.getLength()/8;

            if (!erase && ((action == 'w') || (action == 'e')))
            {
                switch (section)
                {
                case 'a':
                    res = alg.xnvm_application_erase();
                    break;
                case 'b':
                    res = alg.xnvm_boot_erase(base);
                    break;
                case 'e':
                    res = alg.xnvm_erase_eeprom();
                    break;
                case 'u':
                    res = alg.xnvm_erase_user_sign();
                    break;
                case 'l':
                case 'f':
                    break;
                default:
                        fprintf(stderr, "No action \"erase\" for section %c\n",
                                section);
                    continue;
                }
                if (res)
                {
                    fprintf(stderr, "Erase failed for section %c\n",
                            section);
                    ret = 1;
                    goto xmega_release;
                }
                if (action == 'e')
                    continue;
            }

            switch (section)
            {
            case 'a':
            case 'b':
            case 'u':
            {
                uint32_t offset = (file_offset/flash_page)*flash_page;
                for (i= offset; i<length; i+=flash_page)
                {
                    if (action == 'w')
                    {
                        res = alg.xnvm_program_flash_page
                            (base + i, rfile.getData()+i, flash_page);
                    }
                    else
                        res = alg.xnvm_erase_program_flash_page                            
                            (base +i, rfile.getData()+i, flash_page);
                    if(res)
                    {
                        fprintf(stderr, 
                                "Write failed for section %c Addr 0x%06x\n",
                                section, i);
                        ret = 1;
                        goto xmega_release;
                    }
                }
            }
            break;
            case 'e':
            {
                uint32_t offset = (file_offset/eeprom_page)*eeprom_page;
                for (i= offset; i<length; i+=eeprom_page)
                {
                    res = alg.xnvm_erase_program_eeprom_page
                        (i,rfile.getData()+i, eeprom_page); 
                    if(res)
                    {
                        fprintf(stderr, 
                                "Write failed for EEPROM Addr 0x%06x\n", i);
                        ret = 1;
                        goto xmega_release;
                    }
                   break;
                }
            }
            break;
            case 'f':
            {
                uint32_t j , fuse = file_offset;
                
                for (j= fuse; j<length; j++)
                {
                    uint8_t data = rfile.getData()[j];
                    if ((j == 3) || (j == 6))
                        /* skip reserved fuses*/
                        continue;
                    if ((j == 4)  && ((data & 1) == 1))
                    {
                        if (action == 'w')
                        {
                            fprintf(stderr, "JTAGEN should probably be set. Correcting\n");
                            fprintf(stderr, "If really wanted, Use action 'W'\n");
                            data &= 0xfe;
                        }
                    }
                        
#if 0
                    res = alg.xnvm_write_fuse_byte(j, data); 
                    if(res)
                    {
                        fprintf(stderr, 
                                "Write Fuse %d failed\n", j);
                        ret = 1;
                        goto xmega_release;
                    }
#else
                    fprintf(stderr, "Fuse %d val %02x\n", j, data);
#endif
                }
            }
            break;
            case 'l':
//                res = alg.xnvm_write_lock_byte(rfile.getData()[0]); 
                if(res)
                {
                    fprintf(stderr, 
                            "Write Lock failed\n");
                    ret = 1;
                    goto xmega_release;
                }
                break;
            default:
                fprintf(stderr,"Write to section \'%c\' not handled\n",section);
            }
        }
    }
xmega_release:    
    alg.xnvm_pull_dev_out_of_reset();
    jtag->shiftIR(&bypass);
    return ret;
}
