fabianupn/FabianRuizEmbebidos/onion/xc3sprog_programa_manual/xc3sprog-master/bscan_spi/xc3sa_vq100.ucf

net "MISO" LOC = "P51";
net "MOSI" LOC = "P46";
net "DRCK1" LOC= "P53";
net "CSB"  LOC = "P27";
