fabianupn/FabianRuizEmbebidos/onion/xc3sprog_programa_manual/xc3sprog-master/bscan_spi/xc6s_cs324.ucf

net "MISO" LOC = "R13";
net "MOSI" LOC = "T13";
net "DRCK1" LOC= "R15";
net "CSB"  LOC = "V3";
