fabianupn/FabianRuizEmbebidos/onion/xc3sprog_programa_manual/xc3sprog-master/bscan_spi/xc6s_fg484.ucf

CONFIG VCCAUX = 3.3;
NET "*" IOSTANDARD = LVCMOS33;

net "MISO" LOC = "AA20";
net "MOSI" LOC = "AB20";
net "DRCK1" LOC= "Y21";
net "CSB"  LOC = "T5";
