fabianupn/FabianRuizEmbebidos/libftd2xx1.0.4/libusb-1.0.8/libusb/os/darwin_usb.c

/*
 * darwin backend for libusb 1.0
 * Copyright (C) 2008-2010 Nathan Hjelm <hjelmn@users.sourceforge.net>
 *
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
 * You should have received a copy of the GNU Lesser General Public
 * License along with this library; if not, write to the Free Software
 * Foundation, Inc., 51 Franklin Street, Fifth Floor, Boston, MA 02110-1301 USA
 */

#include <config.h>
#include <ctype.h>
#include <dirent.h>
#include <errno.h>
#include <fcntl.h>
#include <pthread.h>
#include <stdio.h>
#include <stdlib.h>
#include <string.h>
#include <sys/ioctl.h>
#include <sys/stat.h>
#include <sys/types.h>
#include <unistd.h>

#include <mach/clock.h>
#include <mach/clock_types.h>
#include <mach/mach_host.h>

#include <mach/mach_port.h>
#include <IOKit/IOCFBundle.h>
#include <IOKit/usb/IOUSBLib.h>
#include <IOKit/IOCFPlugIn.h>

#include "darwin_usb.h"

static mach_port_t  libusb_darwin_mp = 0; /* master port */
static CFRunLoopRef libusb_darwin_acfl = NULL; /* async cf loop */
static int initCount = 0;

/* async event thread */
static pthread_t libusb_darwin_at;

static int darwin_get_config_descriptor(struct libusb_device *dev, uint8_t config_index, unsigned char *buffer, size_t len, int *host_endian);
static int darwin_claim_interface(struct libusb_device_handle *dev_handle, int iface);
static int darwin_release_interface(struct libusb_device_handle *dev_handle, int iface);
static int darwin_reset_device(struct libusb_device_handle *dev_handle);
static void darwin_async_io_callback (void *refcon, IOReturn result, void *arg0);

static const char *darwin_error_str (int result) {
  switch (result) {
  case kIOReturnSuccess:
    return "no error";
  case kIOReturnNotOpen:
    return "device not opened for exclusive access";
  case kIOReturnNoDevice:
    return "no connection to an IOService";
  case kIOUSBNoAsyncPortErr:
    return "no async port has been opened for interface";
  case kIOReturnExclusiveAccess:
    return "another process has device opened for exclusive access";
  case kIOUSBPipeStalled:
    return "pipe is stalled";
  case kIOReturnError:
    return "could not establish a connection to the Darwin kernel";
  case kIOUSBTransactionTimeout:
    return "transaction timed out";
  case kIOReturnBadArgument:
    return "invalid argument";
  case kIOReturnAborted:
    return "transaction aborted";
  case kIOReturnNotResponding:
    return "device not responding";
  case kIOReturnOverrun:
    return "data overrun";
  case kIOReturnCannotWire:
    return "physical memory can not be wired down";
  default:
    return "unknown error";
  }
}

static int darwin_to_libusb (int result) {
  switch (result) {
  case kIOReturnSuccess:
    return LIBUSB_SUCCESS;
  case kIOReturnNotOpen:
  case kIOReturnNoDevice:
    return LIBUSB_ERROR_NO_DEVICE;
  case kIOReturnExclusiveAccess:
    return LIBUSB_ERROR_ACCESS;
  case kIOUSBPipeStalled:
    return LIBUSB_ERROR_PIPE;
  case kIOReturnBadArgument:
    return LIBUSB_ERROR_INVALID_PARAM;
  case kIOUSBTransactionTimeout:
    return LIBUSB_ERROR_TIMEOUT;
  case kIOReturnNotResponding:
  case kIOReturnAborted:
  case kIOReturnError:
  case kIOUSBNoAsyncPortErr:
  default:
    return LIBUSB_ERROR_OTHER;
  }
}


static int ep_to_pipeRef(struct libusb_device_handle *dev_handle, uint8_t ep, uint8_t *pipep, uint8_t *ifcp) {
  struct darwin_device_handle_priv *priv = (struct darwin_device_handle_priv *)dev_handle->os_priv;

  /* current interface */
  struct __darwin_interface *cInterface;

  int8_t i, iface;

  usbi_info (HANDLE_CTX(dev_handle), "converting ep address 0x%02x to pipeRef and interface", ep);

  for (iface = 0 ; iface < USB_MAXINTERFACES ; iface++) {
    cInterface = &priv->interfaces[iface];

    if (dev_handle->claimed_interfaces & (1 << iface)) {
      for (i = 0 ; i < cInterface->num_endpoints ; i++) {
	if (cInterface->endpoint_addrs[i] == ep) {
	  *pipep = i + 1;
	  *ifcp = iface;
	  usbi_info (HANDLE_CTX(dev_handle), "pipe %d on interface %d matches", *pipep, *ifcp);
	  return 0;
	}
      }
    }
  }

  /* No pipe found with the correct endpoint address */
  usbi_warn (HANDLE_CTX(dev_handle), "no pipeRef found with endpoint address 0x%02x.", ep);
  
  return -1;
}

static int usb_setup_device_iterator (io_iterator_t *deviceIterator) {
  return IOServiceGetMatchingServices(libusb_darwin_mp, IOServiceMatching(kIOUSBDeviceClassName), deviceIterator);
}

static usb_device_t **usb_get_next_device (io_iterator_t deviceIterator, UInt32 *locationp) {
  io_cf_plugin_ref_t *plugInInterface = NULL;
  usb_device_t **device;
  io_service_t usbDevice;
  long result;
  SInt32 score;

  if (!IOIteratorIsValid (deviceIterator))
    return NULL;


  while ((usbDevice = IOIteratorNext(deviceIterator))) {
    result = IOCreatePlugInInterfaceForService(usbDevice, kIOUSBDeviceUserClientTypeID,
					       kIOCFPlugInInterfaceID, &plugInInterface,
					       &score);
    if (kIOReturnSuccess == result && plugInInterface)
      break;

    usbi_dbg ("libusb/darwin.c usb_get_next_device: could not set up plugin for service: %s\n", darwin_error_str (result));
  }

  if (!usbDevice)
    return NULL;

  (void)IOObjectRelease(usbDevice);
  (void)(*plugInInterface)->QueryInterface(plugInInterface, CFUUIDGetUUIDBytes(DeviceInterfaceID),
					   (LPVOID)&device);

  (*plugInInterface)->Stop(plugInInterface);
  IODestroyPlugInInterface (plugInInterface);
  
  (*(device))->GetLocationID(device, locationp);

  return device;
}

static kern_return_t darwin_get_device (uint32_t dev_location, usb_device_t ***darwin_device) {
  kern_return_t kresult;
  UInt32        location;
  io_iterator_t deviceIterator;

  kresult = usb_setup_device_iterator (&deviceIterator);
  if (kresult)
    return kresult;

  /* This port of libusb uses locations to keep track of devices. */
  while ((*darwin_device = usb_get_next_device (deviceIterator, &location)) != NULL) {
    if (location == dev_location)
      break;

    (**darwin_device)->Release(*darwin_device);
  }

  IOObjectRelease (deviceIterator);

  if (!(*darwin_device))
    return kIOReturnNoDevice;

  return kIOReturnSuccess;
}



static void darwin_devices_detached (void *ptr, io_iterator_t rem_devices) {  
  struct libusb_context *ctx = (struct libusb_context *)ptr;
  struct libusb_device_handle *handle;
  struct darwin_device_priv *dpriv;
  struct darwin_device_handle_priv *priv;

  io_service_t device;
  long location;
  CFTypeRef locationCF;
  UInt32 message;

  usbi_info (ctx, "a device has been detached");

  while ((device = IOIteratorNext (rem_devices)) != 0) {
    /* get the location from the i/o registry */
    locationCF = IORegistryEntryCreateCFProperty (device, CFSTR(kUSBDevicePropertyLocationID), kCFAllocatorDefault, 0);

    CFNumberGetValue(locationCF, kCFNumberLongType, &location);
    CFRelease (locationCF);
    IOObjectRelease (device);

    pthread_mutex_lock(&ctx->open_devs_lock);
    list_for_each_entry(handle, &ctx->open_devs, list) {
      dpriv = (struct darwin_device_priv *)handle->dev->os_priv;

      /* the device may have been opened several times. write to each handle's event descriptor */
      if (dpriv->location == location  && handle->os_priv) {
	priv  = (struct darwin_device_handle_priv *)handle->os_priv;

	message = MESSAGE_DEVICE_GONE;
	write (priv->fds[1], &message, sizeof (message));
      }
    }

    pthread_mutex_unlock(&ctx->open_devs_lock);
  }
}

static void darwin_clear_iterator (io_iterator_t iter) {
  io_service_t device;

  while ((device = IOIteratorNext (iter)) != 0)
    IOObjectRelease (device);
}

static void *event_thread_main (void *arg0) {
  IOReturn kresult;
  struct libusb_context *ctx = (struct libusb_context *)arg0;

  /* hotplug (device removal) source */
  CFRunLoopSourceRef     libusb_notification_cfsource;
  io_notification_port_t libusb_notification_port;
  io_iterator_t          libusb_rem_device_iterator;

  usbi_info (ctx, "creating hotplug event source");

  CFRetain (CFRunLoopGetCurrent ());

  /* add the notification port to the run loop */
  libusb_notification_port     = IONotificationPortCreate (libusb_darwin_mp);
  libusb_notification_cfsource = IONotificationPortGetRunLoopSource (libusb_notification_port);
  CFRunLoopAddSource(CFRunLoopGetCurrent (), libusb_notification_cfsource, kCFRunLoopDefaultMode);

  /* create notifications for removed devices */
  kresult = IOServiceAddMatchingNotification (libusb_notification_port, kIOTerminatedNotification,
					      IOServiceMatching(kIOUSBDeviceClassName),
					      (IOServiceMatchingCallback)darwin_devices_detached,
					      (void *)ctx, &libusb_rem_device_iterator);
 
  if (kresult != kIOReturnSuccess) {
    usbi_err (ctx, "could not add hotplug event source: %s", darwin_error_str (kresult));

    pthread_exit ((void *)kresult);
  }

  /* arm notifiers */
  darwin_clear_iterator (libusb_rem_device_iterator);

  /* let the main thread know about the async runloop */
  libusb_darwin_acfl = CFRunLoopGetCurrent ();

  usbi_info (ctx, "libopenusb/darwin.c event_thread_main: thread ready to receive events");

  /* run the runloop */
  CFRunLoopRun();

  usbi_info (ctx, "libopenusb/darwin.c event_thread_main: thread exiting");

  /* delete notification port */
  CFRunLoopSourceInvalidate (libusb_notification_cfsource);
  IONotificationPortDestroy (libusb_notification_port);

  CFRelease (CFRunLoopGetCurrent ());

  libusb_darwin_acfl = NULL;

  pthread_exit (0);
}

static int darwin_init(struct libusb_context *ctx) {
  IOReturn kresult;

  if (!(initCount++)) {
    /* Create the master port for talking to IOKit */
    if (!libusb_darwin_mp) {
      kresult = IOMasterPort (MACH_PORT_NULL, &libusb_darwin_mp);

      if (kresult != kIOReturnSuccess || !libusb_darwin_mp)
	return darwin_to_libusb (kresult);
    }

    pthread_create (&libusb_darwin_at, NULL, event_thread_main, (void *)ctx);

    while (!libusb_darwin_acfl)
      usleep (10);
  }

  return 0;
}

static void darwin_exit (void) {
  if (!(--initCount)) {
    void *ret;

    /* stop the async runloop */
    CFRunLoopStop (libusb_darwin_acfl);
    pthread_join (libusb_darwin_at, &ret);

    if (libusb_darwin_mp)
      mach_port_deallocate(mach_task_self(), libusb_darwin_mp);

    libusb_darwin_mp = 0;
  }
}

static int darwin_get_device_descriptor(struct libusb_device *dev, unsigned char *buffer, int *host_endian) {
  struct darwin_device_priv *priv = (struct darwin_device_priv *)dev->os_priv;

  /* return cached copy */
  memmove (buffer, &(priv->dev_descriptor), DEVICE_DESC_LENGTH);

  *host_endian = 0;

  return 0;
}

static int get_configuration_index (struct libusb_device *dev, int config_value) {
  struct darwin_device_priv *priv = (struct darwin_device_priv *)dev->os_priv;
  UInt8 i, numConfig;
  IOUSBConfigurationDescriptorPtr desc;
  IOReturn kresult;

  /* is there a simpler way to determine the index? */
  kresult = (*(priv->device))->GetNumberOfConfigurations (priv->device, &numConfig);
  if (kresult != kIOReturnSuccess)
    return darwin_to_libusb (kresult);

  for (i = 0 ; i < numConfig ; i++) {
    (*(priv->device))->GetConfigurationDescriptorPtr (priv->device, i, &desc);

    if (libusb_le16_to_cpu (desc->bConfigurationValue) == config_value)
      return i;
  }

  /* configuration not found */
  return LIBUSB_ERROR_OTHER;
}

static int darwin_get_active_config_descriptor(struct libusb_device *dev, unsigned char *buffer, size_t len, int *host_endian) {
  struct darwin_device_priv *priv = (struct darwin_device_priv *)dev->os_priv;
  UInt8 config_value;
  int config_index;
  IOReturn kresult;

  kresult = (*(priv->device))->GetConfiguration (priv->device, &config_value);
  if (kresult != kIOReturnSuccess)
    return darwin_to_libusb (kresult);

  config_index = get_configuration_index (dev, config_value);
  if (config_index < 0)
    return config_index;

  return darwin_get_config_descriptor (dev, config_index, buffer, len, host_endian);
}

static int darwin_get_config_descriptor(struct libusb_device *dev, uint8_t config_index, unsigned char *buffer, size_t len, int *host_endian) {
  struct darwin_device_priv *priv = (struct darwin_device_priv *)dev->os_priv;
  IOUSBConfigurationDescriptorPtr desc;
  IOReturn kresult;
  usb_device_t **device = NULL;

  if (!priv)
    return LIBUSB_ERROR_OTHER;

  if (!priv->device) {
    kresult = darwin_get_device (priv->location, &device);
    if (kresult || !device) {
      usbi_err (DEVICE_CTX (dev), "could not find device: %s", darwin_error_str (kresult));

      return darwin_to_libusb (kresult);
    }

    /* don't have to open the device to get a config descriptor */
  } else
    device = priv->device;

  kresult = (*device)->GetConfigurationDescriptorPtr (device, config_index, &desc);
  if (kresult == kIOReturnSuccess) {
    /* copy descriptor */
    if (libusb_le16_to_cpu(desc->wTotalLength) < len)
      len = libusb_le16_to_cpu(desc->wTotalLength);

    memmove (buffer, desc, len);

    /* GetConfigurationDescriptorPtr returns the descriptor in USB bus order */
    *host_endian = 0;
  }

  if (!priv->device)
    (*device)->Release (device);

  return darwin_to_libusb (kresult);
}

static int process_new_device (struct libusb_context *ctx, usb_device_t **device, UInt32 locationID, struct discovered_devs **_discdevs) {
  struct darwin_device_priv *priv;
  struct libusb_device *dev; 
  struct discovered_devs *discdevs;
  UInt16                address, idVendor, idProduct;
  UInt8                 bDeviceClass, bDeviceSubClass;
  IOUSBDevRequest      req;
  int ret = 0, need_unref = 0;

  do {
    dev = usbi_get_device_by_session_id(ctx, locationID);
    if (!dev) {
      usbi_info (ctx, "allocating new device for location 0x%08x", locationID);
      dev = usbi_alloc_device(ctx, locationID);
      need_unref = 1;
    } else
      usbi_info (ctx, "using existing device for location 0x%08x", locationID);

    if (!dev) {
      ret = LIBUSB_ERROR_NO_MEM;
      break;
    }

    priv = (struct darwin_device_priv *)dev->os_priv;

    /* Set up request for device descriptor */
    req.bmRequestType = USBmakebmRequestType(kUSBIn, kUSBStandard, kUSBDevice);
    req.bRequest      = kUSBRqGetDescriptor;
    req.wValue        = kUSBDeviceDesc << 8;
    req.wIndex        = 0;
    req.wLength       = sizeof(IOUSBDeviceDescriptor);
    req.pData         = &(priv->dev_descriptor);
    
    (*(device))->GetDeviceAddress (device, (USBDeviceAddress *)&address);
    (*(device))->GetDeviceProduct (device, &idProduct);
    (*(device))->GetDeviceVendor (device, &idVendor);
    (*(device))->GetDeviceClass (device, &bDeviceClass);
    (*(device))->GetDeviceSubClass (device, &bDeviceSubClass);

    /**** retrieve device descriptors ****/
    /* device must be open for DeviceRequest */
    (*device)->USBDeviceOpen(device);

    ret = (*(device))->DeviceRequest (device, &req);
    if (ret != kIOReturnSuccess) {
      int try_unsuspend = 1;
#if DeviceVersion >= 320
      UInt32 info;

      /* device may be suspended. unsuspend it and try again */
      /* IOUSBFamily 320+ provides a way to detect device suspension but earlier versions do not */
      (void)(*device)->GetUSBDeviceInformation (device, &info);

      try_unsuspend = info & (1 << kUSBInformationDeviceIsSuspendedBit);
#endif

      if (try_unsuspend) {
	/* resume the device */
	(void)(*device)->USBDeviceSuspend (device, 0);

	ret = (*(device))->DeviceRequest (device, &req);

	/* resuspend the device */
	(void)(*device)->USBDeviceSuspend (device, 1);
      }
    }

    (*device)->USBDeviceClose (device);

    if (ret != kIOReturnSuccess) {
      usbi_warn (ctx, "could not retrieve device descriptor: %s. skipping device", darwin_error_str (ret));
      ret = -1;
      break;
    }

    /**** end: retrieve device descriptors ****/
    
    /* catch buggy hubs (which appear to be virtual). Apple's own USB prober has problems with these devices. */
    if (libusb_le16_to_cpu (priv->dev_descriptor.idProduct) != idProduct) {
      /* not a valid device */
      usbi_warn (ctx, "idProduct from iokit (%04x) does not match idProduct in descriptor (%04x). skipping device",
		 idProduct, libusb_le16_to_cpu (priv->dev_descriptor.idProduct));
      ret = -1;
      break;
    }

    dev->bus_number     = locationID >> 24;
    dev->device_address = address;

    /* save our location, we'll need this later */
    priv->location = locationID;
    snprintf(priv->sys_path, 20, "%03i-%04x-%04x-%02x-%02x", address, idVendor, idProduct, bDeviceClass, bDeviceSubClass);

    ret = usbi_sanitize_device (dev);
    if (ret < 0)
      break;

    /* append the device to the list of discovered devices */
    discdevs = discovered_devs_append(*_discdevs, dev);
    if (!discdevs) {
      ret = LIBUSB_ERROR_NO_MEM;
      break;
    }
    
    *_discdevs = discdevs;
  
    usbi_info (ctx, "found device with address %d at %s", dev->device_address, priv->sys_path);
  } while (0);

  if (need_unref)
    libusb_unref_device(dev);

  return ret;
}

static int darwin_get_device_list(struct libusb_context *ctx, struct discovered_devs **_discdevs) {
  io_iterator_t        deviceIterator;
  usb_device_t         **device;
  kern_return_t        kresult;
  UInt32               location;

  if (!libusb_darwin_mp)
    return LIBUSB_ERROR_INVALID_PARAM;
  
  kresult = usb_setup_device_iterator (&deviceIterator);
  if (kresult != kIOReturnSuccess)
    return darwin_to_libusb (kresult);

  while ((device = usb_get_next_device (deviceIterator, &location)) != NULL) {
    (void) process_new_device (ctx, device, location, _discdevs);

    (*(device))->Release(device);
  }

  IOObjectRelease(deviceIterator);

  return 0;
}

static int darwin_open (struct libusb_device_handle *dev_handle) {
  struct darwin_device_handle_priv *priv = (struct darwin_device_handle_priv *)dev_handle->os_priv;
  struct darwin_device_priv *dpriv = (struct darwin_device_priv *)dev_handle->dev->os_priv;
  usb_device_t  **darwin_device;
  IOReturn kresult;

  if (0 == dpriv->open_count) {
    kresult = darwin_get_device (dpriv->location, &darwin_device);
    if (kresult) {
      usbi_err (HANDLE_CTX (dev_handle), "could not find device: %s", darwin_error_str (kresult));
      return darwin_to_libusb (kresult);
    }

    dpriv->device = darwin_device;

    /* try to open the device */
    kresult = (*(dpriv->device))->USBDeviceOpenSeize (dpriv->device);

    if (kresult != kIOReturnSuccess) {
      usbi_err (HANDLE_CTX (dev_handle), "USBDeviceOpen: %s", darwin_error_str(kresult));

      switch (kresult) {
      case kIOReturnExclusiveAccess:
	/* it is possible to perform some actions on a device that is not open so do not return an error */
	priv->is_open = 0;

	break;
      default:
	(*(dpriv->device))->Release (dpriv->device);
	dpriv->device = NULL;
	return darwin_to_libusb (kresult);
      }
    } else {
      priv->is_open = 1;

      /* create async event source */
      kresult = (*(dpriv->device))->CreateDeviceAsyncEventSource (dpriv->device, &priv->cfSource);

      CFRetain (libusb_darwin_acfl);

      /* add the cfSource to the aync run loop */
      CFRunLoopAddSource(libusb_darwin_acfl, priv->cfSource, kCFRunLoopCommonModes);
    }
  }

  /* device opened successfully */
  dpriv->open_count++;

  /* create a file descriptor for notifications */
  pipe (priv->fds);

  /* set the pipe to be non-blocking */
  fcntl (priv->fds[1], F_SETFD, O_NONBLOCK);

  usbi_add_pollfd(HANDLE_CTX(dev_handle), priv->fds[0], POLLIN);

  usbi_info (HANDLE_CTX (dev_handle), "device open for access");

  return 0;
}

static void darwin_close (struct libusb_device_handle *dev_handle) {
  struct darwin_device_handle_priv *priv = (struct darwin_device_handle_priv *)dev_handle->os_priv;
  struct darwin_device_priv *dpriv = (struct darwin_device_priv *)dev_handle->dev->os_priv;
  IOReturn kresult;
  int i;

  if (dpriv->open_count == 0) {
    /* something is probably very wrong if this is the case */
    usbi_err (HANDLE_CTX (dev_handle), "Close called on a device that was not open!\n");
    return;
  }

  dpriv->open_count--;

  /* make sure all interfaces are released */
  for (i = 0 ; i < USB_MAXINTERFACES ; i++)
    if (dev_handle->claimed_interfaces & (1 << i))
      libusb_release_interface (dev_handle, i);

  if (0 == dpriv->open_count) {
    if (priv->is_open) {
      /* delete the device's async event source */
      if (priv->cfSource) {
	CFRunLoopRemoveSource (libusb_darwin_acfl, priv->cfSource, kCFRunLoopDefaultMode);
	CFRelease (priv->cfSource);
      }

      /* close the device */
      kresult = (*(dpriv->device))->USBDeviceClose(dpriv->device);
      if (kresult) {
	/* Log the fact that we had a problem closing the file, however failing a
	 * close isn't really an error, so return success anyway */
	usbi_err (HANDLE_CTX (dev_handle), "USBDeviceClose: %s", darwin_error_str(kresult));
      }
    }
  
    kresult = (*(dpriv->device))->Release(dpriv->device);
    if (kresult) {
      /* Log the fact that we had a problem closing the file, however failing a
       * close isn't really an error, so return success anyway */
      usbi_err (HANDLE_CTX (dev_handle), "Release: %s", darwin_error_str(kresult));
    }

    dpriv->device = NULL;
  }

  /* file descriptors are maintained per-instance */
  usbi_remove_pollfd (HANDLE_CTX (dev_handle), priv->fds[0]);
  close (priv->fds[1]);
  close (priv->fds[0]);

  priv->fds[0] = priv->fds[1] = -1;
}

static int darwin_get_configuration(struct libusb_device_handle *dev_handle, int *config) {
  struct darwin_device_priv *dpriv = (struct darwin_device_priv *)dev_handle->dev->os_priv;
  UInt8 configNum;
  IOReturn kresult;

  kresult = (*(dpriv->device))->GetConfiguration (dpriv->device, &configNum);
  if (kresult != kIOReturnSuccess)
    return darwin_to_libusb (kresult);

  *config = (int) configNum;

  return 0;
}

static int darwin_set_configuration(struct libusb_device_handle *dev_handle, int config) {
  struct darwin_device_priv *dpriv = (struct darwin_device_priv *)dev_handle->dev->os_priv;
  IOReturn kresult;
  int i;

  /* Setting configuration will invalidate the interface, so we need
     to reclaim it. First, dispose of existing interfaces, if any. */
  for (i = 0 ; i < USB_MAXINTERFACES ; i++)
    if (dev_handle->claimed_interfaces & (1 << i))
      darwin_release_interface (dev_handle, i);

  kresult = (*(dpriv->device))->SetConfiguration (dpriv->device, config);
  if (kresult != kIOReturnSuccess)
    return darwin_to_libusb (kresult);

  /* Reclaim any interfaces. */
  for (i = 0 ; i < USB_MAXINTERFACES ; i++)
    if (dev_handle->claimed_interfaces & (1 << i))
      darwin_claim_interface (dev_handle, i);

  return 0;
}

static int darwin_get_interface (usb_device_t **darwin_device, uint8_t ifc, io_service_t *usbInterfacep) {
  IOUSBFindInterfaceRequest request;
  uint8_t                   current_interface;
  kern_return_t             kresult;
  io_iterator_t             interface_iterator;

  *usbInterfacep = IO_OBJECT_NULL;
  
  /* Setup the Interface Request */
  request.bInterfaceClass    = kIOUSBFindInterfaceDontCare;
  request.bInterfaceSubClass = kIOUSBFindInterfaceDontCare;
  request.bInterfaceProtocol = kIOUSBFindInterfaceDontCare;
  request.bAlternateSetting  = kIOUSBFindInterfaceDontCare;

  kresult = (*(darwin_device))->CreateInterfaceIterator(darwin_device, &request, &interface_iterator);
  if (kresult)
    return kresult;

  for ( current_interface = 0 ; current_interface <= ifc ; current_interface++ )
    *usbInterfacep = IOIteratorNext(interface_iterator);
  
  /* done with the interface iterator */
  IOObjectRelease(interface_iterator);
  
  return 0;
}

static int get_endpoints (struct libusb_device_handle *dev_handle, int iface) {
  struct darwin_device_handle_priv *priv = (struct darwin_device_handle_priv *)dev_handle->os_priv;

  /* current interface */
  struct __darwin_interface *cInterface = &priv->interfaces[iface];

  kern_return_t kresult;

  u_int8_t numep, direction, number;
  u_int8_t dont_care1, dont_care3;
  u_int16_t dont_care2;
  int i;

  usbi_info (HANDLE_CTX (dev_handle), "building table of endpoints.");
  
  /* retrieve the total number of endpoints on this interface */
  kresult = (*(cInterface->interface))->GetNumEndpoints(cInterface->interface, &numep);
  if (kresult) {
    usbi_err (HANDLE_CTX (dev_handle), "can't get number of endpoints for interface: %s", darwin_error_str(kresult));
    return darwin_to_libusb (kresult);
  }

  /* iterate through pipe references */
  for (i = 1 ; i <= numep ; i++) {
    kresult = (*(cInterface->interface))->GetPipeProperties(cInterface->interface, i, &direction, &number, &dont_care1,
							    &dont_care2, &dont_care3);

    if (kresult != kIOReturnSuccess) {
      usbi_err (HANDLE_CTX (dev_handle), "error getting pipe information for pipe %d: %s", i, darwin_error_str(kresult));

      return darwin_to_libusb (kresult);
    }

    usbi_info (HANDLE_CTX (dev_handle), "interface: %i pipe %i: dir: %i number: %i", iface, i, direction, number);

    cInterface->endpoint_addrs[i - 1] = ((direction << 7 & LIBUSB_ENDPOINT_DIR_MASK) | (number & LIBUSB_ENDPOINT_ADDRESS_MASK));
  }

  cInterface->num_endpoints = numep;
  
  return 0;
}

static int darwin_claim_interface(struct libusb_device_handle *dev_handle, int iface) {
  struct darwin_device_priv *dpriv = (struct darwin_device_priv *)dev_handle->dev->os_priv;
  struct darwin_device_handle_priv *priv = (struct darwin_device_handle_priv *)dev_handle->os_priv;
  io_service_t          usbInterface = IO_OBJECT_NULL;
  IOReturn kresult;
  IOCFPlugInInterface **plugInInterface = NULL;
  SInt32                score;
  uint8_t               new_config;

  /* current interface */
  struct __darwin_interface *cInterface = &priv->interfaces[iface];

  kresult = darwin_get_interface (dpriv->device, iface, &usbInterface);
  if (kresult != kIOReturnSuccess)
    return darwin_to_libusb (kresult);

  /* make sure we have an interface */
  if (!usbInterface) {
    u_int8_t nConfig;     /* Index of configuration to use */
    IOUSBConfigurationDescriptorPtr configDesc; /* to describe which configuration to select */
    /* Only a composite class device with no vendor-specific driver will
       be configured. Otherwise, we need to do it ourselves, or there
       will be no interfaces for the device. */

    usbi_info (HANDLE_CTX (dev_handle), "no interface found; selecting configuration" );

    kresult = (*(dpriv->device))->GetNumberOfConfigurations (dpriv->device, &nConfig);
    if (kresult != kIOReturnSuccess) {
      usbi_err (HANDLE_CTX (dev_handle), "GetNumberOfConfigurations: %s", darwin_error_str(kresult));
      return darwin_to_libusb(kresult);
    }
    
    if (nConfig < 1) {
      usbi_err (HANDLE_CTX (dev_handle), "GetNumberOfConfigurations: no configurations");
      return LIBUSB_ERROR_OTHER;
    }

    usbi_info (HANDLE_CTX (dev_handle), "device has %d configuration%s. using the first",
	      (int)nConfig, (nConfig > 1 ? "s" : "") );

    /* Always use the first configuration */
    kresult = (*(dpriv->device))->GetConfigurationDescriptorPtr (dpriv->device, 0, &configDesc);
    if (kresult != kIOReturnSuccess) {
      usbi_err (HANDLE_CTX (dev_handle), "GetConfigurationDescriptorPtr: %s",
		darwin_error_str(kresult));

      new_config = 1;
    } else
      new_config = configDesc->bConfigurationValue;

    usbi_info (HANDLE_CTX (dev_handle), "new configuration value is %d", new_config);

    /* set the configuration */
    kresult = darwin_set_configuration (dev_handle, new_config);
    if (kresult != LIBUSB_SUCCESS) {
      usbi_err (HANDLE_CTX (dev_handle), "could not set configuration");
      return kresult;
    }

    kresult = darwin_get_interface (dpriv->device, iface, &usbInterface);
    if (kresult) {
      usbi_err (HANDLE_CTX (dev_handle), "darwin_get_interface: %s", darwin_error_str(kresult));
      return darwin_to_libusb (kresult);
    }
  }

  if (!usbInterface) {
    usbi_err (HANDLE_CTX (dev_handle), "interface not found");
    return LIBUSB_ERROR_NOT_FOUND;
  }
  
  /* get an interface to the device's interface */
  kresult = IOCreatePlugInInterfaceForService (usbInterface, kIOUSBInterfaceUserClientTypeID,
					       kIOCFPlugInInterfaceID, &plugInInterface, &score);
  if (kresult) {
    usbi_err (HANDLE_CTX (dev_handle), "IOCreatePlugInInterfaceForService: %s", darwin_error_str(kresult));
    return darwin_to_libusb (kresult);
  }

  if (!plugInInterface) {
    usbi_err (HANDLE_CTX (dev_handle), "plugin interface not found");
    return LIBUSB_ERROR_NOT_FOUND;
  }

  /* ignore release error */
  (void)IOObjectRelease (usbInterface);
  
  /* Do the actual claim */
  kresult = (*plugInInterface)->QueryInterface(plugInInterface,
					       CFUUIDGetUUIDBytes(kIOUSBInterfaceInterfaceID),
					       (LPVOID)&cInterface->interface);
  if (kresult || !cInterface->interface) {
    usbi_err (HANDLE_CTX (dev_handle), "QueryInterface: %s", darwin_error_str(kresult));
    return darwin_to_libusb (kresult);
  }
  
  /* We no longer need the intermediate plug-in */
  (*plugInInterface)->Release(plugInInterface);

  /* claim the interface */
  kresult = (*(cInterface->interface))->USBInterfaceOpen(cInterface->interface);
  if (kresult) {
    usbi_err (HANDLE_CTX (dev_handle), "USBInterfaceOpen: %s", darwin_error_str(kresult));
    return darwin_to_libusb (kresult);
  }

  /* update list of endpoints */
  kresult = get_endpoints (dev_handle, iface);
  if (kresult) {
    /* this should not happen */
    darwin_release_interface (dev_handle, iface);
    usbi_err (HANDLE_CTX (dev_handle), "could not build endpoint table");
    return kresult;
  }

  cInterface->cfSource = NULL;

  /* create async event source */
  kresult = (*(cInterface->interface))->CreateInterfaceAsyncEventSource (cInterface->interface, &cInterface->cfSource);
  if (kresult != kIOReturnSuccess) {
    usbi_err (HANDLE_CTX (dev_handle), "could not create async event source");

    /* can't continue without an async event source */
    (void)darwin_release_interface (dev_handle, iface);

    return darwin_to_libusb (kresult);
  }

  /* add the cfSource to the async thread's run loop */
  CFRunLoopAddSource(libusb_darwin_acfl, cInterface->cfSource, kCFRunLoopDefaultMode);

  usbi_info (HANDLE_CTX (dev_handle), "interface opened");

  return 0;
}

static int darwin_release_interface(struct libusb_device_handle *dev_handle, int iface) {
  struct darwin_device_handle_priv *priv = (struct darwin_device_handle_priv *)dev_handle->os_priv;
  IOReturn kresult;

  /* current interface */
  struct __darwin_interface *cInterface = &priv->interfaces[iface];

  /* Check to see if an interface is open */
  if (!cInterface->interface)
    return LIBUSB_SUCCESS;

  /* clean up endpoint data */
  cInterface->num_endpoints = 0;
  
  /* delete the interface's async event source */
  if (cInterface->cfSource) {
    CFRunLoopRemoveSource (libusb_darwin_acfl, cInterface->cfSource, kCFRunLoopDefaultMode);
    CFRelease (cInterface->cfSource);
  }

  kresult = (*(cInterface->interface))->USBInterfaceClose(cInterface->interface);
  if (kresult)
    usbi_err (HANDLE_CTX (dev_handle), "USBInterfaceClose: %s", darwin_error_str(kresult));

  kresult = (*(cInterface->interface))->Release(cInterface->interface);
  if (kresult != kIOReturnSuccess)
    usbi_err (HANDLE_CTX (dev_handle), "Release: %s", darwin_error_str(kresult));

  cInterface->interface = IO_OBJECT_NULL;

  return darwin_to_libusb (kresult);
}

static int darwin_set_interface_altsetting(struct libusb_device_handle *dev_handle, int iface, int altsetting) {
  struct darwin_device_handle_priv *priv = (struct darwin_device_handle_priv *)dev_handle->os_priv;
  IOReturn kresult;

  /* current interface */
  struct __darwin_interface *cInterface = &priv->interfaces[iface];

  if (!cInterface->interface)
    return LIBUSB_ERROR_NO_DEVICE;

  kresult = (*(cInterface->interface))->SetAlternateInterface (cInterface->interface, altsetting);
  if (kresult != kIOReturnSuccess)
    darwin_reset_device (dev_handle);

  /* update list of endpoints */
  kresult = get_endpoints (dev_handle, iface);
  if (kresult) {
    /* this should not happen */
    darwin_release_interface (dev_handle, iface);
    usbi_err (HANDLE_CTX (dev_handle), "could not build endpoint table");
    return kresult;
  }

  return darwin_to_libusb (kresult);
}

static int darwin_clear_halt(struct libusb_device_handle *dev_handle, unsigned char endpoint) {
  struct darwin_device_handle_priv *priv = (struct darwin_device_handle_priv *)dev_handle->os_priv;

  /* current interface */
  struct __darwin_interface *cInterface;
  uint8_t pipeRef, iface;
  IOReturn kresult;

  /* determine the interface/endpoint to use */
  if (ep_to_pipeRef (dev_handle, endpoint, &pipeRef, &iface) != 0) {
    usbi_err (HANDLE_CTX (dev_handle), "endpoint not found on any open interface");

    return LIBUSB_ERROR_NOT_FOUND;
  }

  cInterface = &priv->interfaces[iface];

#if (InterfaceVersion < 190)
  kresult = (*(cInterface->interface))->ClearPipeStall(cInterface->interface, pipeRef);
#else
  /* newer versions of darwin support clearing additional bits on the device's endpoint */
  kresult = (*(cInterface->interface))->ClearPipeStallBothEnds(cInterface->interface, pipeRef);
#endif
  if (kresult)
    usbi_err (HANDLE_CTX (dev_handle), "ClearPipeStall: %s", darwin_error_str (kresult));

  return darwin_to_libusb (kresult);
}

static int darwin_reset_device(struct libusb_device_handle *dev_handle) {
  struct darwin_device_priv *dpriv = (struct darwin_device_priv *)dev_handle->dev->os_priv;
  IOReturn kresult;

  kresult = (*(dpriv->device))->ResetDevice (dpriv->device);
  if (kresult)
    usbi_err (HANDLE_CTX (dev_handle), "ResetDevice: %s", darwin_error_str (kresult));

  return darwin_to_libusb (kresult);
}
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
