fabianupn/FabianRuizEmbebidos/(commit log)

2019-05-16 asignacion pines de control
    [FPGA_spartan6.sch, ONION.sch, STM32_micro.sch, power.sch, power_suply.sch, rf_front_end.sch]
2019-05-27 retoque casi finales
    [FPGA_spartan6.sch, ONION.sch, STM32_micro.sch, power.sch, power_suply.sch, rf_front_end.sch]
2019-05-29 diseño de esquematico
    [FPGA_spartan6.sch, ONION.sch, STM32_micro.sch, power.kicad_pcb, power.sch, power_suply.sch, rf_front_end.sch]
2019-06-01 diseño de esquematico fm
    [FPGA_spartan6.sch, STM32_micro.sch, power.kicad_pcb, rf_front_end.sch]
2019-06-04 diseño de esquematico CASI FINAL
    [FPGA_spartan6.sch, ONION.sch, STM32_micro.sch, power.kicad_pcb, power.sch, power2.kicad_pcb, power_suply.sch, rf_front_end.sch]
2019-06-06 diseño de esquematico arreglo de flechas rojas
    [STM32_micro.sch, power.kicad_pcb]
2019-06-06 Listo solo falta poner nombre
    [power.kicad_pcb]
2019-07-23 programacion luego del diseño del embebido
    [Config.txt, FPGA_spartan6.sch, ONION.sch, Partes_digikey_precio.ods, Partes_digikey_precio_final.ods, Partes_digikey_precio_final.xlsx, STM32_micro.sch, dlp2232m.csv]
2019-07-24 elimivar xc3sprog que no se necesitan
    [dlp2232m.csv, dlp2232m.ods, ft2232_cable.sch, onion.cfg, par_cable.sch]
2019-07-25 archivos necesrios dentro de la onion
    [onion.cfg, sysfsgpio-onion.cfg]
2019-07-26 chibiOS modificado
    [FPGA_spartan6.sch, ONION.sch, Partes_digikey_precio.ods, Partes_digikey_precio_final.ods, Partes_digikey_precio_final.xlsx, STM32_micro.sch, mi_embebido.sch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]
